chiuzz/STM32/Hokai/Software/Ctrl/readme.txt

本实验将实现如下功能：本实验移植的是3.03版本的UCOSIII，支持FPU。本实验通过建立3个简单的任务来测试UCOSIII的移植和FPU的移植是否移植成功。本实验要打开串口调试助手，我们观察到开发板上的LED0和LED1在闪烁，串口调试助手每500ms接收到一次开发板发送的数据，数据以0.01递增。

               	正点原子@ALIENTEK
               	2014-11-3
		广州市星翼电子科技有限公司
                联系电话（传真）：020-38271790
	       	购买：http://shop62103354.taobao.com
                      http://shop62057469.taobao.com
               	技术支持论坛：www.openedv.com
