chiuzz/STM32/Hokai/Hardware/屏背板/JD1622(V3.0).PCB.htm

Altium Reporting Options

# File in Newer Format

Date | : | 2017-7-14
Time | : | AM 10:05:55
Filename | : | E:\2017\TemperatureControl\Hardware\팁교겼\JD1622(V3.0).PCB

Version | Warning
6.9 | CAUTION - File contains one or more Component Bodies containing embedded STEP models. These models have be discarded.
6.9 | CAUTION - File contains one or more Components with pads with Pad Jumper IDs. The pads Pad Jumper ID fields have been discarded.
7.0 | CAUTION - File may contain Component Bodies with linked STEP models. These models will be discarded.
Winter 09 | CAUTION - Vias support varying diameters across layerstack. If this feature is used in design, extra values will be discarded.
Winter 09 | CAUTION - File may contain pads with hole offsets. Hole offset information will be discarded.
Winter 09 | CAUTION - File contains new manufacturing rules. Hole To Hole clearance, Minimum solder mask sliver, Silkscreen Over Exposed Copper and Silkscreen To Silkscreen Clearance rules were introduced in Altium Designer Winter 09.These rules will be discarded.
Winter 09 | CAUTION - 3D models now support texturing.If used in design these textures will be discarded.
Summer 09 | CAUTION - File contains new custom violations that replaced the old violation objects. These violations were introduced in Altium Designer Summer 09. The new custom violations will be discarded.
Summer 09 | CAUTION - Support was added for 32 Mechanical Layers. Objects on mechanical layers beyond 16 have been moved to Mechanical Layer 16.
Summer 09 | CAUTION - File contains assembly testpoint rules and/or settings. Assembly testpoint information will be discarded.
Release 10 | CAUTION - New Custom Grids and Guides were introduced. Be aware that your design might contain Custom Grids and Guides that cannot be read in previous versions.
Release 10 | CAUTION - New Structured Clusters were introduced. Be aware that your design might contain Structured Clusters that cannot be read in previous versions.
Release 10 | CAUTION - New PCB 3D Movie Manager was introduced. Be aware that your design might contain 3D PCB movie that cannot be read in previous versions.

This file was generated by later version of the software
