chiuzz/STM32/Hokai/Hardware/屏背板/屏背板修改事项.docx

屏背板修改事项：

1、 修改RJ45接PE引脚的封装
2、 修改9015/sot-23封装引脚
3、 修改显示屏玻璃控制引脚片1控制端的方向布局。（第一版方向刚好相反了）
4、 对每个IO添加了ESD静电管，
5、 对按键扫描添加了ESD静电管和串接了一个高频扼流圈
6、 74LS245芯片改用74HC245；
7、 铺地安全距离加宽到0.6mm
8、 取消PE铺铜；
9、 修改背光电源引脚的封装，由原来的1.2mm改为2.1mm；
10、 蜂鸣器改为有源5V 型号为KPX-1205;
