chiuzz/STM32/Hokai/Document/基准电源参数.docx

+V | -V | R | VZ | 7号温度 | V0
9.8V | 9.9V | 5.0954 K | 1.2060mV | 28.000 | 621.38
+V | -V | R | VZ | 7号温度 | V0
9.8V | 9.9V | 5.0957K | 1.2060mV | 28.000 | 621.40
