chiuzz/STM32/Hokai/Document/测温传感器数据.docx

体温传感器数据：

sense | 1 | 2 | 3 | 4 | 5 | 6 | 7
VZ | 1.2061V | 1.2061V | | 1.2061V | 1.2061V | 1.2061V | 1.2061V
R（K） | 5.1011 | 5.1011 | | 5.1011 | 5.1011 | 5.1011 | 5.1011
Vo(mV) | 601.86 | 604.42 | | 602.07 | 601.69 | 601.96 | 601.18
I | 116.7UA | 116.2UA | | 116.8uA | 116.8UA | 116.8UA | 116.8UA
温度℃ | 38.00 | 38.00 | | 38.000 | 38.000 | 38.000 | 38.000

sense | 1 | 2 | 3 | 4 | 5 | 6 | 7
VZ | 1.2061V | 1.2061V | | 1.2061V | 1.2061V | 1.2061V | 1.2061V
R（K） | 5.1011 | 5.1011 | | 5.1011 | 5.1011 | 5.1011 | 5.1011
Vo(mV) | 620.92 | 623.38 | | 621.17 | 621.05 | 621.03 | 620.76
I | 112.7UA | 112.2UA | | 112.8uA | 112.8UA | 112.8UA | 112.8UA
温度℃ | 28.000 | 28.000 | | 28.000 | 28.000 | 28.000 | 28.000

sense | 1 | 2 | 3 | 4 | 5 | 6 | 7
VZ | 1.2061V | 1.2061V | | 1.2061V | 1.2061V | 1.2061V | 1.2061V
R（K） | 5.1011 | 5.1011 | | 5.1011 | 5.1011 | 5.1011 | 5.1011
Vo(mV) | 591.83 | 594.64 | | 592.21 | 592.25 | 591.99 | 591.70
I | 118.4uA | 117.8UA | | 118.3uA | 118.3UA | 118.3UA | 116.5UA
温度℃ | 43.000 | 43.000 | | 43.025 | 43.025 | 43.002 | 43.001

水温传感器数据：

sense | 1 | 2 | 3 | 4 | 9 | 6 | 7
VZ | 1.2061V | | | 1.2061V | 1.2061V | 1.2061V | 1.2061V
R（K） | 5.1011 | | | 5.1011 | 5.1011 | 5.1011 | 5.1011
Vo(mV) | 66701 | | | 667.04 | 666.94 | 667.22 | 66701
I
温度℃ | 4.00 | | | 4.000 | 4.000 | 4.000 | 4.000

sense | 1 | 2 | 3 | 4 | 9 | 6 | 7
VZ | 1.2061V | | | 1.2061V | 1.2061V | 1.2061V | 1.2061V
R（K） | 5.1011 | | | 5.1011 | 5.1011 | 5.1011 | 5.1011
Vo(mV) | 632.66 | | | 632.43 | 601.69 | 632.93 | 632.72
I | 116.7UA | | | 116.8uA | 116.8UA | 116.8UA | 116.8UA
温度℃ | 22.000 | | | 22.000 | 22.000 | 22.000 | 22.000

sense | 1 | 2 | 3 | 4 | 5 | 6 | 7
VZ | 1.2061V | | | 1.2061V | 1.2061V | 1.2061V | 1.2061V
R（K） | 5.1011 | | | 5.1011 | 5.1011 | 5.1011 | 5.1011
Vo(mV) | 601.86 | | | 602.07 | 601.69 | 601.96 | 601.18
I | 116.7UA | | | 116.8uA | 116.8UA | 116.8UA | 116.8UA
温度℃ | 40.000 | | | 40.000 | 4.000 | 40.000 | 40.000
