chiuzz/STM32/Hokai/Hardware/Cool_MainControl_Board/修改的地方.docx

（1）修改了电解电容（6800uF，3300，680uF，47uF）的封装，其中封装包括圆柱的直径以及两引脚的间距。

（2）依照以前想把高精度电阻换掉的想法，这块板子的高精度电阻的封装加入了贴片封装。

（3）原来板子有三个分线的电阻，也修改了。电阻分别为：R9，R10，R81。
