chiuzz/STM32/Hokai/Document/第一版问题.docx

DS2480B+封装过大！(修改了)

HCNR201封装过少（修改了）

显示屏接口座20PIN位置不适合

S9015封装镜像（修改了）

+-12V电源基准电阻有8.66KΩ改为8.2KΩ时，输出电压+-12V较好(误差小)！

300欧姆的高精度电阻换成1K的高精度电阻

光耦隔离输出不要分压电阻。

调试高速光耦隔离放大倍数前要断开前级，下一版设计加上；
