chiuzz/STM32/Hokai/Software/二极管测温验证平台/和佳温度校准验证平台使用中遇到的问题.docx

和佳温度校准验证平台使用中遇到的问题

提交：苏大明

日期：2017/2/27

1. 处于“两点校准”模式时，校准时间到了之后，设定温度应该停在10度，但是它仍然会自动增加到18度。
2. 进行“温域测试”时，往文件中写数据的时候界面会很卡。
3. 进行“温域测试”时，设定的步幅是2度，但是它会每次增加4度。
4. 进行“温域测试”时，由于需要向文件中写10分钟的数据，写几次之后，左下角的时间显示会变慢几分钟。
5. 有时候，选择“两点校准”模式时，点击开始按钮之后，未进入校准模式（连接板子的串口指示灯红灯闪烁慢，说明处于校准模式）。
6. 程序运行期间，基准源有时候会挂掉（即基准源测量的温度不准确），能否在程序中监测基准源的输出，若其不正确，则停止运行。
7. 当“温域测试”为8度时，向文件中写数据不会停止，只能手动关闭程序。
8. CH3输出有时会有问题，输出值错误。
