chiuzz/STM32/Hokai/Hardware/Cool_MainControl_Board/IC资料/LM317.pdf

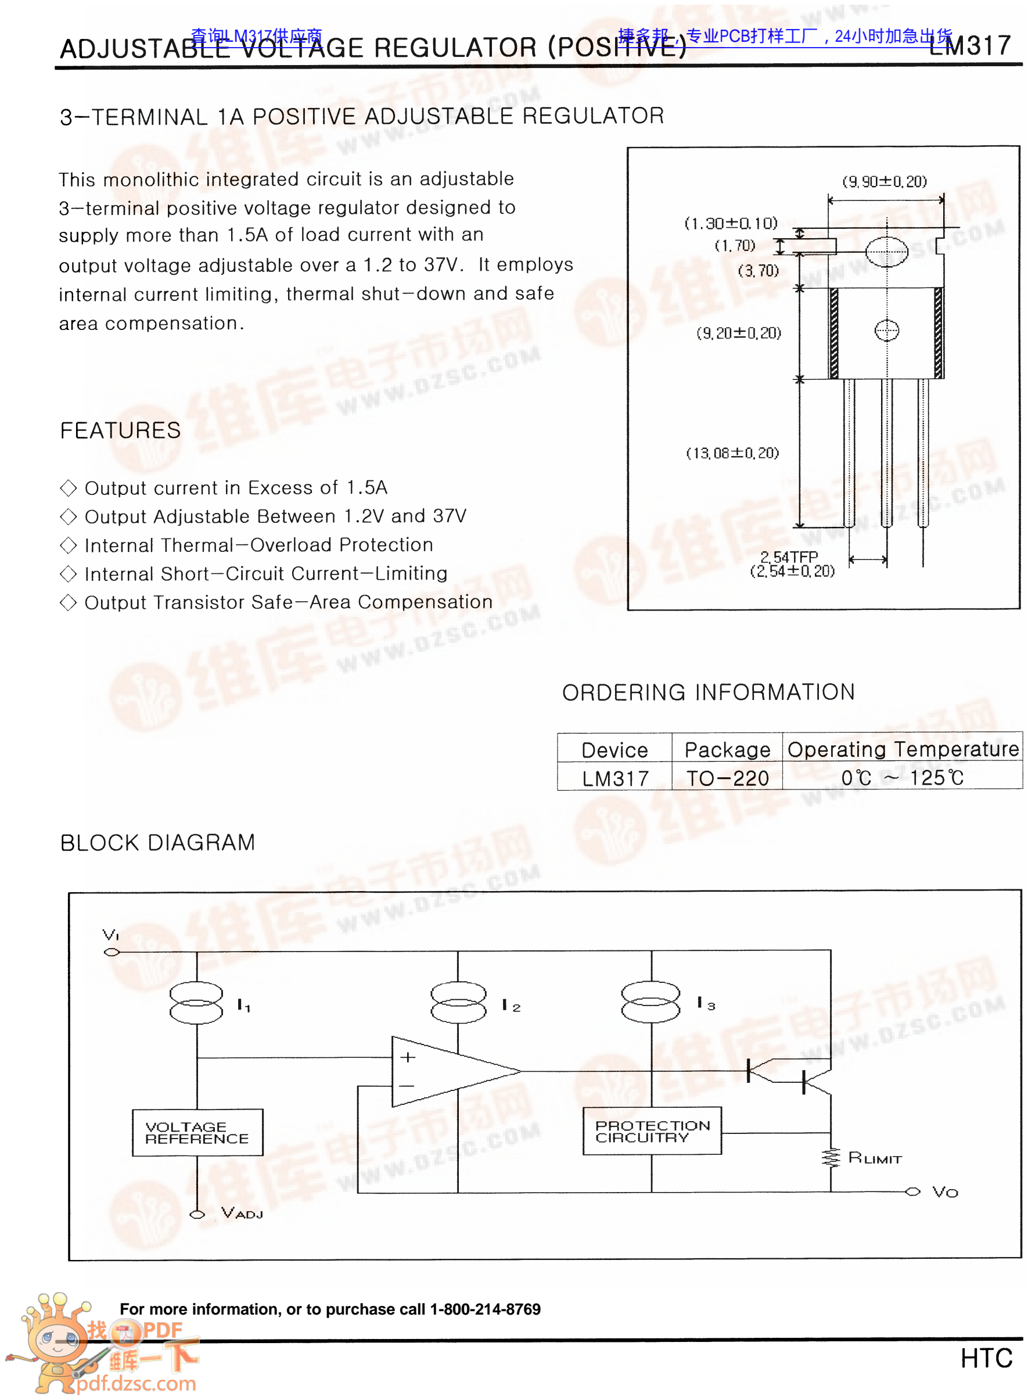
[picture p6: page 1]

For more information, (http://pdf.dzsc.com/) or to purchase call 1-800-214-8769

查询LM317供应商 (http://www.dzsc.com/stock_lm317.html) | 捷多邦，专业PCB打样工厂，24小时加急出货 (http://www.jdbpcb.com/J/)

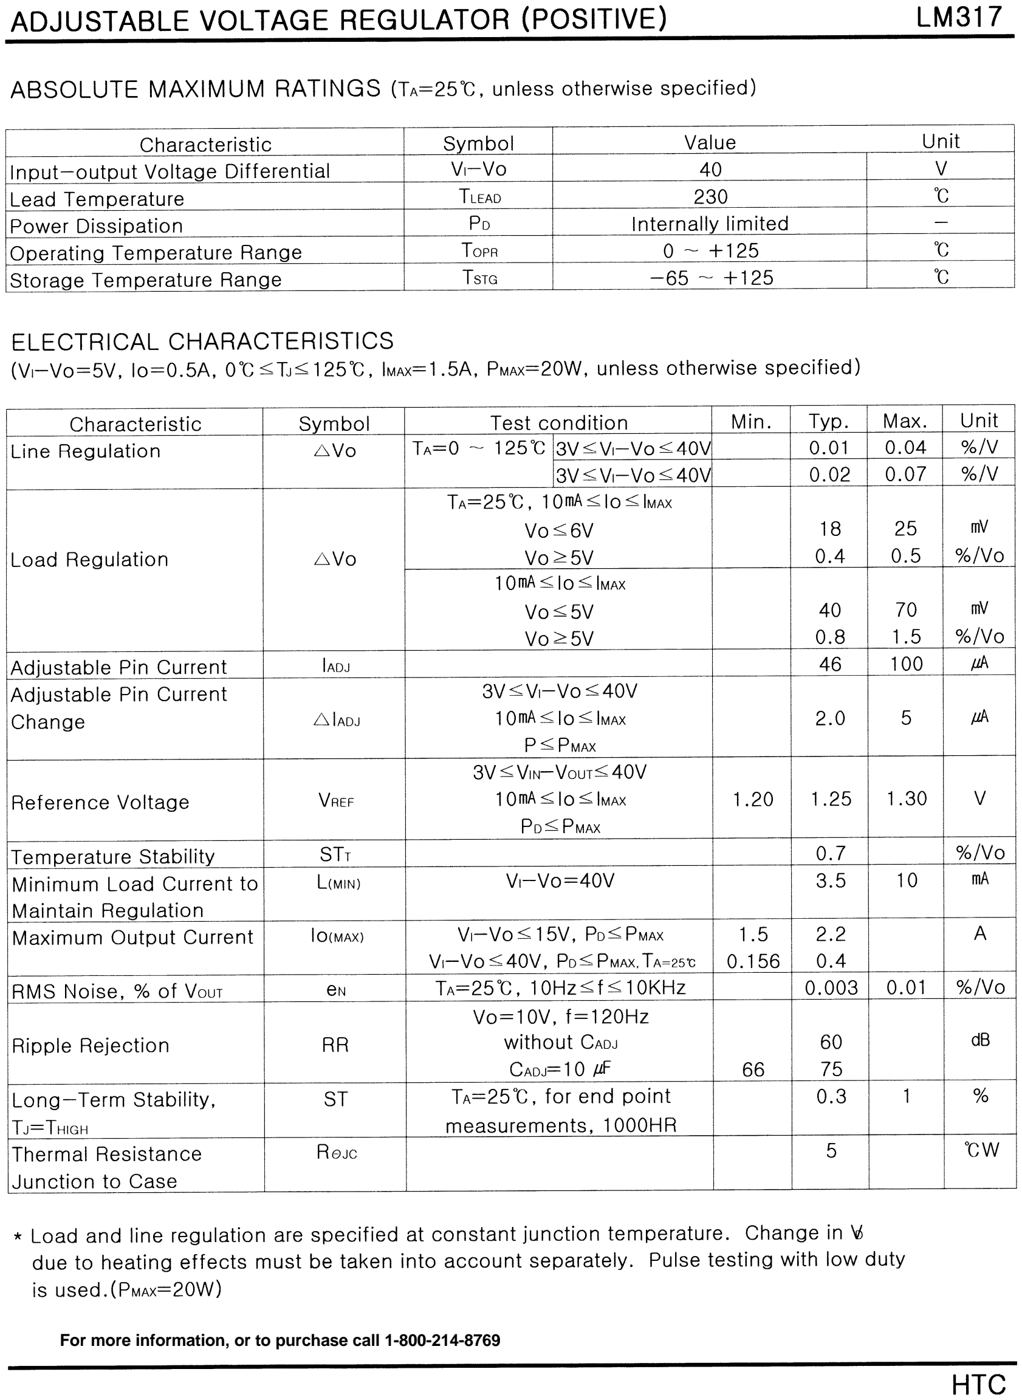
[picture p7: page 2]
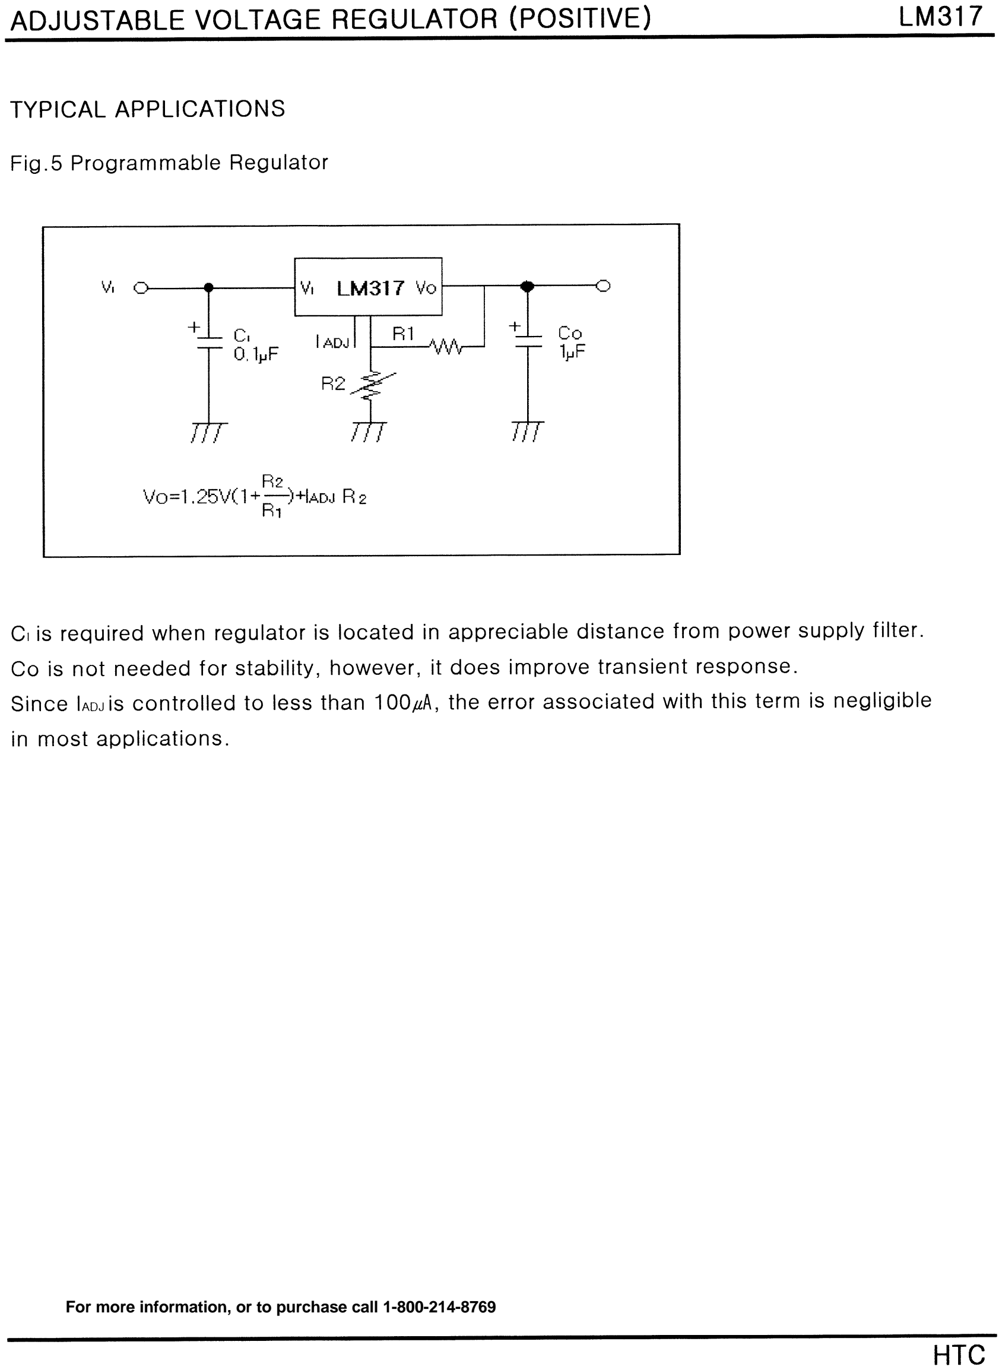
[picture p8: page 3]
