chiuzz/STM32/Hokai/Document/亚低温校准.jpg

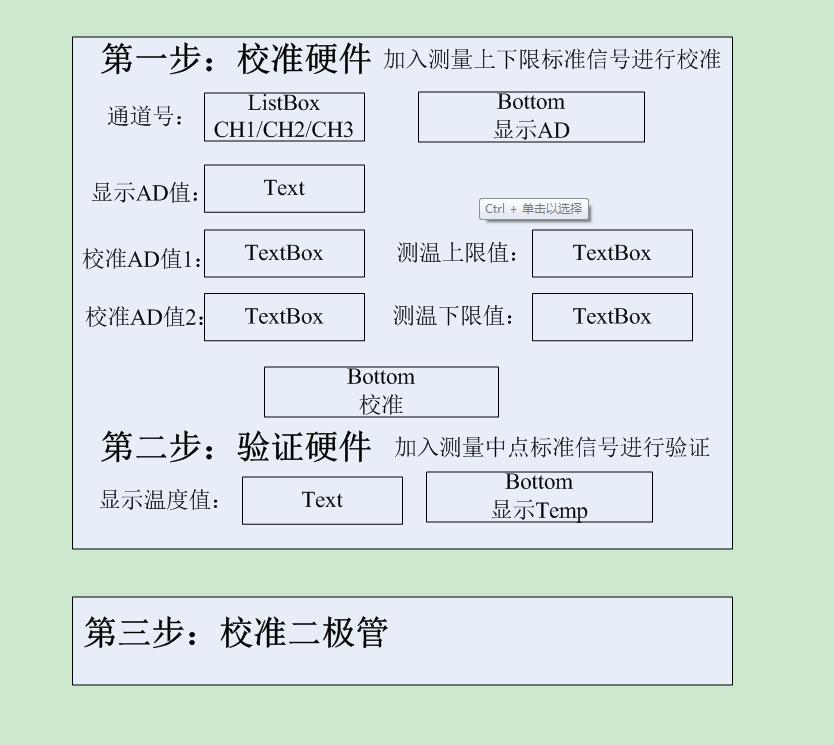
Hokai/Document/亚低温校准.jpg
