chiuzz/STM32/Hokai/Document/亚低温系统架构设计图.jpg

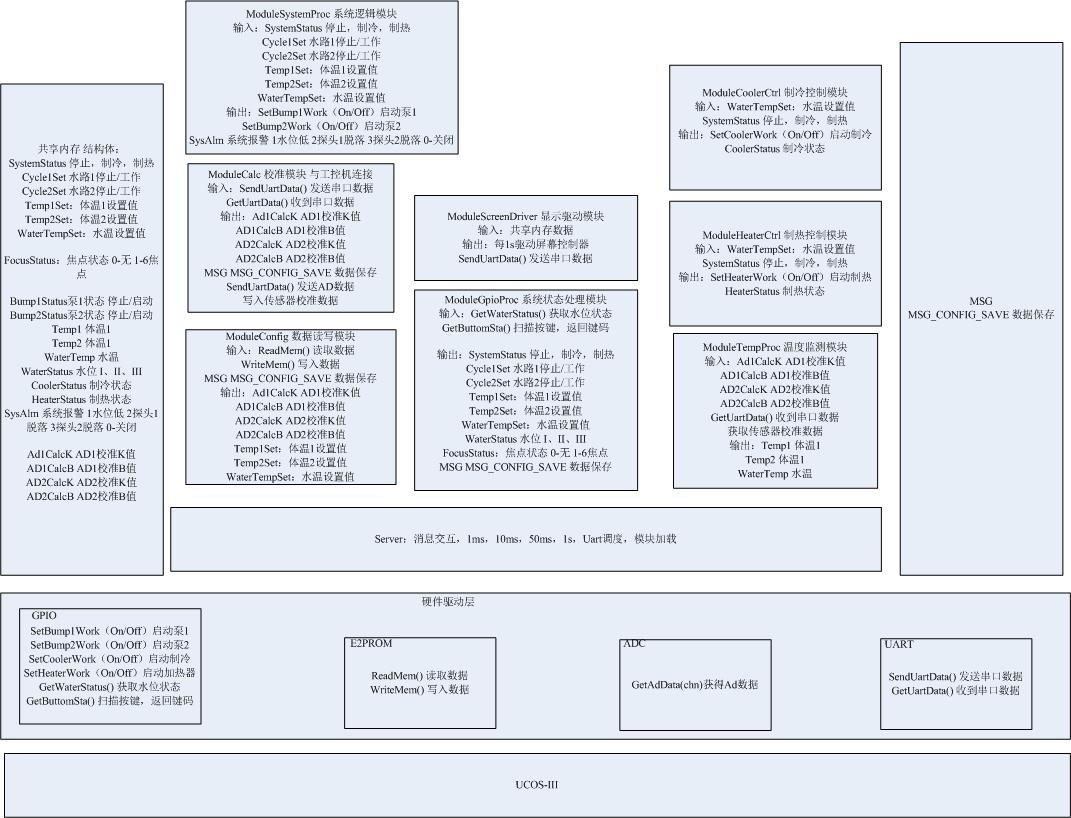
Hokai/Document/亚低温系统架构设计图.jpg
