chiuzz/STM32/Hokai/Document/亚低温屏背板BOM表清单.xls

亚低温屏背板BOM表清单
类别 | 封装 | 参数 | 备注 | 位置 | 数量
贴片电容 | C0805 | 102/0805 |  | C24, C29 | 2
 | C0805 | 103/0805 |  | C25 | 1
 | C0805 | 104/0805 |  | C1, C2, C3, C4, C5, C6, C8, C12, C13, C14, C15, C16, C17, C19, C20, C21, C23, C28 | 18
 | C0805 | 22p/0805 |  | C9, C10 | 2
 | C0805 | 105/0805 |  | C11, C26 | 2
 | C0805 | 2.2u/0805 |  | C27 | 1
 | C3216 | 10UF/16V | 钽电容 | C18 | 1
 | CAP5X5 | 4.7uF/16V | 电解电容 | C7 | 1
单排针 | 2.54mm*1-4 | 2.54mm | 调试串口引出脚 | CN1 | 1
双排针 | 2.54mm*2-10 | 2.54mm | 下载口 | JP1 | 1
单排针 | 2.54mm*1-6 | 2.54mm | 按键排线座 | P1 | 1
单排针 | 2.54mm*1-3 | 2.54mm | 预留LED控制端 | P9 | 1
有源蜂鸣器 | SPK | Speaker |  | LS1 | 1
贴片二极管 | SOD123 | IN4148 |  | D1 | 1
网线连接座 | RJ45 | RJ45 |  | P2 | 1
贴片电感 | L0805 | 10uH/0805 |  | L3, L4 | 2
贴片LED | LED0805 | 蓝色 |  | LED1, MCU_LED1 | 2
贴片PNP | SOT-23 - 9015 | C9015 |  | Q1，Q2 | 1
贴片扼流圈 | L0805 | FBMA-11-160808-601T |  | L1, L2, L5, L6, L7, L8 , L9, L10 | 8
贴片电阻 | R0805 | 100Ω/0.25W |  | R13, R14, R30, R32, R34, R35, R36, R37 | 8
 | R0805 | 1KΩ/0.25W |  | R1, R2, R19, R25 | 4
 | R0805 | 3kΩ/0.25W |  | R28, R33, R39 | 3
 | R0805 | 10kΩ/0.25W |  | R5, R6, R7, R8, R9, R10 , R12, R24 | 8
 | R0805 | 1MΩ/0.25W |  | R11 | 1
 | R0805 | NC |  | R29 | 1
 | R1206 | 100Ω/0.5W | 0.5W | RLED1, RLED2, RLED3 | 3
TVS | TVS | 6.0CA | 型号未知 | T1 | 1
贴片ESD静电二极管 | SOD323 | ESD05V32D-LC |  | TVS1, TVS2, TVS3, TVS4, TVS5, TVS6, TVS7, TVS8, TVS16, TVS17, TVS18 | 11
 | SOD323 | ESD15V32D-LC |  | TVS15 | 1
 | SOD323 | ESD08V32D-LC |  | TVS19, TVS20, TVS21, TVS22, TVS23, TVS24 | 6
IC | SOP-20 窄体 | 74HC245 |  | U1, U3 | 2
 | LC-LQFP-48_7x7x05P | STM32F103C | STM32单片机48脚 | U2 | 1
 | SOT-223-3L(M3) | AS1117M3-33/SOT-223 | 基准IC | U4 | 1
 | SSOP-48 | HT1621 | 段码屏驱动IC | U6, U7 | 2
贴片晶振 | 49smd | 8M Hz | 贴片晶振 | Y1 | 1
