chiuzz/STM32/Hokai/Document/亚低温控制板BOM表清单.xls

Sheet: BOM Report
亚低温控制板BOM表清单
类别 | 封装 | 参数 | 位置 | 备注 | 数量
CON2 | 3.96mm-2 | ~12V200mA | AC1, AC2, AC3,AC4 |  | 4
CON2 | 3.96mm-2 | ~15V300mA | , AC5 |  | 1
整流桥 | DB157S | DB157S | BR1, BR2, BR3, BR4, BR5 | BR | 5
贴片电容 | C0805 | 1nF/0805(102) | C77, C78, C79, C87, C88, C89, C90, C98, C99, C100, C101, C110 |  | 12
 | C0805 | 103/0805 | C35, C80, C81, C84, C85, C91, C92, C95, C96, C102, C103, C107, C108, C113, C118, C122, C126, C131, C135 | Capacitor | 19
 | C0805 | 104/0805 | C1, C2, C3, C4, C5, C6, C7, C9, C10, C16, C17, C18, C19, C20, C29, C30, C31, C32, C34, C45, C46, C47, C48, C49, C50,C51, C53, C55, C57, C59, C62, C65, C66, C70, C71, C72, C74, C75, C82, C83, C86, C93, C94, C97, C105, C106, C109, C112, C114, C115, C116, c117, C119, C121, C123, C124, C125, c127, C128, C130, C132, C133, C134, c136, C137, C138, C140, C142, C144, C145, C147, C150, C152, C153, C155, C159, C160, C161, C162, C163 | Capacitor | 80
 | C0805 | 105/0805 | C15, C76 | Capacitor | 2
 | C0805 | 0.47uF/50V | C38, C40, C42, C44 | Capacitor | 4
 | C0805 | 2.2μF/0805/50V/B | C73 |  | 1
 | C0805 | 22p/0805 | C12, C13 |  | 2
 | C0805 | 68pF/0805 | C111, C120, C129 |  | 3
 | C3216 | 10UF/16V | C67, C69, C156, C158 | Electrolytic Capacitor | 4
 | C6032 | 15uF/25V/钽电容 | C36, C37,C39, C41 | Electrolytic Capacitor | 4
 | CAP5X5 | 4.7uF/16V | C8 | Electrolytic Capacitor | 1
 | C10X10 | 220UF/25V | C43 | Electrolytic Capacitor | 1
电解电容 | RB.1/.2 | 47μF/25V/CE | C58, C63, C143, C148 |  | 4
 | RB.2/.4 | 470μF/25V/EC | C56, C64, C68，C141, C149,C157 |  | 6
 | RB.2/.4 | 680μF/25V/EC | C52, C60, C151, C154 |  | 4
 | RB.3/.6 | 3300μF/50V/CE | C54, C61, C139, C146 |  | 4
 | RB.3/.6 | 6800μF/25V/EC | C33 |  | 1
贴片二极管 | SOD123 | IN4148 | D1, D4, D5, D6, D7, D8, D9 |  | 7
 | SMB-2 | SK35 | D2, D3 | Zener Diode | 2
插件二极管 | DIODE0.2 | 1N4150/J | D10, D11, D12 |  | 3
 | DIODE0.2 | 3.3V/0.5W/DIODE0.2/J | DW1, DW2, DW3 |  | 3
2.54mm端子座 | XH2 | L_Wotor_Port | H1 |  | 1
 | XH2 | F_Wotor_Port | H2 |  | 1
 | XH2 | Heat_Port | H3 |  | 1
 | XH2 | Cool_Port | H4 |  | 1
 | XH2 | Body2_Sensor | H5 |  | 1
 | XH2 | Test_Sensor | H6 |  | 1
 | XH2 | Water_Sensor | H7 |  | 1
 | XH2 | DATA_EEPROM | J2, J4 |  | 2
固态继电器 | HHG1-REALY | HHG1D-1/032F-38 5Z | IC1, IC2 |  | 2
单排针 | 2.54*1 - 2 | 单排针2.54mm | J1, J6, J7, J8, J9, J10, J11, J12, J13, J14, J15, J16, J17，CN1 |  | 14
双排针 | 2.54*2 - 4 | 双排针2.54mm | J5 |  | 1
双排针 | 2.54*2 - 10 | 双排针2.54mm | JP1 |  | 1
双排针 | 2.54*2 - 3 | 双排针2.54mm | PE1 |  | 1
CON7 | HEADER1x7 | L_N_Port | JP3 |  | 1
NC |  |  | JP4 | NC | 1
贴片电感 | L0805 | 10uH/0805 | L1, L2 |  | 2
 | M-SMB7X7 | 33UH | L3, L4 |  | 2
插件电感 | AXIAL0.4 | 100μH/0.5W/J | L5, L6, L8, L9 |  | 4
 | AXIAL0.4 | 470μH/0.5W/J | L7, L10 |  | 2
贴片LED | LED_0805 | 蓝色 | LED1, LED2, LED5, LED6, LED9, MCU_LED1 |  | 6
 | LED_0805 | 绿色 | LED3,LED4, LED8， LED7 |  | 4
贴片光耦 | SOP4 | TLP280-1 | OP1 |  | 1
网线端子座 | RJ45 | RJ45 | P2 | 普通RJ45座 | 1
PNP三极管 | TO-92 | C9015/TO-92 | Q1, Q2, Q3 | PNP | 3
NPN三极管 | TO92A | 8050/NPN/TO92 | Q4 | NPN | 1
贴片电阻 | R0805 | 10kΩ/0.25W | R1, R2, R3, R4, R7, R12, R22, R25, R27, R28, R29, R30, R36, R38, R49, R51, R55, R56, R61, R63, R67, R68, R73, R75, R79, R80, R110, R113, R120 |  | 29
 | R0805 | 4.7KΩ/0.25W | R5 | Resistor | 1
 | R0805 | NC/0.25W | R6 | Resistor | 1
 | R0805 | 2kΩ/0805 | R8 |  | 1
 | R0805 | 1MΩ/0.25W | R11 |  | 1
 | R0805 | 200Ω/0.25W | R17, R18, R19 |  | 3
 | R0805 | 2000Ω/0.25W | R20 |  | 1
 | R0805 | 1KΩ/0.25W | R21, R43, R119 |  | 3
 | R0805 | 10Ω/1W/D | R23 |  | 1
 | R0805 | 0Ω/0.25W | R24, R33, R40, R41, R42, R45, R103, R117, R118 |  | 9
 | R0805 | 8.2kΩ/0.25W | R26 |  | 1
 | R0805 | 100Ω/0.25W | R31, R32 |  | 2
 | R0805 | 350Ω/0.25W | R34, R39, R107, R115 |  | 4
 | R0805 | 3kΩ/0.25W | R35, R37, R109, R112 |  | 4
 | R0805 | 1.5kΩ/0.25W | R44 |  | 1
 | R0805 | 200kΩ/0805/F | R85, R92, R99 |  | 3
高精度电阻 25ppm,0.1% | AXIAL0.4 | 3.3kΩ/DIP/0.1%/25ppm | R9, R10 |  | 2
 | AXIAL0.4 | 9.1kΩ/DIP/0.1%/25ppm | R48, R60 |  | 2
 | AXIAL-0.6-R | 560Ω/DIP/0.1%/25ppm | R104 |  | 1
 | AXIAL-0.6-R | 5.1kΩ/DIP/0.1%/25ppm | R71 |  | 1
 | AXIAL-0.6-R | 2kΩ/DIP/0.1%/25ppm | R70, R74 |  | 2
 | AXIAL0.4 | 1kΩ/DIP/0.1%/25ppm | R53, R54, R65, R66, R78 |  | 5
 | AXIAL0.4 | 5.6kΩ/DIP/0.1%/25ppm | R57, R69 |  | 2
 | AXIAL0.4 | 13kΩ/DIP/0.1%/25ppm | R72 |  | 1
 | AXIAL0.4 | 2.2kΩ/DIP/0.1%/25ppm | R77, R83, R90, R97 |  | 4
 | AXIAL0.4 | 1.8kΩ/DIP/0.1%/25ppm | R81 |  | 1
 | AXIAL0.4 | 6.2kΩ/DIP/0.1%/25ppm | R81 |  | 1
 | AXIAL0.4 | 200kΩ/DIP/0.1%/25ppm | R82, R89, R96 |  | 3
 | AXIAL0.4 | 240Ω/DIP/0.1%/25ppm | R84, R91, R98 |  | 3
 | AXIAL0.4 | 6.8kΩ/DIP/0.1%/25ppm | R86, R87, R93, R94, R100, R101 |  | 6
 | AXIAL0.4 | 33kΩ/DIP/0.1%/25ppm | R88, R95, R102 |  | 3
高精度电阻 10ppm 0.02% | AXIAL-0.6-R | 5.1kΩ/DIP/0.02%/10ppm | R52, R64，R76，R111 |  | 4
 | AXIAL-0.6-R | 10kΩ/DIP/0.02%/10ppm | R47, R59, R106 |  | 3
 | AXIAL-0.6-R | 2kΩ/DIP/0.02%/10ppm | R46, R50, R58, R62 |  | 4
 | AXIAL-0.6-R | 6.2kΩ/DIP/0.02%/10ppm | R105 |  | 1
 | AXIAL-0.6-R | 15kΩ/DIP/0.02%/10ppm | R108 |  | 1
 | AXIAL-0.6-R | 300Ω/DIP/0.02%/10ppm | R114 |  | 1
 | AXIAL-0.6-R | 14.1kΩ/DIP/0.02%/10ppm | R116 |  | 1
压敏电阻 | RV0.3 | 391K | RV1, RV2 |  | 2
ESD静电二极管 | NC | ESD15V32D-LC | TVS11, TVS16, TVS17, TVS18 | NC | 4
 | SOD323 | ESD08V32D-LC | TVS12, TVS13, TVS14, TVS15 |  | 4
集成IC | SO-8 | AT24C128 | U1 | EEPROM ,存储芯片 | 1
 | LQFP-100 | STM32F407VGT | U2 | STM32F407单片机 | 1
 | SOIC-16 | ULN2003 | U6 | 达林顿三极管集成IC | 1
 | TO263 | LM2596 | U7 | 5VDC-DC开关电源IC | 1
 | TO-263-7 | LM2676S-12 | U8 | 12DC-DC开关电源IC | 1
 | SOIC8_N | ADUM1201 | U9, U11, U12, U15 | 磁耦 | 4
 | SOIC8_N | DS2480B+ | U10, U13 | 单线EEPROM驱动IC | 2
 | SOP16 | MAX232 | U14 | 串口电平转换IC | 1
 | TO220H | LM337/TO-220H | U16, U39 | 线性可调稳压IC | 2
 | TO220H | LM317/TO-220H | U17, U42 | 线性可调稳压IC | 2
 | TO-220 | LM78L05 | U18, U43 | 线性电源稳压IC | 2
 | SOT-23-B | REF3333/SOT23 | U19 | 稳压IC | 1
 | SOT-223-3L(M3) | AS1117M3-33/SOT-223 | U20, U44 | 3.3VDC-DC | 2
 | SO-8 | LM358/SO-8 | U21, U24, U27 | 集成运放 | 3
 | SO-8 | OP07CZ/SO-8 | U22, U23, U25, U26, U28, U29, U30, U32, U33, U35, U36, U38, U40 | 集成运放 | 13
 | DIP08W | HCNR201/WDIP8 | U31, U34, U37 | 高速线性光耦 | 3
 | LM399 | LM399AH | U41 | 基准稳压IC | 1
 | SO-8 | MAX706AS/SO8 | U45 | 看门狗IC | 1
高精密 可调电位器 | 3224W | 500Ω/0.5W/G | RP1, RP3, RP5, RP6 |  | 4
 | 3224W | 200Ω/0.5W/G | RP2，RP4 |  | 2
 | 3224W | 100Ω/0.5W/G | VR1 |  | 1
 | 3224W | 20kΩ/0.5W/J | W1, W3, W5 |  | 3
 | 3224W | 10kΩ/0.5W/J | W2, W4, W6 |  | 3
插件晶振 | XTAL_SOCKET | 8.00MHz | Y2 |  | 1
安规电容 | CY1002 |  | Y3, Y4, Y5 | Capacitor | 3
 |  |  |  |  | 419

Sheet: Project Information
Project Full Path | E:\2017\TemperatureControl\Hardware\Cool_MainControl_Board\HGT-300.PrjPCB
Project Filename | HGT-300.PrjPCB
Variant Name | None
Data-Source Filename | HGT-300.PrjPCB
Data-Source Full Path | E:\2017\TemperatureControl\Hardware\Cool_MainControl_Board\HGT-300.PrjPCB
Title | <Parameter Title not found>
Total Quantity | 435
Report Time | 10:06:51
Report Date | 2017/7/26
Report Date & Tine | 2017/7/26 10:06:51
Output Name | Bill of Materials
Output Type | BOM_PartType
Output Generator Name | BOM
Output Generator Description | Bill of Materials
