chiuzz/STM32/Hokai/Hardware/Cool_MainControl_Board/Project Outputs for HGT-300/HGT-300-1.xls

Sheet: BOM Report
Bill of Materials |  |  | <Parameter Title not found>
Source Data From: |  | HGT-300.PrjPCB
Project: |  | 亚低温
Variant: |  | V20170407
Creation Date: | 2017-4-6 | AM 10:12:14
Print Date: | 42879 | 42879.63712
Footprint | Comment | LibRef | Designator | Description | Quantity
C0805 | 105/0805 | CAP | C98 | 贴片电容0805，1uF,50V | 1
C0805 | 104/0805 | CAP | C1, C2, C3, C4, C5, C6, C7, C8, C9, C10, C11, C12, C13, C14, C15, C16, C18, C19, ,C24, C25, C27, C28, C29, C30, C31, C32, C33, C34, C35, C36, C37, C38, C39, C41, C42, C44, C45, C47, C59, C60, C65, C66, C71, C73, C75, C77, C78, C80, C83, C85, C86, C88, C92, C93, C94, C96, C97, C104, C105, C109, C116,C117, C121, C128, C129, C133, C140, C141, C145 | 贴片电容0805，0.1uF,50V | 72
C0805 | 103/0805 | CAP | C48, C102, C103, C106, C107, C114, C115, C118, C119, C126, C127, C130, C131, C138, C139, C142, C143 | 贴片电容0805，0.01uF,50V | 17
 | 22pF/0805 | CAP | C20, C21, ,C22,C23 | 贴片瓷片电容
C0805 | 0.47uF/50V | CAP | C51, C53, C55, C58 | 贴片电容0805，0.47uF,50V | 4
C0805 | 2.2μF/0805/50V/B | CAP | C95 | 贴片电容0805，2.2uF,50V | 1
C0805 | 1nF/0805 | CAP | C99, C100, C101, C110, C111, C112, C113, C122, C123, C124, C125, C134, C135, C136, C137, C146 | 贴片电容0805，1nF,50V | 16
CAP5X5 | 4.7uF/16V | ELECTRO1 | C17 | 贴片电解电容，5mm*5mm | 1
C10X10 | 220UF/25V | ELECTRO1 | C56 | 贴片电解电容，10mm*10mm | 1
C6032 | 15uF/25V钽电容 | ELECTRO1 | C49, C50,C52, C54 | 贴片钽电容C形 | 4
C3216 | 10UF/16V | ELECTRO1 | C89, C91 | 贴片钽电容A形 | 2
RB.1/.2 | 10μF/25V/CE | ELECTRO2 | C76, C81 | 直插式电解电容 | 2
RB.2/.4 | 47μF/25V/CE | ELECTRO2 | C74, C82 | 直插式电解电容 | 2
RB.2/.4 | 100μF/25V/EC | ELECTRO2 | C84, C87, C90 | 直插式电解电容 | 3
RB.3/.6 | 330μF/50V/CE | ELECTRO2 | C46,C72, C79 | 直插式电解电容 | 3
SMA | 1N4148/SMA | D, DIODE | D1, D4, D5, D6, D7, D8, D9, D10, D11 | 二极管SMA | 9
SMB-2 | SK35 | ZENER2 | D2, D3 | 二极管SMB | 2
L0805 | 10uH/0805 | INDUCTOR1 | L1, L2 | 贴片电感0805 | 2
M-SMB7X7 | 33UH | INDUCTOR2 | L3, L4 | 贴片电感7mm*7mm | 2
AXIAL0.4 | 100μH/0.5W/J | INDUCTOR2 | L5, L6 | 直插式电感 | 2
AXIAL0.4 | 470μH/0.5W/J | INDUCTOR2 | L7 | 直插式电感 | 1
L0805 | FBMA-11-160808-601T | INDUCTOR0 | FBMA1, FBMA2, FBMA3, FBMA4, FBMA5, FBMA6, FBMA7, FBMA8, FBMA9, FBMA10, FBMA11, FBMA12, FBMA13, FBMA14 | 贴片扼流圈，0805 | 14
LED_0805 | SC_12V_Green | LED0805 | LED1 | 贴片LED | 1
LED_0805 | SC_5V_Green | LED0805 | LED2 | 贴片LED | 1
LED_0805 | -12v_Green | B_LED | LED3 | 贴片LED | 1
LED_0805 | +12_Green | B_LED | LED4 | 贴片LED | 1
LED_0805 | MCU_3.3V_Green | LED0805 | LED5 | 贴片LED | 1
LED_0805 | MCU_5V_Green | LED0805 | LED6 | 贴片LED | 1
LED_0805 | L0805_GREEN | LED0805 | MCU_LED1 | 贴片LED | 1
R0805 | 10kΩ/0.25W | RE, RES2 | R1, R2, R3, R4, R5, R10, R11, R14, R15, R16, R17, R18, R23, R26, R37, R40, R54, R56, R60, R61, R66, R68, R72, R73, R78, R80, R84, R85, R90, R92, R96, R97 | 贴片电阻，0.25W,精度F(1%) | 32
R0805 | 4.7KΩ/0.25W | Res2 | R6, R7 | 贴片电阻，0.25W,精度F(1%) | 2
R0805 | 1kΩ/0.25W | RES2 | R8, R34, R42, R47 | 贴片电阻，0.25W,精度F(1%) | 4
R0805 | 0Ω/0.25W | RES2 | R9, R25, R30, R44, R45, R46, R49, R50 | 贴片电阻，0.25W,精度F(1%) | 8
R0805 | 1MΩ/0.25W | RES2 | R12, R13 | 贴片电阻，0.25W,精度F(1%) | 2
R0805 | 330Ω/0.25W | RES2 | R19, R20, R21, R22 | 贴片电阻，0.25W,精度F(1%) | 4
R0805 | 10Ω/1W/D | RES2 | R24 | 贴片电阻，0.25W,精度F(1%) | 1
R0805 | 8.2kΩ/0.25W | RES2 | R27 | 贴片电阻，0.25W,精度F(1%) | 1
R0805 | 100Ω/0.25W | RES2 | R28, R29 | 贴片电阻，0.25W,精度F(1%) | 2
R0805 | 8.2kΩ/0.25W | RES2 | R36, R39 | 贴片电阻，0.25W,精度F(1%) | 2
R0805 | 1.5kΩ/0.25W | RES2 | R48 | 贴片电阻，0.25W,精度F(1%) | 1
AXIAL-0.6-R | 4.7KΩ/DIP/0.1%/25ppm | RES2 | R31 | 直插式电阻，精度0.02%,25ppm | 1
AXIAL-0.6-R | 6.2kΩ/DIP/0.1%/25ppm | RES3 | R32 | 直插式电阻，精度0.02%,25ppm | 1
AXIAL-0.6-R | 10kΩ/DIP/0.1%/25ppm | RES3 | R33 | 直插式电阻，精度0.02%,25ppm | 1
AXIAL-0.6-R | 15kΩ/DIP/0.1%/25ppm | RES3 | R35, R43 | 直插式电阻，精度0.02%,25ppm | 2
AXIAL-0.6-R | 5.1kΩ/DIP/0.1%/25ppm | RES2 | R38, R52, R57, R64, R69, R76, R81,R88, R93 | 直插式电阻，精度0.02%,25ppm | 9
AXIAL-0.6-R | 300Ω/DIP/0.1%/25ppm | RES2 | R41 | 直插式电阻，精度0.02%,25ppm | 1
AXIAL-0.6-R | 2kΩ/DIP/0.1%/25ppm | RES2 | R51, R55, R63, R67, R75, R79, R87, R91 | 直插式电阻，精度0.02%,25ppm | 8
AXIAL-0.6-R | 20kΩ/DIP/0.1%/25ppm | RES2 | R53, R65, R77, R89 | 直插式电阻，精度0.02%,25ppm | 4
AXIAL-0.6-R | 4.3kΩ/DIP/0.1%/25ppm | RES2 | R58, R70, R82, R94 | 直插式电阻，精度0.02%,25ppm | 4
AXIAL-0.6-R | 1kΩ/DIP/0.1%/25ppm | RES2 | R59, R71, R83, R95 | 直插式电阻，精度0.02%,25ppm | 4
AXIAL-0.6-R | 5.6kΩ/DIP/0.1%/25ppm | RES2 | R62, R74, R86, R98 | 直插式电阻，精度0.02%,25ppm | 4
3224W | 5kΩ/0.5W/G | RPOT | RP1, RP2, RP3, RP4, RP5, RP6, RP7, RP8, VR1 | 贴片可调电位器 | 9
RV0.3 | 391K | VARISTOR | RV1, RV2 | 压敏电阻 | 2
SOD323 | ESD08V32D-LC | TVS | TVS1, TVS7, TVS8, TVS9, TVS10, TVS12, TVS13, TVS14, TVS15, TVS16, TVS17, TVS18, TVS19 | ESD静电二极管 | 13
SOD323 | ESD05V32D-LC | TVS | TVS2, TVS3, TVS4, TVS5, TVS6 | ESD静电二极管 | 5
SOD323 | ESD15V32D-LC | TVS | TVS11, TVS20, TVS21, TVS22, TVS23 | ESD静电二极管 | 5
LQFP-100 | STM32F407VGT | STM32F407VGT | U2 | STM32F407'单片机 | 1
SOIC8_N | ADUM1100 | ADUM1100 | U3 | 磁耦 | 1
SOIC8_N | ADUM1200 | ADUM1200 | U4, U5 | 磁耦 | 2
SOIC8_N | ADUM1201 | ADUM1201 | U9, U11, U13, U14 | 磁耦 | 4
SOIC8 | DS2480B+ | DS2480B+ | U10, U12, U15, U16 | 单线EEPROM | 4
SO-8 | AT24C128 | 24WC02 | U1 | EEPROM | 1
SO-8 | OP07CZ/SO-8 | OP07CZ | U19, U26, U27, U29, U30, U32, U33, U35, U36 | 运放 | 9
SO-8 | LM358/SO-8 | MC1458D | U25, U28, U31, U34 | 双运放 | 4
DC-DC | DC-DC5V | DC-DC5V | U6, U17 | 电源隔离 | 2
TO263 | LM2596 | LM2596 | U7 | 5V开关电源 | 1
TO-263-7 | LM2676S-12 | LM2676 | U8 | 12V开关电源 | 1
TO220H | LM337/TO-220H | LM337 | U18 | 可调线性负电源IC | 1
TO220H | LM317/TO-220H | LM317 | U21 | 可调线性正电源IC | 1
TO-220 | LM78L05 | LM78L05 | U23 | 5V线性电源 | 1
LM399 | LM399AH | LM399AH | U20 | 电压基准芯片 | 1
SOT-23-B | REF3333/SOT23 | REF33x | U22 | 3.3V参考电源IC | 1
SOT-223_1 | AS1117M3-33/SOT-223 | LT1117 | U24 | 3.3V电源IC | 1
XTAL4 | 32.768KHz | CRYSTAL | Y1 | 晶振 | 1
XTAL_SOCKET | 8.00MHz | CRYSTAL | Y2 | 晶振 | 1
DB157S | 整流桥 | NBRIDGE1 | BR1, BR2, BR3 | 整流桥 | 3
SPST-REALY | HHG1D-1/032F-38 5Z | OPTOTRIAC | IC1, IC2 | '欣大固态继电器HHG1D-1/032F-38 5Z | 2
XH2 | L_Wotor_Port | CON2 | H1 | XH2端子座2.54mm | 1
XH2 | F_Wotor_Port | CON2 | H2 | XH2端子座2.54mm | 1
XH2 | Heat_Port | CON2 | H3 | XH2端子座2.54mm | 1
XH2 | Cool_Port | CON2 | H4 | XH2端子座2.54mm | 1
XH2 | Body2_Sensor | CON2 | H5 | XH2端子座2.54mm | 1
XH2 | Test_Sensor | CON2 | H6 | XH2端子座2.54mm | 1
XH2 | Woter_Sensor | CON2 | H7 | XH2端子座2.54mm | 1
XH2 | Body1_Sensor | CON2 | H8 | XH2端子座2.54mm | 1
XH2 | DATA_EEPROM | CON2 | J1, J2, J3, J4 | XH2端子座2.54mm | 4
3Pin-2.54 | TEST-232 | CON3 | J5 | XH3端子座2.54mm | 1
IDC20_A | JTAG | JTAG20 | JP1 | 2*20PIN 下载座 | 1
IDC20_A | Screnn_Port | C | JP2 | 2*20PIN 接线座 | 1
HEADER1x7 | L_N_Port | CON7 | JP3 | 接线端子座7.6mm*7pin | 1
HEADER2 | ~12V600mA | CON2 | AC1, AC2, AC3 | 接线端子座5.08mm*2pin | 3
HEADER1X2B | Screen_Power_Port | CON2 | JP4 | 直针接插座4mm*2pin | 1
TESTSMD | MCU_+5V | CON1 | MCU_+1 |  | 1
TESTSMD | MCU_GND | CON1 | MCU_GND1 |  | 1
TESTSMD | SC12V | CON1 | P1 |  | 1
TESTSMD | SC_5V | CON1 | P2 |  | 1
TESTSMD | SC_GND | CON1 | P3 |  | 1
TESTSMD | VZ | CON1 | P4 |  | 1
TESTSMD | V_Body2 | CON1 | P5 |  | 1
TESTSMD | V_Test | CON1 | P6 |  | 1
TESTSMD | Woter | CON1 | P7 |  | 1
TESTSMD | Body1 | CON1 | P8 |  | 1
TESTSMD | VO1_VEE_-12V | CON1 | VO1 |  | 1
TESTSMD | VO3_GND | CON1 | VO2 |  | 1
TESTSMD | VO2_VCC_+12V | CON1 | VO3 |  | 1
 |  |  |  |  | 376
Approved |  | Notes

Sheet: Project Information
Project Full Path | E:\2017\TemperatureControl\Hardware\Cool_MainControl_Board\HGT-300.PrjPCB
Project Filename | HGT-300.PrjPCB
Variant Name | None
Data-Source Filename | HGT-300.PrjPCB
Data-Source Full Path | E:\2017\TemperatureControl\Hardware\Cool_MainControl_Board\HGT-300.PrjPCB
Title | <Parameter Title not found>
Total Quantity | 394
Report Time | AM 10:12:14
Report Date | 2017-4-6
Report Date & Tine | 2017-4-6 AM 10:12:14
Output Name | Bill of Materials
Output Type | BOM_PartType
Output Generator Name | BOM
Output Generator Description | Bill of Materials
