chiuzz/STM32/Hokai/Hardware/Cool_MainControl_Board/Project Outputs for HGT-300/HGT-300-2.xls

Sheet: BOM Report
Bill of Materials |  |  | <Parameter Title not found>
Source Data From: |  | HGT-300.PrjPCB
Project: |  | HGT-300.PrjPCB
Variant: |  | None
Creation Date: | 2017-4-21 | PM 02:27:13
Print Date: | 42926 | 42926.72973
Footprint | Comment | LibRef | Designator | Description | Quantity
HEADER2 | ~12V600mA | CON2 | AC1, AC2, AC3 |  | 3
HEADER2 | ~12V300mA | CON2 | AC4, AC5 |  | 2
DB157S | 整流桥 | NBRIDGE1 | BR1 | BR | 1
DB157S |  | NBRIDGE1 | BR2, BR3, BR4, BR5 | BR | 4
C0805 | 104/0805 | CAP | C1, C2, C3, C4, C5, C6, C7, C8, C9, C10, C11, C12, C13, C14, C15, C16, C18, C19, C20, C21, C22, C23, C24, C25, C26, C27, C28, C29, C30, C31, C32, C33, C34, C35, C36, C37, C38, C39, C40, C41, C43, C55, C56, C57, C59, C61, C63, C65, C68, C71, C72, C76, C77, C78, C80, C81, C88, C89, C92, C99, C100, C103, C110, C111, C114, C128, C130, C131, C133, C135, C137, C138, C140, C142, C144, C145, C147, C155, C157, C159, C161, C162, C164, C167, C169, C170, C172, C176, C177, C178, C179, C180 | Capacitor | 92
CAP5X5 | 4.7uF/16V | ELECTRO1 | C17 | Electrolytic Capacitor | 1
RB.3/.6 | 330μF/50V/EC | ELECTRO2 | C42 |  | 1
C0805 | 103/0805 | CAP | C44, C86, C87, C90, C91, C97, C98, C101, C102, C108, C109, C112, C113, C129, C132, C136, C139, C143, C146 | Capacitor | 19
C6032 | 15uF/25V/钽电容 | ELECTRO1 | C45, C46, C48, C50 | Electrolytic Capacitor | 4
C0805 | 0.47uF/50V | CAP | C47, C49, C51, C53 | Capacitor | 4
C10X10 | 220UF/25V | ELECTRO1 | C52 | Electrolytic Capacitor | 1
RB.2/.4 | 100μF/25V/EC | ELECTRO2 | C58, C66, C74, C168, C171, C174 |  | 6
RB.3/.6 | 330μF/50V/CE | ELECTRO2 | C60, C67, C156, C163 |  | 4
RB.2/.4 | 47μF/25V/CE | ELECTRO2 | C62, C70, C158, C166 |  | 4
RB.1/.2 | 10μF/25V/CE | ELECTRO2 | C64, C69, C160, C165 |  | 4
C3216 | 10UF/16V | ELECTRO1 | C73, C75, C173, C175 | Electrolytic Capacitor | 4
C0805 | 2.2μF/0805/50V/B | CAP | C79 |  | 1
C0805 | 105/0805 | CAP | C82 |  | 1
C0805 | 1nF/0805 | CAP | C83, C84, C85, C93, C94, C95, C96, C104, C105, C106, C107, C115 |  | 12
C0805 | 47pF/0805 | CAP | C127, C134, C141 |  | 3
SMB | DIODE | DIODE | D1, D4, D5, D6, D7, D8, D9 |  | 7
SMB-2 | SK35 | ZENER2 | D2, D3 | Zener Diode | 2
DIODE0.2 | 1N4150/J | DIODE0 | D12, D13, D14 |  | 3
DIODE0.2 | 5.1V/0.5W/DIODE0.2/J | ZENER0 | DW1, DW2, DW3 |  | 3
L0805 | FBMA-11-160808-601T | INDUCTOR0 | FBMA1, FBMA2, FBMA3, FBMA4, FBMA5, FBMA6, FBMA7, FBMA8, FBMA9, FBMA10, FBMA11, FBMA12, FBMA13, FBMA14 |  | 14
XH2 | L_Wotor_Port | CON2 | H1 |  | 1
XH2 | F_Wotor_Port | CON2 | H2 |  | 1
XH2 | Heat_Port | CON2 | H3 |  | 1
XH2 | Cool_Port | CON2 | H4 |  | 1
XH2 | Body2_Sensor | CON2 | H5 |  | 1
XH2 | Test_Sensor | CON2 | H6 |  | 1
XH2 | Woter_Sensor | CON2 | H7 |  | 1
HHG1-REALY | HHG1D-1/032F-38 5Z | OPTOTRIAC | IC1, IC2 |  | 2
4Pin-2.54 | RS/TS | CON4 | J1 | Connector | 1
XH2 | DATA_EEPROM | CON2 | J2, J3, J4 |  | 3
3Pin-2.54 | TEST-232 | CON3 | J5 | Connector | 1
2Pin-2.54 | CON2 | CON2 | J6, J7, J8, J9, J10, J11 |  | 6
IDC20_A | JTAG | JTAG20 | JP1 |  | 1
IDC20_A | Screnn_Port | C | JP2 |  | 1
HEADER1x7 | L_N_Port | CON7 | JP3 |  | 1
HEADER1X2B | Screen_Power_Port | CON2 | JP4 |  | 1
L0805 | 10uH/0805 | INDUCTOR1 | L1, L2 |  | 2
M-SMB7X7 | 33UH | INDUCTOR2 | L3, L4 |  | 2
AXIAL0.4 | 100μH/0.5W/J | INDUCTOR2 | L5, L6, L8, L9 |  | 4
AXIAL0.4 | 470μH/0.5W/J | INDUCTOR2 | L7, L10 |  | 2
LED_0805 | LED0805 | LED0805 | LED1, LED2, LED5, LED6, LED9, MCU_LED1 |  | 6
LED_0805 | -12v_Green | B_LED | LED3, LED7 |  | 2
LED_0805 | +12_Green | B_LED | LED4, LED8 |  | 2
TESTSMD | MCU_GND | CON1 | MCU_GND1 |  | 1
TESTSMD | SC12V | CON1 | P1 |  | 1
TESTSMD | SC_5V | CON1 | P2 |  | 1
TESTSMD | SC_GND | CON1 | P3 |  | 1
TESTSMD | V_Body2 | CON1 | P4 |  | 1
TESTSMD | V_Test | CON1 | P5 |  | 1
TESTSMD | Woter | CON1 | P6 |  | 1
TESTSMD | ADC | CON1 | P9, P11, P13 |  | 3
TESTSMD | VEE_-12V | CON1 | P16 |  | 1
TESTSMD | VZ | CON1 | P17 |  | 1
TESTSMD | VCC_+12V | CON1 | P18 |  | 1
TO-92B | C9015/TO-92 | PNP | Q1, Q2, Q3 |  | 3
TO92A | 8050/NPN/TO92 | NPN | Q5 |  | 1
R0805 | 10kΩ/0.25W | RES2 | R1, R2, R3, R4, R5, R10, R11, R14, R15, R16, R17, R18, R23, R26, R33, R35, R46, R48, R52, R53, R58, R60, R64, R65, R70, R72, R76, R77, R86, R87, R130, R133 |  | 32
R0805 | 4.7KΩ/0.25W | Res2 | R6, R7 | Resistor | 2
R0805 | 1kΩ/0.25W | RES2 | R8, R31, R36, R40, R127, R135, R139 |  | 7
R0805 | 0Ω/0.25W | RES2 | R9, R25, R30, R37, R38, R39, R42, R123, R137, R138 |  | 10
R0805 | 1MΩ/0.25W | RES2 | R12, R13 |  | 2
R0805 | 330Ω/0.25W | RES2 | R19, R20, R21, R22 |  | 4
R0805 | 10Ω/1W/D | RES2 | R24 |  | 1
R0805 | 8.2kΩ/0.25W | RES2 | R27 |  | 1
R0805 | 100Ω/0.25W | RES2 | R28, R29 |  | 2
R0805 | 8.66kΩ/0.25W | RES2 | R32, R34, R129, R132 |  | 4
R0805 | 1.5kΩ/0.25W | RES2 | R41 |  | 1
AXIAL-0.6-R | 2kΩ/DIP/0.1%/25ppm | RES2 | R43, R47, R55, R59, R67, R71 |  | 6
AXIAL-0.6-R | 5.1kΩ/DIP/0.1%/25ppm | RES2 | R44, R49, R56, R61, R68, R73, R131 |  | 7
AXIAL-0.6-R | 20kΩ/DIP/0.1%/25ppm | RES2 | R45, R57, R69 |  | 3
AXIAL-0.6-R | 4.3kΩ/DIP/0.1%/25ppm | RES2 | R50, R62, R74 |  | 3
AXIAL-0.6-R | 1kΩ/DIP/0.1%/25ppm | RES2 | R51, R63, R75 |  | 3
AXIAL-0.6-R | 5.6kΩ/DIP/0.1%/25ppm | RES2 | R54, R66, R78 |  | 3
AXIAL-0.6-R | 180kΩ/DIP/0.1%/25ppm | RES2 | R91, R99, R107 |  | 3
AXIAL-0.6-R | 2.2kΩ/DIP/0.1%/25ppm | RES2 | R92, R100, R108 |  | 3
AXIAL-0.6-R | 240Ω/DIP/0.1%/25ppm | RES2 | R93, R101, R109 |  | 3
R0805 | 200kΩ/0805/F | RES2 | R94, R102, R110 |  | 3
AXIAL-0.6-R | 6.8kΩ/DIP/0.1%/25ppm | RES2 | R95, R96, R103, R104, R111, R112 |  | 6
AXIAL-0.6-R | 33kΩ/DIP/0.1%/25ppm | RES2 | R97, R105, R113 |  | 3
R0805 | 3kΩ/0805/F | RES2 | R98, R106, R114 |  | 3
AXIAL-0.6-R | 4.7KΩ/DIP/0.1%/25ppm | RES2 | R124 |  | 1
AXIAL-0.6-R | 6.2kΩ/DIP/0.1%/25ppm | RES3 | R125 |  | 1
AXIAL-0.6-R | 10kΩ/DIP/0.1%/25ppm | RES3 | R126 |  | 1
AXIAL-0.6-R | 15kΩ/DIP/0.1%/25ppm | RES3 | R128, R136 |  | 2
AXIAL-0.6-R | 300Ω/DIP/0.1%/25ppm | RES2 | R134 |  | 1
3224W | 5kΩ/0.5W/G | RPOT | RP1, RP2, RP3, RP4, RP5, RP6, VR1 |  | 7
RV0.3 | 391K | VARISTOR | RV1, RV2 |  | 2
SOD323 | ESD08V32D-LC | TVS | TVS1, TVS7, TVS8, TVS9, TVS10, TVS13, TVS15, TVS16, TVS17, TVS18, TVS19 |  | 11
SOD323 | ESD05V32D-LC | TVS | TVS2, TVS3, TVS4, TVS5, TVS6 |  | 5
SOD323 | ESD15V32D-LC | TVS | TVS11, TVS20, TVS21, TVS22 |  | 4
SO-8 | AT24C128 | 24WC02 | U1 |  | 1
LQFP-100 | STM32F407VGT | STM32F407VGT | U2 |  | 1
SOIC8_N | ADUM1100 | ADUM1100 | U3 |  | 1
SOIC8_N | ADUM1200 | ADUM1200 | U4, U5 |  | 2
TO263 | LM2596 | LM2596 | U6 |  | 1
TO-263-7 | LM2676S-12 | LM2676 | U7 |  | 1
SOIC8_N | ADUM1201 | ADUM1201 | U8, U10, U12, U13 |  | 4
SOIC8 | DS2480B+ | DS2480B+ | U11, U14, U15 |  | 3
DC-DC | DC-DC5V | DC-DC5V | U16 |  | 1
TO220H | LM337/TO-220H | LM337 | U17, U46 |  | 2
TO220H | LM317/TO-220H | LM317 | U18, U49 | L | 2
SOT-23-B | REF3333/SOT23 | REF33XX | U19 |  | 1
TO-220 | LM78L05 | LM78L05 | U20, U50 |  | 2
SOT-223-3L(M3) | AS1117M3-33/SOT-223 | AS1117M3-33 | U21, U51 |  | 2
SO-8 | LM358/SO-8 | MC1458D | U22, U25, U28 |  | 3
SO-8 | OP07CZ/SO-8 | OP07CZ | U23, U24, U26, U27, U29, U30, U34, U36, U37, U39, U40, U42, U47 |  | 13
DIP08 | HCNR201/WDIP8 | HCNR201 | U35, U38, U41 |  | 3
LM399 | LM399AH | LM399AH | U48 |  | 1
TESTSMD | VO1_VEE_-12V | CON1 | VO1 |  | 1
TESTSMD | VO2_VCC_+12V | CON1 | VO2 |  | 1
3224W | 50kΩ/0.5W/J | RPOT | W1, W3, W5 |  | 3
3224W | 10kΩ/0.5W/J | RPOT | W2, W4, W6 |  | 3
XTAL4 | 32.768KHz | CRYSTAL | Y1 |  | 1
XTAL_SOCKET | 8.00MHz | CRYSTAL | Y2 |  | 1
 |  |  |  |  | 465
Approved |  | Notes

Sheet: Project Information
Project Full Path | E:\2017\TemperatureControl\Hardware\Cool_MainControl_Board\HGT-300.PrjPCB
Project Filename | HGT-300.PrjPCB
Variant Name | None
Data-Source Filename | HGT-300.PrjPCB
Data-Source Full Path | E:\2017\TemperatureControl\Hardware\Cool_MainControl_Board\HGT-300.PrjPCB
Title | <Parameter Title not found>
Total Quantity | 465
Report Time | PM 02:27:13
Report Date | 2017-4-21
Report Date & Tine | 2017-4-21 PM 02:27:13
Output Name | Bill of Materials
Output Type | BOM_PartType
Output Generator Name | BOM
Output Generator Description | Bill of Materials
