chiuzz/STM32/Hokai/Hardware/Cool_MainControl_Board/Project Outputs for HGT-300/HGT-300.xls

Sheet: BOM Report
Bill of Materials |  |  | <Parameter Title not found>
Source Data From: |  | HGT-300.PrjPCB
Project: |  | HGT-300.PrjPCB
Variant: |  | None
Creation Date: | 2017-4-21 | PM 01:33:56
Print Date: | 42858 | 42858.48606
Footprint | Comment | LibRef | Designator | Description | Quantity
C0805 | 105/0805 | CAP | C82 | 贴片电容0805，1uF,50V | 1
C0805 | 104/0805 | CAP | C1, C2, C3, C4, C5, C6, C7, C8, C9, C10, C11, C12, C13, C14, C15, C16, C18, C19, C20, C21, C22, C23, C24, C25, C26, C27, C28, C29, C30, C31, C32, C33, C34, C35, C36, C37, C38, C39, C40, C41, C43, C55, C56, C57, C59, C61, C63, C65, C68, C71, C72, C76, C77, C78, C80, C81, C88, C89, C92, C99, C100, C103, C110, C111, C114, C128, C130, C131, C133, C135, C137, C138, C140, C142, C144, C145, C147, C155, C157, C159, C161, C162, C164, C167, C169, C170, C172, C176, C177, C178, C179, C180 | 贴片电容0805，0.1uF,50V | 92
C0805 | 103/0805 | CAP | C44, C86, C87, C90, C91, C97, C98, C101, C102, C108, C109, C112, C113, C129, C132, C136, C139, C143, C146 | 贴片电容0805，0.01uF,50V | 19
C0805 | 0.47uF/50V | CAP | C47, C49, C51, C53 | 贴片电容0805，0.47uF,50V | 4
C0805 | 2.2μF/0805/50V/B | CAP | C79 | 贴片电容0805，2.2uF,50V | 1
C0805 | 1nF/0805 | CAP | C83, C84, C85, C93, C94, C95, C96, C104, C105, C106, C107, C115 | 贴片电容0805，1nF,50V | 12
C0805 | 47pF/0805 | CAP | C127, C134, C141 | 贴片电容0805，47pF,50V | 3
C6032 | 15uF/25V/钽电容 | ELECTRO1 | C48, C50,C45, C46 | 贴片钽电容C形 | 4
C3216 | 10UF/16V | ELECTRO1 | C73, C75, C173, C175 | 贴片钽电容A形 | 4
C10X10 | 220UF/25V | ELECTRO1 | C52 | 贴片电解电容，10mm*10mm | 1
CAP5X5 | 4.7uF/16V | ELECTRO1 | C17 | 贴片电解电容，5mm*5mm | 1
RB.3/.6 | 330μF/50V/EC | ELECTRO2 | C42 | 直插式电解电容 | 1
RB.3/.6 | 330μF/50V/CE | ELECTRO2 | C60, C67, C156, C163 | 直插式电解电容 | 4
RB.2/.4 | 47μF/25V/CE | ELECTRO2 | C62, C70, C158, C166 | 直插式电解电容 | 4
RB.2/.4 | 100μF/25V/EC | ELECTRO2 | C58, C66, C74, C168, C171, C174 | 直插式电解电容 | 6
RB.1/.2 | 10μF/25V/CE | ELECTRO2 | C64, C69, C160, C165 | 直插式电解电容 | 4
L0805 | FBMA-11-160808-601T | INDUCTOR0 | FBMA1, FBMA2, FBMA3, FBMA4, FBMA5, FBMA6, FBMA7, FBMA8, FBMA9, FBMA10, FBMA11, FBMA12, FBMA13, FBMA14 | 贴片扼流圈，0805 | 14
L0805 | 10uH/0805 | INDUCTOR1 | L1, L2 | 贴片电感0805 封装 | 2
M-SMB7X7 | 33UH | INDUCTOR2 | L3, L4 | 贴片电感7mm*7mm | 2
AXIAL0.4 | 100μH/0.5W/J | INDUCTOR2 | L5, L6, L8, L9 | 直插式电感 | 4
AXIAL0.4 | 470μH/0.5W/J | INDUCTOR2 | L7, L10 | 直插式电感 | 2
R0805 | 10kΩ/0.25W | RES2 | R1, R2, R3, R4, R5, R10, R11, R14, R15, R16, R17, R18, R23, R26, R33, R35, R46, R48, R52, R53, R58, R60, R64, R65, R70, R72, R76, R77, R86, R87, R130, R133 | 贴片电阻，0.25W,精度F(1%) | 32
R0805 | 4.7KΩ/0.25W | Res2 | R6, R7 | 贴片电阻，0.25W,精度F(1%) | 2
R0805 | 1kΩ/0.25W | RES2 | R8, R31, R36, R40, R127, R135, R139 | 贴片电阻，0.25W,精度F(1%) | 7
R0805 | 0Ω/0.25W | RES2 | R9, R25, R30, R37, R38, R39, R42, R123, R137, R138 | 贴片电阻，0.25W,精度F(1%) | 10
R0805 | 1MΩ/0.25W | RES2 | R12, R13 | 贴片电阻，0.25W,精度F(1%) | 2
R0805 | 330Ω/0.25W | RES2 | R19, R20, R21, R22 | 贴片电阻，0.25W,精度F(1%) | 4
R0805 | 10Ω/1W/D | RES2 | R24 | 贴片电阻，0.25W,精度F(1%) | 1
R0805 | 8.2kΩ/0.25W | RES2 | R27 | 贴片电阻，0.25W,精度F(1%) | 1
R0805 | 100Ω/0.25W | RES2 | R28, R29 | 贴片电阻，0.25W,精度F(1%) | 2
R0805 | 8.66kΩ/0.25W | RES2 | R32, R34, R129, R132 | 贴片电阻，0.25W,精度F(1%) | 4
R0805 | 1.5kΩ/0.25W | RES2 | R41 | 贴片电阻，0.25W,精度F(1%) | 1
R0805 | 200kΩ/0.25W | RES2 | R94, R102, R110 | 贴片电阻，0.25W,精度F(1%) | 3
R0805 | 3kΩ/0.25W | RES2 | R98, R106, R114 | 贴片电阻，0.25W,精度F(1%) | 3
AXIAL-0.6-R | 2kΩ/DIP/0.02%10ppm | RES2 | R43, R47, R55, R59, R67, R71 | 直插式电阻，精度0.02%,10ppm | 6
AXIAL-0.6-R | 5.1kΩ/DIP/0.02%10ppm | RES2 | R44, R49, R56, R61, R68, R73, R131 | 直插式电阻，精度0.02%,10ppm | 7
AXIAL-0.6-R | 20kΩ/DIP/0.02%10ppm | RES2 | R45, R57, R69 | 直插式电阻，精度0.02%,10ppm | 3
AXIAL-0.6-R | 4.3kΩ/DIP/0.02%10ppm | RES2 | R50, R62, R74 | 直插式电阻，精度0.02%,10ppm | 3
AXIAL-0.6-R | 1kΩ/DIP/0.02%10ppm | RES2 | R51, R63, R75 | 直插式电阻，精度0.02%,10ppm | 3
AXIAL-0.6-R | 5.6kΩ/DIP/0.02%10ppm | RES2 | R54, R66, R78 | 直插式电阻，精度0.02%,10ppm | 3
AXIAL-0.6-R | 180kΩ/DIP/0.02%10ppm | RES2 | R91, R99, R107 | 直插式电阻，精度0.02%,10ppm | 3
AXIAL-0.6-R | 2.2kΩ/DIP/0.02%10ppm | RES2 | R92, R100, R108 | 直插式电阻，精度0.02%,10ppm | 3
AXIAL-0.6-R | 240Ω/DIP/0.02%10ppm | RES2 | R93, R101, R109 | 直插式电阻，精度0.02%,10ppm | 3
AXIAL-0.6-R | 6.8kΩ/DIP/0.02%10ppm | RES2 | R95, R96, R103, R104, R111, R112 | 直插式电阻，精度0.02%,10ppm | 6
AXIAL-0.6-R | 33kΩ/DIP/0.02%10ppm | RES2 | R97, R105, R113 | 直插式电阻，精度0.02%,10ppm | 3
AXIAL-0.6-R | 180kΩ/DIP/0.1%25ppm | RES2 | R91, R99, R107 | 直插式电阻，精度0.1%,25ppm | 3
AXIAL-0.6-R | 2.2kΩ/DIP/0.1%25ppm | RES2 | R92, R100, R108 | 直插式电阻，精度0.1%,25ppm | 3
AXIAL-0.6-R | 240Ω/DIP/0.1%25ppm | RES2 | R93, R101, R109 | 直插式电阻，精度0.1%,25ppm | 3
AXIAL-0.6-R | 6.8kΩ/DIP/0.1%25ppm | RES2 | R95, R96, R103, R104, R111, R112 | 直插式电阻，精度0.1%,25ppm | 6
AXIAL-0.6-R | 33kΩ/DIP/0.1%25ppm | RES2 | R97, R105, R113 | 直插式电阻，精度0.1%,25ppm | 3
AXIAL-0.6-R | 4.7KΩ/DIP/0.02%10ppm | RES2 | R124 | 直插式电阻，精度0.02%,10ppm | 1
AXIAL-0.6-R | 6.2kΩ/DIP/0.02%10ppm | RES3 | R125 | 直插式电阻，精度0.02%,10ppm | 1
AXIAL-0.6-R | 10kΩ/DIP/0.02%10ppm | RES3 | R126 | 直插式电阻，精度0.02%,10ppm | 1
AXIAL-0.6-R | 15kΩ/DIP/0.02%10ppm | RES3 | R128, R136 | 直插式电阻，精度0.02%,10ppm | 2
AXIAL-0.6-R | 300Ω/DIP/0.02%10ppm | RES2 | R134 | 直插式电阻，精度0.02%,10ppm | 1
3224W | 5kΩ/0.5W/G | RPOT | RP1, RP2, RP3, RP4, RP5, RP6, VR1 | 贴片可调电位器 | 7
3224W | 50kΩ/0.5W/J | RPOT | W1, W3, W5 | 贴片可调电位器 | 3
3224W | 10kΩ/0.5W/J | RPOT | W2, W4 | 贴片可调电位器 | 2
3224W | 10kΩ/0.5W | RPOT | W6 | 贴片可调电位器 | 1
RV0.3 | 391K | VARISTOR | RV1, RV2 | 压敏电阻 | 2
SMB | '1N4148 | DIODE | D1, D4, D5, D6, D7, D8, D9 | SMB贴片封装二极管 | 7
SMB-2 | SK35 | ZENER2 | D2, D3 | SMB贴片封装二极管 | 2
DIODE0.2 | 1N4150/J | DIODE0 | D12, D13, D14 | 直插式稳压管 | 3
DIODE0.2 | 5.1V/0.5W/DIODE0.2/J | ZENER0 | DW1, DW2, DW3 | 直插式稳压管 | 3
LED_0805 | LED0805 | LED0805 | LED1, LED2, LED5, LED6, LED9, MCU_LED1 | 贴片LED | 6
LED_0805 | -12v_Green | B_LED | LED3, LED7 | 贴片LED | 2
LED_0805 | +12_Green | B_LED | LED4, LED8 | 贴片LED | 2
SOD323 | ESD08V32D-LC | TVS | TVS1, TVS7, TVS8, TVS9, TVS10, TVS13, TVS15, TVS16, TVS17, TVS18, TVS19 | ESD静电二极管，贴片 | 11
SOD323 | ESD05V32D-LC | TVS | TVS2, TVS3, TVS4, TVS5, TVS6 | ESD静电二极管，贴片 | 5
SOD323 | ESD15V32D-LC | TVS | TVS11, TVS20, TVS21, TVS22 | ESD静电二极管，贴片 | 4
LQFP-100 | STM32F407VGT | STM32F407VGT | U2 | STM32F407单片机 | 1
LM399 | LM399AH | LM399AH | U48 | 电压基准芯片 | 1
TO-92B | C9015 | PNP | Q1, Q2, Q3 | 直插式PNP三极管 | 3
TO92A | 8050 | NPN | Q5 | 直插式NPN三极管 | 1
TO-220 | LM78L05 | LM78L05 | U20, U50 | 5V线性电源 | 2
TO220H | LM337/TO-220H | LM337 | U17, U46 | 可调线性负电源IC | 2
TO220H | LM317/TO-220H | LM317 | U18, U49 | 可调线性正电源IC | 2
TO263 | LM2596 | LM2596 | U6 | 5V电源IC,贴片 | 1
TO-263-7 | LM2676S-12 | LM2676 | U7 | 12V电源IC,贴片 | 1
SOIC16 | ULN2003 | ULN2003 | U01 | 贴片达林顿2003 | 1
SOIC8_N | ADUM1201 | ADUM1201 | U8, U10, U12, U13 | 磁耦 | 4
SOIC8 | DS2480B+ | DS2480B+ | U11, U14, U15 | 单线EEPROM | 3
DC-DC | DC-DC5V | DC-DC5V | U16 | 电源隔离芯片，直插式 | 1
SOT-23-B | REF3333/SOT23 | REF33XX | U19 | 3.3V参考电源IC | 1
SOT-223-3L(M3) | AS1117M3-33/SOT-223 | AS1117M3-33 | U21, U51 | 3.3V电源IC | 2
SOIC8_N | ADUM1100 | ADUM1100 | U3 | 磁耦 | 1
SOIC8_N | ADUM1200 | ADUM1200 | U4, U5 | 磁耦 | 2
SO-8 | AT24C128 | 24WC02 | U1 | EEPROM | 1
SO-8 | LM358/SO-8 | MC1458D | U22, U25, U28 | 双运放 | 3
SO-8 | OP07CZ/SO-8 | OP07CZ | U23, U24, U26, U27, U29, U30, U34, U36, U37, U39, U40, U42, U47 | 单'运放 | 13
DIP08 | HCNR201/WDIP8 | HCNR201 | U35, U38, U41 | 快速光耦 | 3
XTAL_SOCKET | 8.00MHz | CRYSTAL | Y2 | 晶振 | 1
XTAL4 | 32.768KHz | CRYSTAL | Y1 | 晶振 | 1
HHG1-REALY | HHG1D-1/032F-38 5Z | OPTOTRIAC | IC1, IC2 | 欣大固态继电器HHG1D-1/032F-38 5Z | 2
4Pin-2.54 | RS/TS | CON4 | J1 | 2.54mm排针 | 1
3Pin-2.54 | TEST-232 | CON3 | J5 | 2.54mm排针 | 1
2Pin-2.54 | CON2 | CON2 | J6, J7, J8, J9, J10, J11 | 2.54mm排针 | 6
IDC20_A | JTAG | JTAG20 | JP1 | 2*10PIN 下载座 | 1
IDC20_A | Screnn_Port | C | JP2 | 2*10PIN 接线座 | 1
HEADER1x7 | L_N_Port | CON7 | JP3 | 接线端子座7.6mm*7pin | 1
HEADER1X2B | Screen_Power_Port | CON2 | JP4 | 接线端子座5.08mm*2pin | 1
HEADER2 | ~12V600mA | CON2 | AC1, AC2, AC3 | 直针接插座4mm*2pin | 3
HEADER2 | ~12V300mA | CON2 | AC4, AC5 | 直针接插座4mm*2pin | 2
DB157S | 整流桥 | NBRIDGE1 | BR1 | 贴片整流桥 | 1
DB157S | 整流桥 | NBRIDGE1 | BR2, BR3, BR4, BR5 | 贴片整流桥 | 4
XH2 | DATA_EEPROM | CON2 | J2, J3, J4 | XH2端子座2.54mm | 3
XH2 | L_Wotor_Port | CON2 | H1 | XH2端子座2.54mm | 1
XH2 | F_Wotor_Port | CON2 | H2 | XH2端子座2.54mm | 1
XH2 | Heat_Port | CON2 | H3 | XH2端子座2.54mm | 1
XH2 | Cool_Port | CON2 | H4 | XH2端子座2.54mm | 1
XH2 | Body2_Sensor | CON2 | H5 | XH2端子座2.54mm | 1
XH2 | Test_Sensor | CON2 | H6 | XH2端子座2.54mm | 1
XH2 | Woter_Sensor | CON2 | H7 | XH2端子座2.54mm | 1
Y电容 | JD102K2HY5P | 1000pF | Y01,Y02 | 安规Y电容 | 8
TESTSMD | VO1_VEE_-12V | CON1 | VO1 |  | 1
TESTSMD | VO2_VCC_+12V | CON1 | VO2 |  | 1
TESTSMD | MCU_GND | CON1 | MCU_GND1 |  | 1
TESTSMD | SC12V | CON1 | P1 |  | 1
TESTSMD | SC_5V | CON1 | P2 |  | 1
TESTSMD | SC_GND | CON1 | P3 |  | 1
TESTSMD | V_Body2 | CON1 | P4 |  | 1
TESTSMD | V_Test | CON1 | P5 |  | 1
TESTSMD | Woter | CON1 | P6 |  | 1
TESTSMD | ADC | CON1 | P9, P11, P13 |  | 3
TESTSMD | VEE_-12V | CON1 | P16 |  | 1
TESTSMD | VZ | CON1 | P17 |  | 1
TESTSMD | VCC_+12V | CON1 | P18 |  | 1
 |  |  |  |  | 492
Approved |  | Notes

Sheet: Project Information
Project Full Path | E:\2017\TemperatureControl\Hardware\Cool_MainControl_Board\HGT-300.PrjPCB
Project Filename | HGT-300.PrjPCB
Variant Name | None
Data-Source Filename | HGT-300.PrjPCB
Data-Source Full Path | E:\2017\TemperatureControl\Hardware\Cool_MainControl_Board\HGT-300.PrjPCB
Title | <Parameter Title not found>
Total Quantity | 465
Report Time | PM 01:33:56
Report Date | 2017-4-21
Report Date & Tine | 2017-4-21 PM 01:33:56
Output Name | Bill of Materials
Output Type | BOM_PartType
Output Generator Name | BOM
Output Generator Description | Bill of Materials
