chiuzz/STM32/Hokai/Hardware/Cool_MainControl_Board/Project Outputs for HGT-300/HGT-310.xls

Sheet: BOM Report
Bill of Materials |  |  | Bill of Materials For PCB Document [HGT-300.PcbDoc]
Source Data From: |  | HGT-300.PcbDoc
Project: |  | HGT-300.PrjPCB
Variant: |  | None
Creation Date: | 2017-6-22 | PM 03:49:57
Print Date: | 42920 | 42920.37296
Footprint | Comment | LibRef | Designator | Description | Quantity | 单价 | 总价
HEADER2 | ~12V300mA | CON2 | AC1, AC4, AC5 |  | 3 | 0.5 | 1.5
HEADER2 | ~12V600mA | CON2 | AC2, AC3 |  | 2 | 0.5 | 1
DB157S |  | NBRIDGE1 | BR1, BR2, BR3, BR4, BR5 | BR | 5 | 0.8 | 4
C0805 | 104/0805 | CAP | C1, C2, C3, C4, C5, C6, C7, C9, C10, C15, C16, C17, C18, C19, C20, C29, C30, C31, C32, C34, C45, C51, C53, C55, C57, C59, C62, C65, C66, C70, C71, C72, C74, C75, C82, C83, C86, C93, C94, C97, C105, C106, C109, C112, C114, C115, C116, c117, C119, C121, C123, C124, C125, C127, C128, C130, C132, C133, C134, c135, C137, C138, C140, C142, C144, C145, C147, C150, C152, C153, C155, C159, C160, C161, C162, C163 | Capacitor | 76 | 0.1 | 7.6
CAP5X5 | 4.7uF/16V | ELECTRO1 | C8 | Electrolytic Capacitor | 1 | 0.5 | 0.5
C0805 | 22p/0805 | CAP | C11, C12, C13, C14 |  | 4 | 0.1 | 0.4
C0805 | 330P/0805 | CAP | C21, C22, C23, C24, C25, C26, C27, C28 |  | 8 | 0.1 | 0.8
RB.3/.6 | 330μF/50V/EC | ELECTRO2 | C33 |  | 1 | 0.8 | 0.8
C0805 | 103/0805 | CAP | C35, C80, C81, C84, C85, C91, C92, C95, C96, C102, C103, C107, C108, C113, C118, C122, C126, C131, C136 | Capacitor | 19 | 0.1 | 1.9
C6032 | 15uF/25V/钽电容 | ELECTRO1 | C36, C37 | Electrolytic Capacitor | 2 | 1 | 2
C0805 | 0.47uF/50V | CAP | C38, C40, C42, C44 | Capacitor | 4 | 0.1 | 0.4
C6032 |  | ELECTRO1 | C39, C41 | Electrolytic Capacitor | 2 | 1 | 2
C10X10 | 220UF/25V | ELECTRO1 | C43 | Electrolytic Capacitor | 1 | 1 | 1
C0805 | 104 | Cap | C46, C47, C48, C49, C50 | Capacitor | 5 | 0.1 | 0.5
RB.2/.4 | 100μF/25V/EC | ELECTRO2 | C52, C60, C68, C151, C154, C157 |  | 6 | 0.5 | 3
RB.3/.6 | 330μF/50V/CE | ELECTRO2 | C54, C61, C139, C146 |  | 4 | 0.8 | 3.2
RB.2/.4 | 47μF/25V/CE | ELECTRO2 | C56, C64, C141, C149 |  | 4 | 0.5 | 2
RB.1/.2 | 10μF/25V/CE | ELECTRO2 | C58, C63, C143, C148 |  | 4 | 0.5 | 2
C3216 | 10UF/16V | ELECTRO1 | C67, C69, C156, C158 | Electrolytic Capacitor | 4 | 0.5 | 2
C0805 | 2.2μF/0805/50V/B | CAP | C73 |  | 1 | 0.3 | 0.3
C0805 | 105/0805 | CAP | C76 |  | 1 | 0.1 | 0.1
C0805 | 1nF/0805 | CAP | C77, C78, C79, C87, C88, C89, C90, C98, C99, C100, C101, C110 |  | 12 | 0.1 | 1.2
C0805 | 47pF/0805 | CAP | C111, C120, C129 |  | 3 | 0.1 | 0.3
4Pin-2.54 | SCREEN2 | CON4 | CN1 | Connector | 1 | 0.5 | 0.5
SOD123 | DIODE | DIODE | D1, D4, D5, D6, D7, D8, D9 |  | 7 | 0.2 | 1.4
SMB-2 | SK35 | ZENER2 | D2, D3 | Zener Diode | 2 | 1 | 2
DIODE0.2 | 1N4150/J | DIODE0 | D10, D11, D12 |  | 3 | 0.3 | 0.9
DIODE0.2 | 5.1V/0.5W/DIODE0.2/J | ZENER0 | DW1, DW2, DW3 |  | 3 | 0.3 | 0.9
L0805 | FBMA-11-160808-601T | INDUCTOR0 | FBMA1, FBMA2, FBMA3, FBMA4, FBMA5, FBMA6, FBMA7, FBMA8, FBMA9, FBMA10 |  | 10 | 0.1 | 1
XH2 | L_Wotor_Port | CON2 | H1 |  | 1 | 0.4 | 0.4
XH2 | F_Wotor_Port | CON2 | H2 |  | 1 | 0.4 | 0.4
XH2 | Heat_Port | CON2 | H3 |  | 1 | 0.4 | 0.4
XH2 | Cool_Port | CON2 | H4 |  | 1 | 0.4 | 0.4
XH2 | Body2_Sensor | CON2 | H5 |  | 1 | 0.4 | 0.4
XH2 | Test_Sensor | CON2 | H6 |  | 1 | 0.4 | 0.4
XH2 | Water_Sensor | CON2 | H7 |  | 1 | 0.4 | 0.4
HHG1-REALY | HHG1D-1/032F-38 5Z | OPTOTRIAC | IC1, IC2 |  | 2 | 23 | 46
2Pin-2.54 | CON2 | CON2 | J1, J6, J7, J8, J9, J10, J11, J12, J13, J14, J15, J16, J17 |  | 13 | 0.2 | 2.6
XH2 | DATA_EEPROM | CON2 | J2, J4 |  | 2 | 0.4 | 0.8
IDC4*2 | RS/TS | CON8 | J3 |  | 1 | 0.5 | 0.5
4Pin-2.54 | MXA232 | CON3 | J5 | Connector | 1 | 0.6 | 0.6
IDC20_A | JTAG | JTAG20 | JP1 |  | 1 | 1.6 | 1.6
IDC20_A | Screnn_Port | C | JP2 |  | 1 | 1.6 | 1.6
HEADER1x7 | L_N_Port | CON7 | JP3 |  | 1 | 0.7 | 0.7
HEADER1X2B | Screen_Power_Port | CON2 | JP4 |  | 1 | 0.5 | 0.5
L0805 | 10uH/0805 | INDUCTOR1 | L1, L2 |  | 2 | 0.2 | 0.4
M-SMB7X7 | 33UH | INDUCTOR2 | L3, L4 |  | 2 | 1 | 2
AXIAL0.4 | 100μH/0.5W/J | INDUCTOR2 | L5, L6, L8, L9 |  | 4 | 0.5 | 2
AXIAL0.4 | 470μH/0.5W/J | INDUCTOR2 | L7, L10 |  | 2 | 0.5 | 1
LED_0805 | LED0805 | LED0805 | LED1, LED2, LED5, LED6, LED9, MCU_LED1 |  | 6 | 0.3 | 1.8
LED_0805 | -12v_Green | B_LED | LED3, LED7 |  | 2 | 0.3 | 0.6
LED_0805 | +12_Green | B_LED | LED4, LED8 |  | 2 | 0.3 | 0.6
SOP4 | TLP280-1 | TLP521 | OP1 |  | 1 | 3 | 3
HDR1X6 | key | Header 6 | P1 | Header, 6-Pin | 1 | 0.5 | 0.5
IDC2x3 | PIN2*3 | PIN2*3 | PE1 |  | 1 | 0.5 | 0.5
TO-92 | C9015/TO-92 | PNP | Q1, Q2, Q3 |  | 3 | 0.2 | 0.6
TO92A | 8050/NPN/TO92 | NPN | Q4 |  | 1 | 0.5 | 0.5
R0805 | 10kΩ/0.25W | RES2 | R1, R2, R3, R4, R7, R8, R9, R12, R13, R14, R15, R16, R22, R25, R27, R28, R29, R30, R36, R38, R49, R51, R55, R56, R61, R63, R67, R68, R73, R75, R79, R80, R110, R113 |  | 34 | 0.1 | 3.4
R0805 | 4.7KΩ/0.25W | Res2 | R5, R6 | Resistor | 2 | 0.1 | 0.2
R0805 | 1MΩ/0.25W | RES2 | R10, R11 |  | 2 | 0.1 | 0.2
R0805 | 200Ω/0.25W | RES2 | R17, R18 |  | 2 | 0.1 | 0.2
R0805 | 330Ω/0.25W | RES2 | R19, R21 |  | 2 | 0.1 | 0.2
R0805 | 2000Ω/0.25W | RES2 | R20 |  | 1 | 0.1 | 0.1
R0805 | 10Ω/1W/D | RES2 | R23 |  | 1 | 0.1 | 0.1
R0805 | 0Ω/0.25W | RES2 | R24, R33, R40, R41, R42, R103, R117, R118 |  | 8 | 0.1 | 0.8
R0805 | 8.2kΩ/0.25W | RES2 | R26 |  | 1 | 0.1 | 0.1
R0805 | 100Ω/0.25W | RES2 | R31, R32 |  | 2 | 0.1 | 0.2
R0805 | 1kΩ/0.25W | RES2 | R34, R39, R43, R107, R115, R119 |  | 6 | 0.1 | 0.6
R0805 | 8.66kΩ/0.25W | RES2 | R35, R37, R109, R112 |  | 4 | 0.1 | 0.4
R0805 | 1.5kΩ/0.25W | RES2 | R44 |  | 1 | 0.1 | 0.1
AXIAL-0.6-R | 2kΩ/DIP/0.02%/10ppm | RES2 | R46, R50, R58, R62 |  | 4 | 12 | 48
AXIAL-0.6-R | 6.2kΩ/DIP/0.02%/10ppm | RES2, RES3 | R47, R59, R105 |  | 3 | 12 | 36
AXIAL0.4 | 10kΩ/DIP/0.1%/25ppm | RES2 | R48, R60 |  | 2 | 0.4 | 0.8
AXIAL-0.6-R | 5.1kΩ/DIP/0.02%/10ppm | RES2 | R52, R64 |  | 2 | 12 | 24
AXIAL0.4 | 1kΩ/DIP/0.1%/25ppm | RES2 | R53, R54, R65, R66, R78 |  | 5 | 0.4 | 2
AXIAL0.4 | 5.6kΩ/DIP/0.1%/25ppm | RES2 | R57, R69, R81 |  | 3 | 0.4 | 1.2
AXIAL-0.6-R | 2kΩ/DIP/0.02%/25ppm | RES2 | R70, R74 |  | 2 | 12 | 24
AXIAL-0.6-R | 5.1kΩ/DIP/0.02%/25ppm | RES2 | R71 |  | 1 | 12 | 12
AXIAL0.4 | 20kΩ/DIP/0.1%/25ppm | RES2 | R72 |  | 1 | 0.4 | 0.4
AXIAL-0.6-R | 5.1kΩ/DIP/0.2%/25ppm | RES2 | R76 |  | 1 | 12 | 12
AXIAL0.4 | 4.3kΩ/DIP/0.1%/25ppm | RES2 | R77 |  | 1 | 0.4 | 0.4
AXIAL0.4 | 180kΩ/DIP/0.1%/25ppm | RES2 | R82, R89, R96 |  | 3 | 0.4 | 1.2
AXIAL0.4 | 2.2kΩ/DIP/0.1%/25ppm | RES2 | R83, R90, R97 |  | 3 | 0.4 | 1.2
AXIAL0.4 | 240Ω/DIP/0.1%/25ppm | RES2 | R84, R91, R98 |  | 3 | 0.4 | 1.2
R0805 | 200kΩ/0805/F | RES2 | R85, R92, R99 |  | 3 | 0.1 | 0.3
AXIAL0.4 | 6.8kΩ/DIP/0.1%/25ppm | RES2 | R86, R87, R93, R94, R100, R101 |  | 6 | 0.4 | 2.4
AXIAL0.4 | 33kΩ/DIP/0.1%/25ppm | RES2 | R88, R95, R102 |  | 3 | 0.4 | 1.2
AXIAL-0.6-R | 4.7KΩ/DIP/0.02%/10ppm | RES2 | R104 |  | 1 | 12 | 12
AXIAL-0.6-R | 10kΩ/DIP/0.02%/10ppm | RES3 | R106 |  | 1 | 12 | 12
AXIAL-0.6-R | 15kΩ/DIP/0.02%/10ppm | RES3 | R108, R116 |  | 2 | 12 | 24
AXIAL-0.6-R | 5.1kΩ/DIP/0.1%/25ppm | RES2 | R111 |  | 1 | 0.4 | 0.4
AXIAL-0.6-R | 300Ω/DIP/0.02%/10ppm | RES2 | R114 |  | 1 | 12 | 12
3224W | 5kΩ/0.5W/G | RPOT | RP1, RP2, RP3, RP4, RP5, RP6, VR1 |  | 7 | 5.5 | 38.5
RV0.3 | 391K | VARISTOR | RV1, RV2 |  | 2 | 0.5 | 1
SOD323 | ESD08V32D-LC | TVS | TVS1, TVS7, TVS8, TVS9, TVS10, TVS12, TVS13, TVS14, TVS15 |  | 9 | 0.5 | 4.5
SOD323 | ESD05V32D-LC | TVS | TVS2, TVS3, TVS4, TVS5, TVS6 |  | 5 | 0.5 | 2.5
SOD323 | ESD15V32D-LC | TVS | TVS11, TVS16, TVS17, TVS18 |  | 4 | 0.5 | 2
SO-8 | AT24C128 | 24WC02 | U1 |  | 1 | 2 | 2
LQFP-100 | STM32F407VGT | STM32F407VGT | U2 |  | 1 | 45 | 45
SOIC8_N | ADUM1100 | ADUM1100 | U3 |  | 1 | 10.5 | 10.5
SOIC8_N | ADUM1200 | ADUM1200 | U4, U5 |  | 2 | 10.5 | 21
SOIC-16 | ULN2003 | ULN2003 | U6 | U? | 1 | 3 | 3
TO263 | LM2596 | LM2596 | U7 |  | 1 | 13.5 | 13.5
TO-263-7 | LM2676S-12 | LM2676 | U8 |  | 1 | 23 | 23
SOIC8_N | ADUM1201 | ADUM1201 | U9, U11, U12, U15 |  | 4 | 10.5 | 42
SOIC8_N | DS2480B+ | DS2480B+ | U10, U13 |  | 2 | 26 | 52
SOP16 | MAX232 | MAX232_DIP16 | U14 |  | 1 | 2 | 2
TO220H | LM337/TO-220H | LM337 | U16, U39 |  | 2 | 2 | 4
TO220H | LM317/TO-220H | LM317 | U17, U42 | L | 2 | 2 | 4
TO-220 | LM78L05 | LM78L05 | U18, U43 |  | 2 | 1.5 | 3
SOT-23-B | REF3333/SOT23 | REF33XX | U19 |  | 1 | 7 | 7
SOT-223-3L(M3) | AS1117M3-33/SOT-223 | AS1117M3-33 | U20, U44 |  | 2 | 2.5 | 5
SO-8 | LM358/SO-8 | MC1458D | U21, U24, U27 |  | 3 | 3 | 9
SO-8 | OP07CZ/SO-8 | OP07CZ | U22, U23, U25, U26, U28, U29, U30, U32, U33, U35, U36, U38, U40 |  | 13 | 5.8 | 75.4
DIP08W | HCNR201/WDIP8 | HCNR201 | U31, U34, U37 |  | 3 | 10 | 30
LM399 | LM399AH | LM399AH | U41 |  | 1 | 3 | 3
3224W | 50kΩ/0.5W/J | RPOT | W1, W3, W5 |  | 3 | 5.5 | 16.5
3224W | 10kΩ/0.5W/J | RPOT | W2, W4, W6 |  | 3 | 5.5 | 16.5
XTAL_SOCKET | 8.00MHz | CRYSTAL | Y2 |  | 1 | 0.5 | 0.5
CY1002 | 1000PF/安规Y | CAP | Y3, Y4, Y5 | Capacitor | 3 | 1 | 3
 |  |  |  |  | 454 |  | 791.1
Approved |  | Notes

Sheet: Project Information
Project Full Path | E:\2017\TemperatureControl\Hardware\Cool_MainControl_Board\HGT-300.PrjPCB
Project Filename | HGT-300.PrjPCB
Variant Name | None
Data-Source Filename | HGT-300.PcbDoc
Data-Source Full Path | E:\2017\TemperatureControl\Hardware\Cool_MainControl_Board\HGT-300.PcbDoc
Title | Bill of Materials For PCB Document [HGT-300.PcbDoc]
Total Quantity | 471
Report Time | PM 03:49:57
Report Date | 2017-6-22
Report Date & Tine | 2017-6-22 PM 03:49:57
Output Name | Bill of Materials
Output Type | BOM_PartType
Output Generator Name | BOM
Output Generator Description | Bill of Materials
