chiuzz/STM32/Hokai/Software/二极管测温验证平台/串口通信/bin/Debug/Record/TestData2017年02月23日15时29分24秒.xlsx

序号 | 时间 | 基准源温度 | 设定温度 | 显示温度 | CH0温度 | CH1温度 | CH2温度 | CH3温度 | CH4温度 | CH5温度 | CH6温度
1 | 2017-02-23 15:30 | 0 | 0 | 0 | 0 | 0 | 0 | 0 | 0 | 0 | 0
2 | 2017-02-23 15:30 | 0 | 0 | 0 | 0 | 0 | 0 | 0 | 0 | 0 | 0
3 | 2017-02-23 15:30 | 0 | 0 | 0 | 0 | 0 | 0 | 0 | 0 | 0 | 0
4 | 2017-02-23 15:30 | 0 | 0 | 0 | 0 | 0 | 0 | 0 | 0 | 0 | 0
5 | 2017-02-23 15:30 | 0 | 0 | 0 | 0 | 0 | 0 | 0 | 0 | 0 | 0
6 | 2017-02-23 15:30 | 0 | 0 | 0 | 0 | 0 | 0 | 0 | 0 | 0 | 0
