chiuzz/STM32/Hokai/Software/二极管测温验证平台/串口通信/bin/Debug/Record/AD_Data2017年03月02日15时59分57秒.xlsx

序号 | 时间 | 基准源温度 | 设定温度 | 显示温度 | AD0值 | AD1值 | AD2值 | AD3值 | AD4值 | AD5值 | AD6值
1 | 2017-03-02 16:00 | 0 | 0 | 0 | 0 | 0 | 0 | 0 | 0 | 0 | 0
