chiuzz/STM32/Hokai/Hardware/Cool_MainControl_Board/HGT-300.pdf

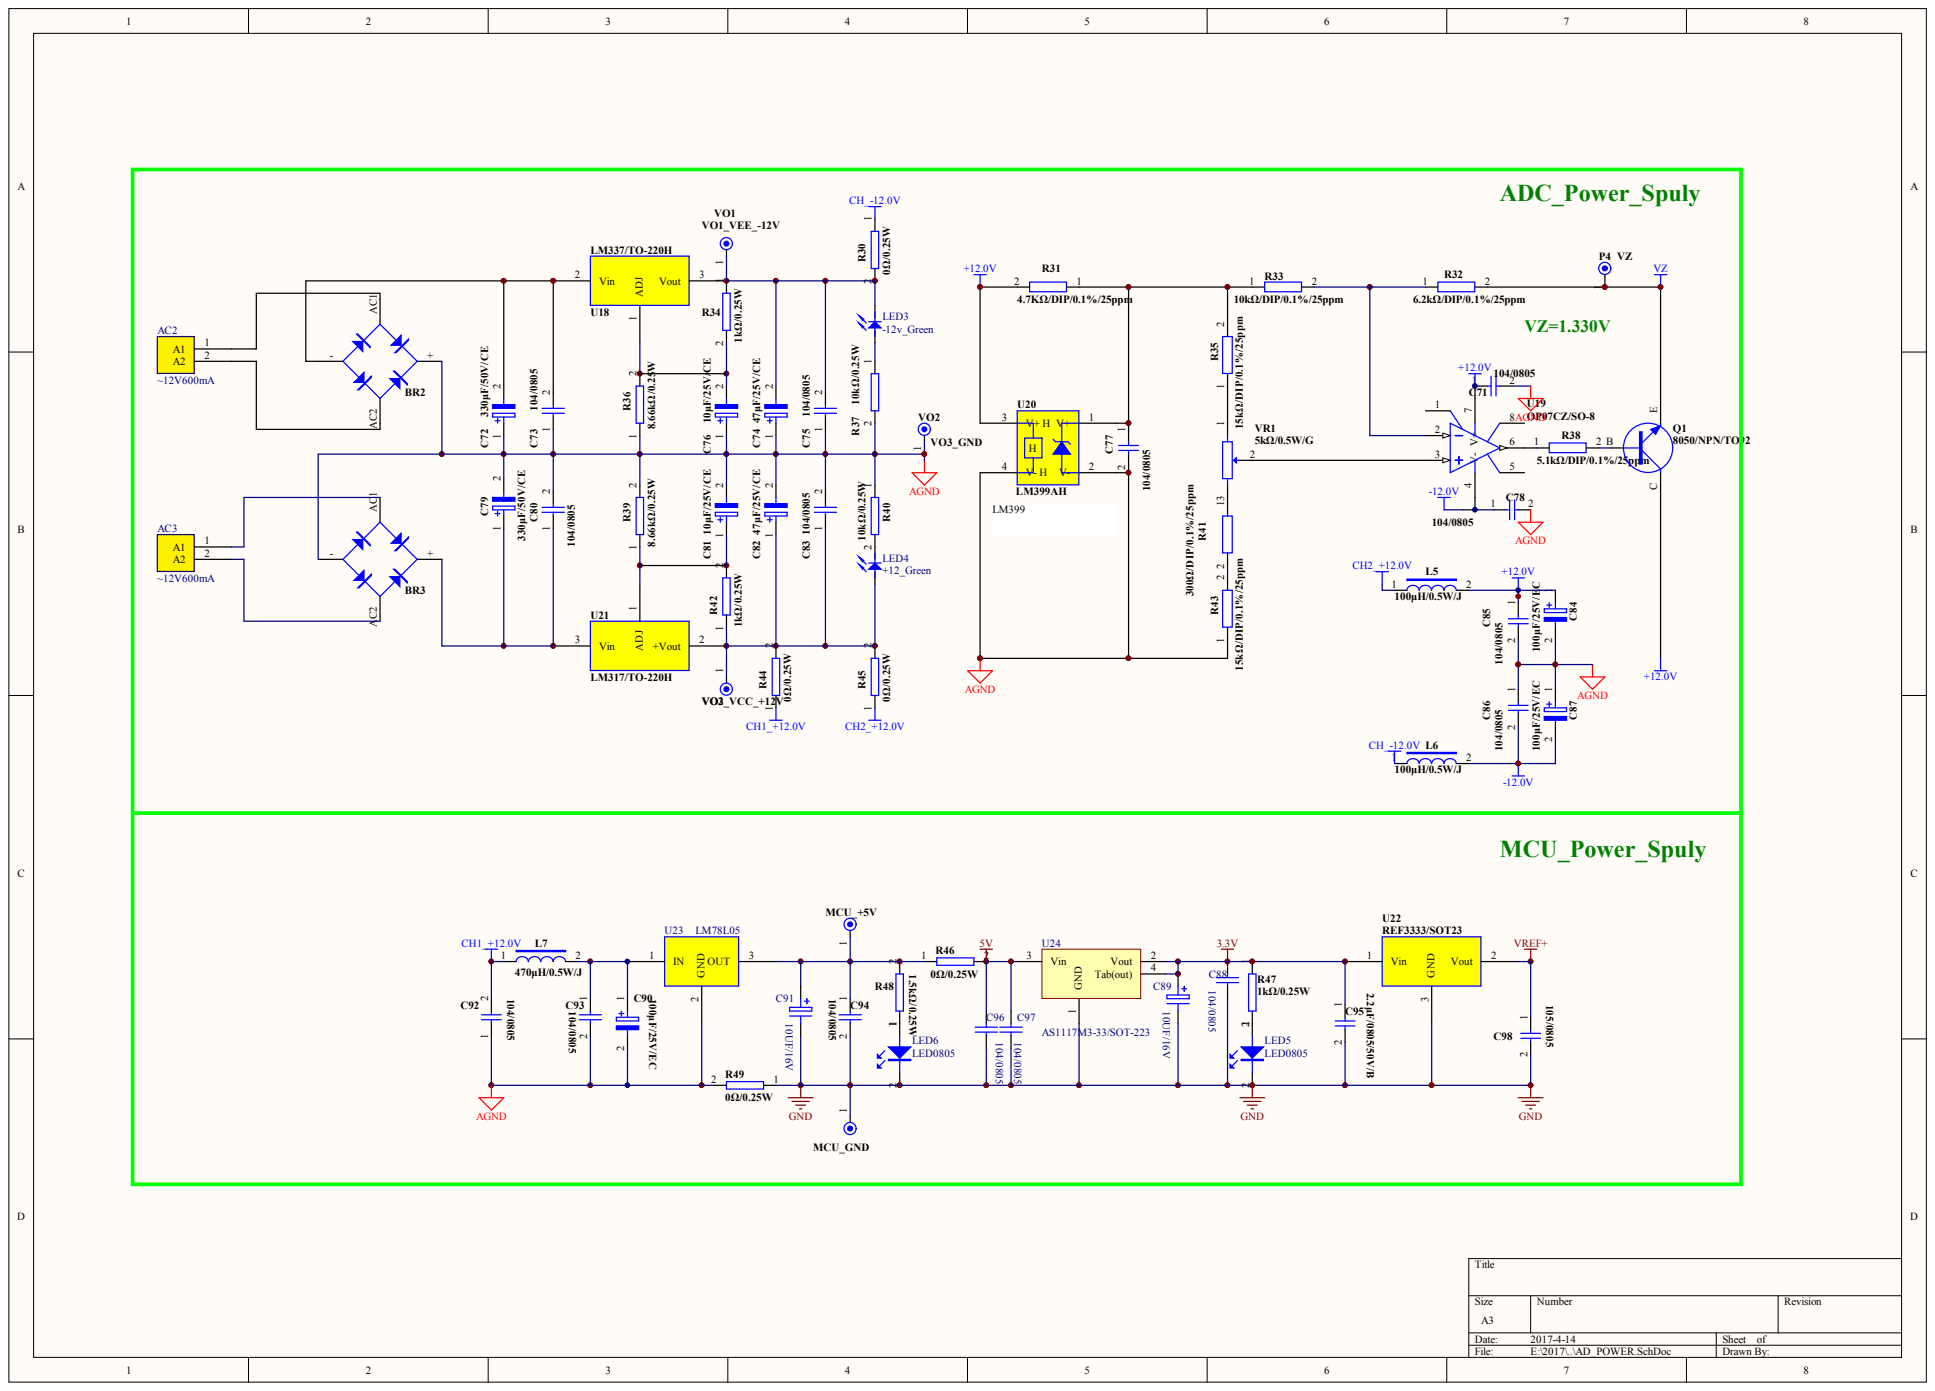
[picture p11: page 1]

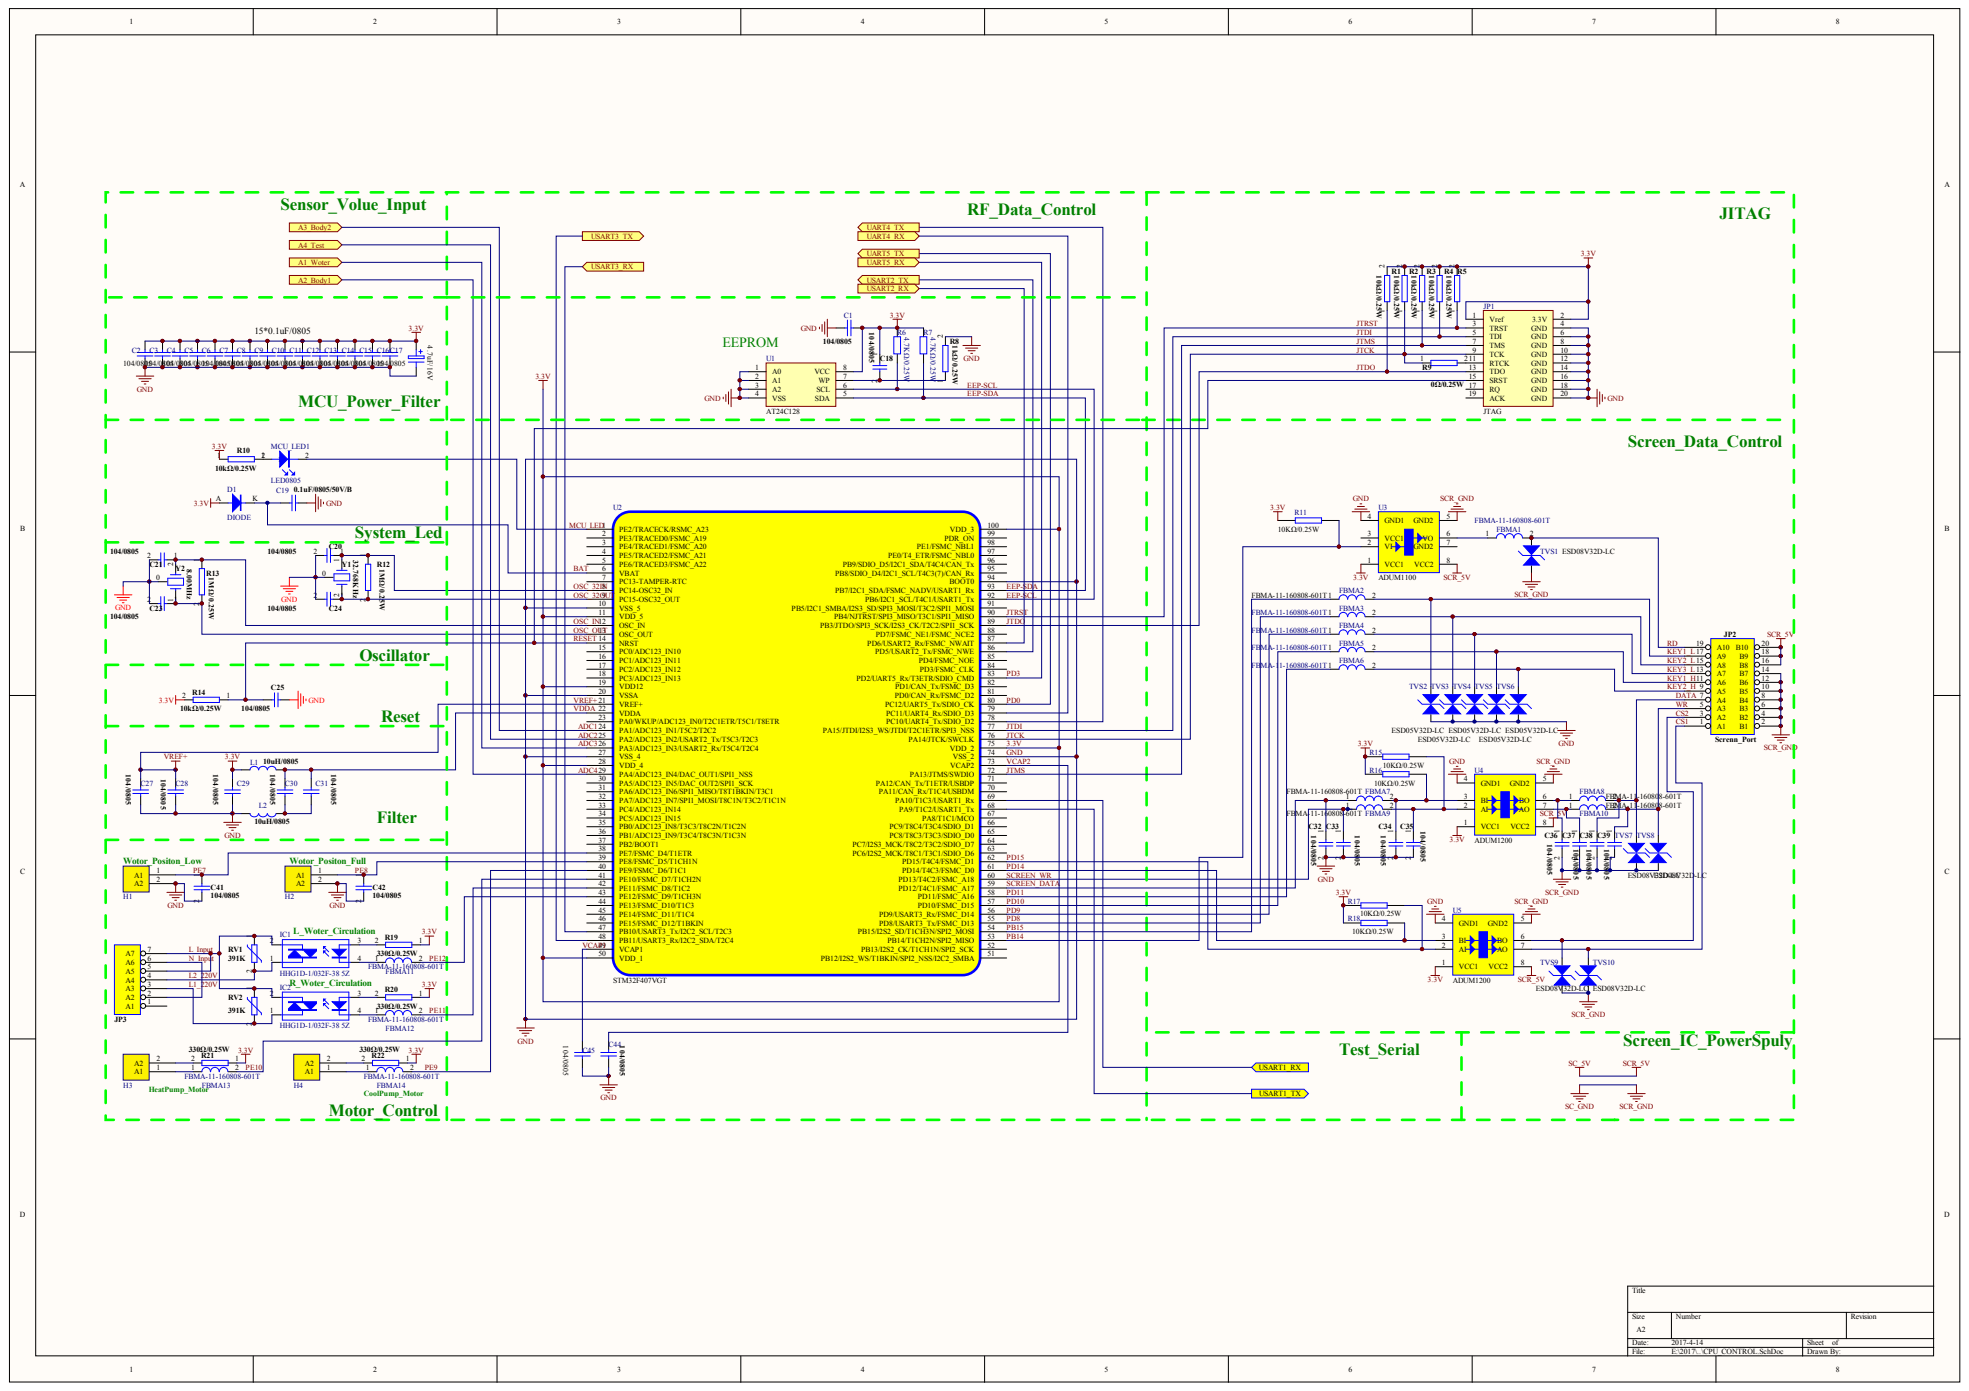
[picture p12: page 2]

4 | VS S SDA | 5 | EEP-SDA

System_L e d | | 2

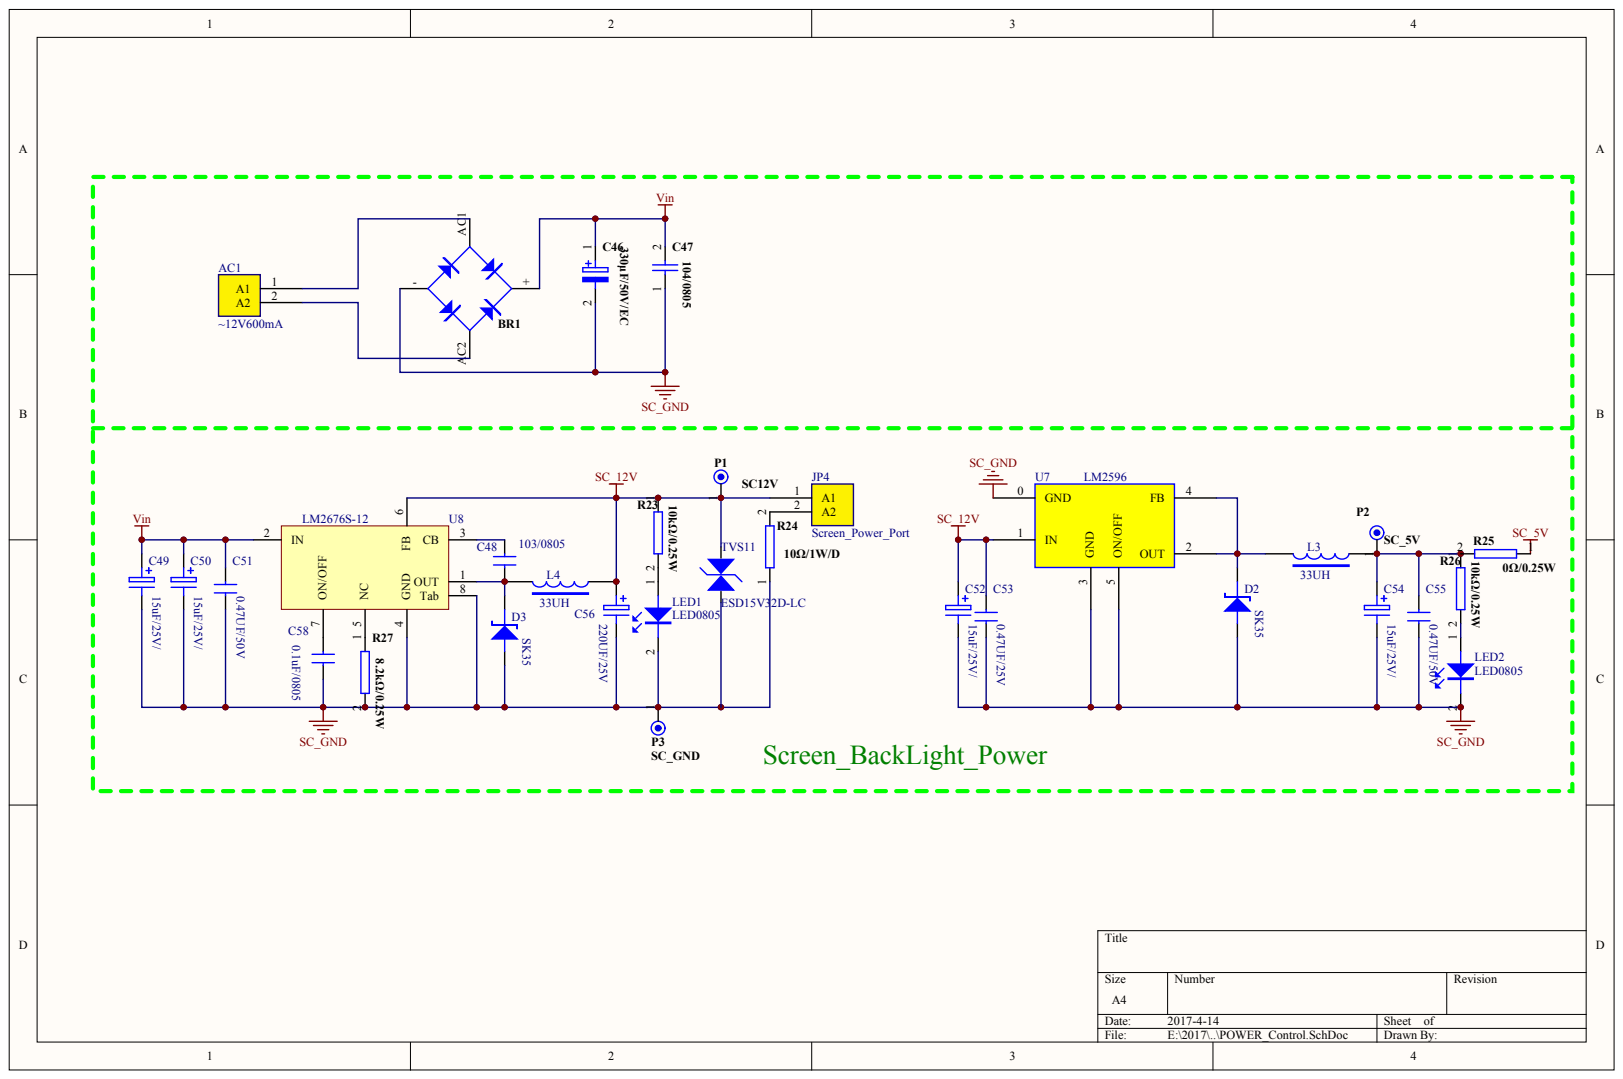
[picture p13: page 3]

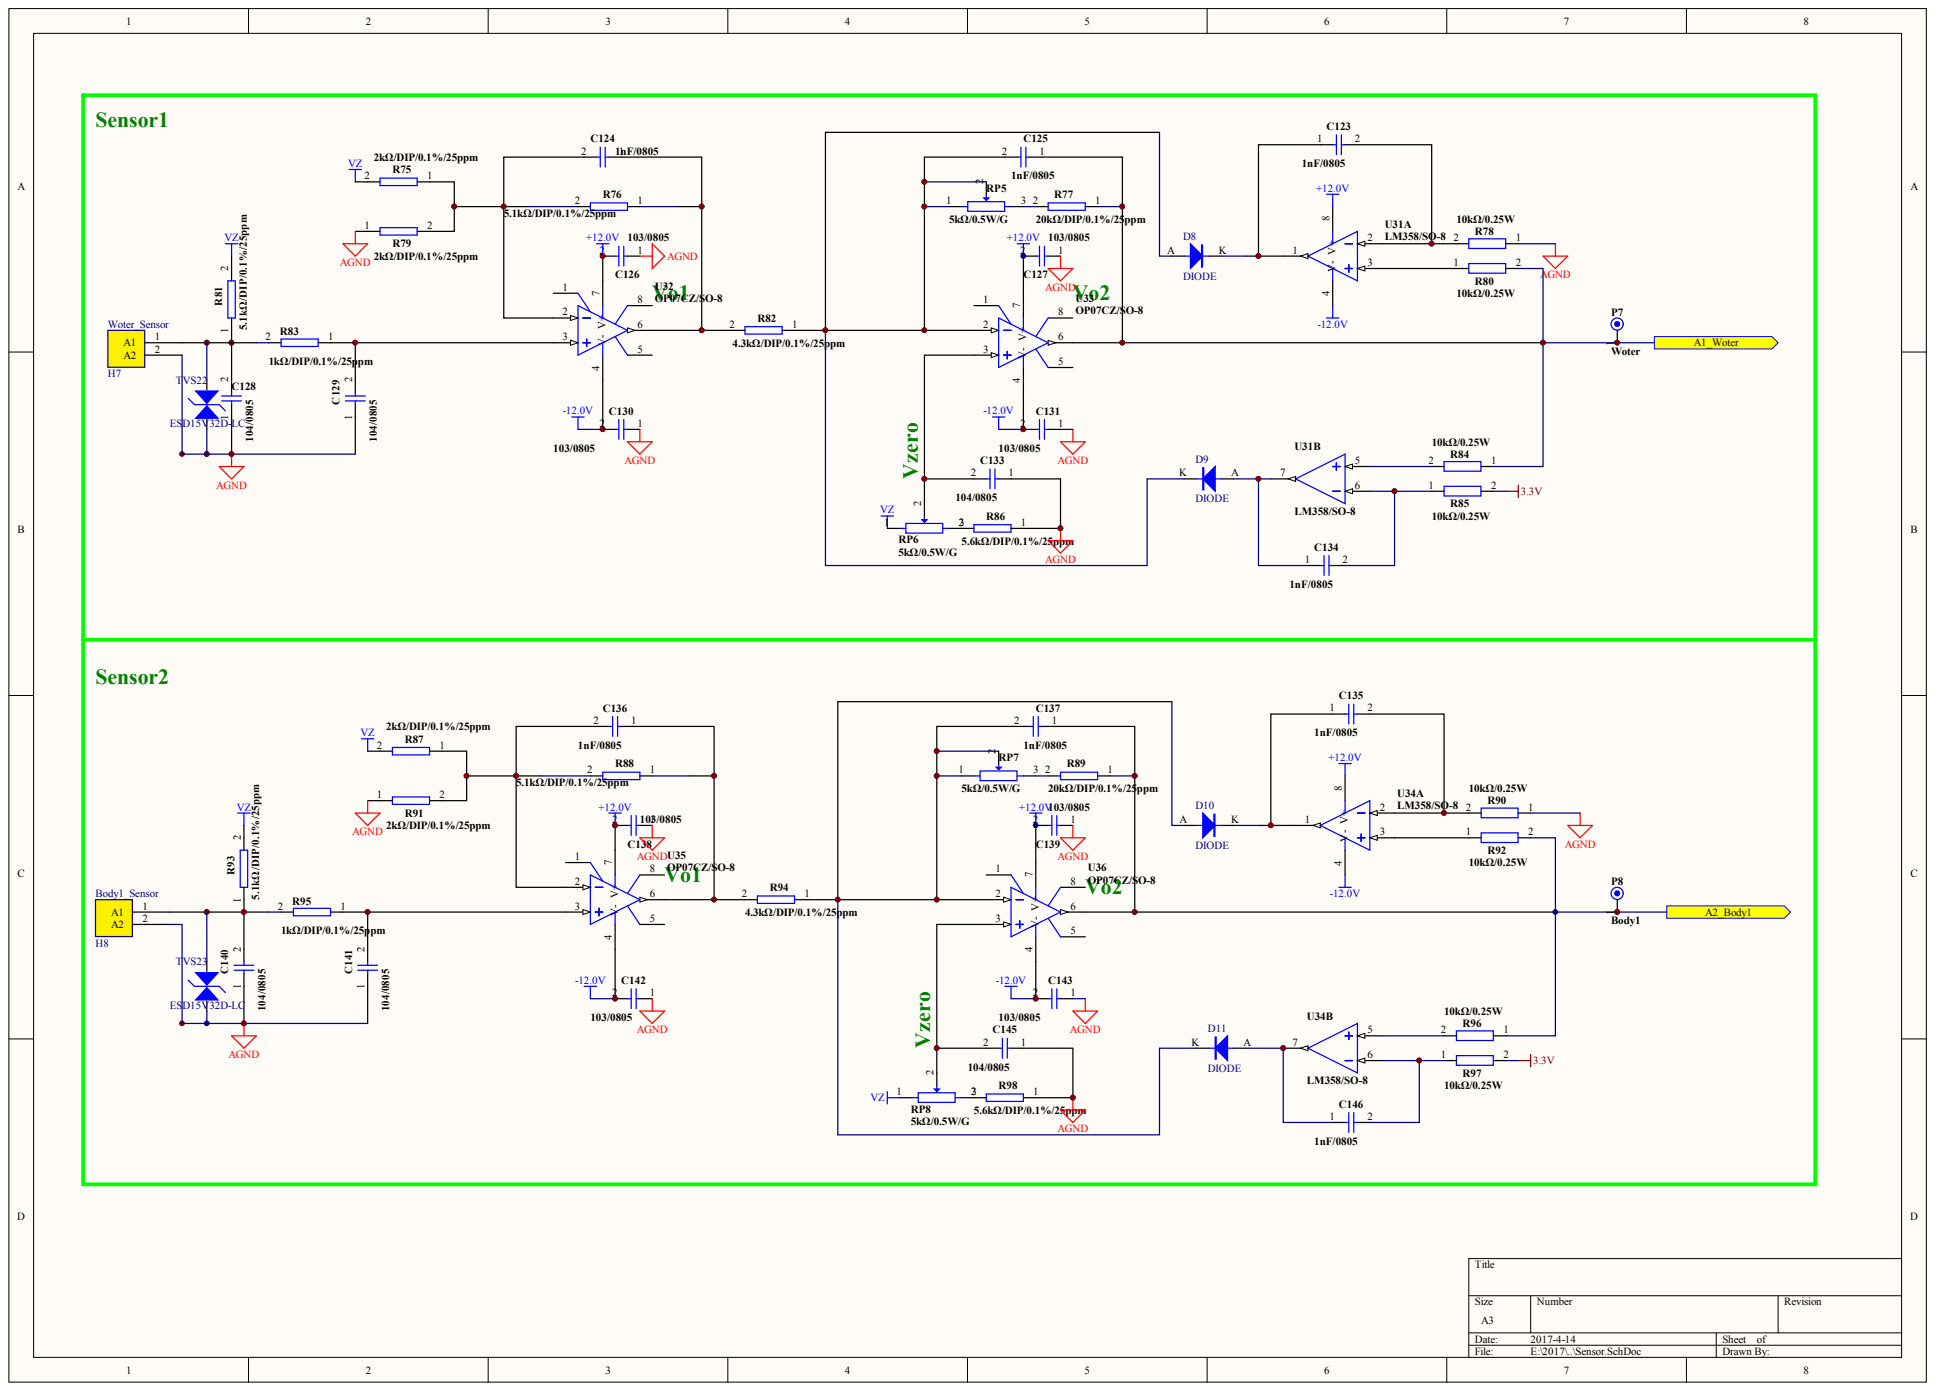
[picture p14: page 4]

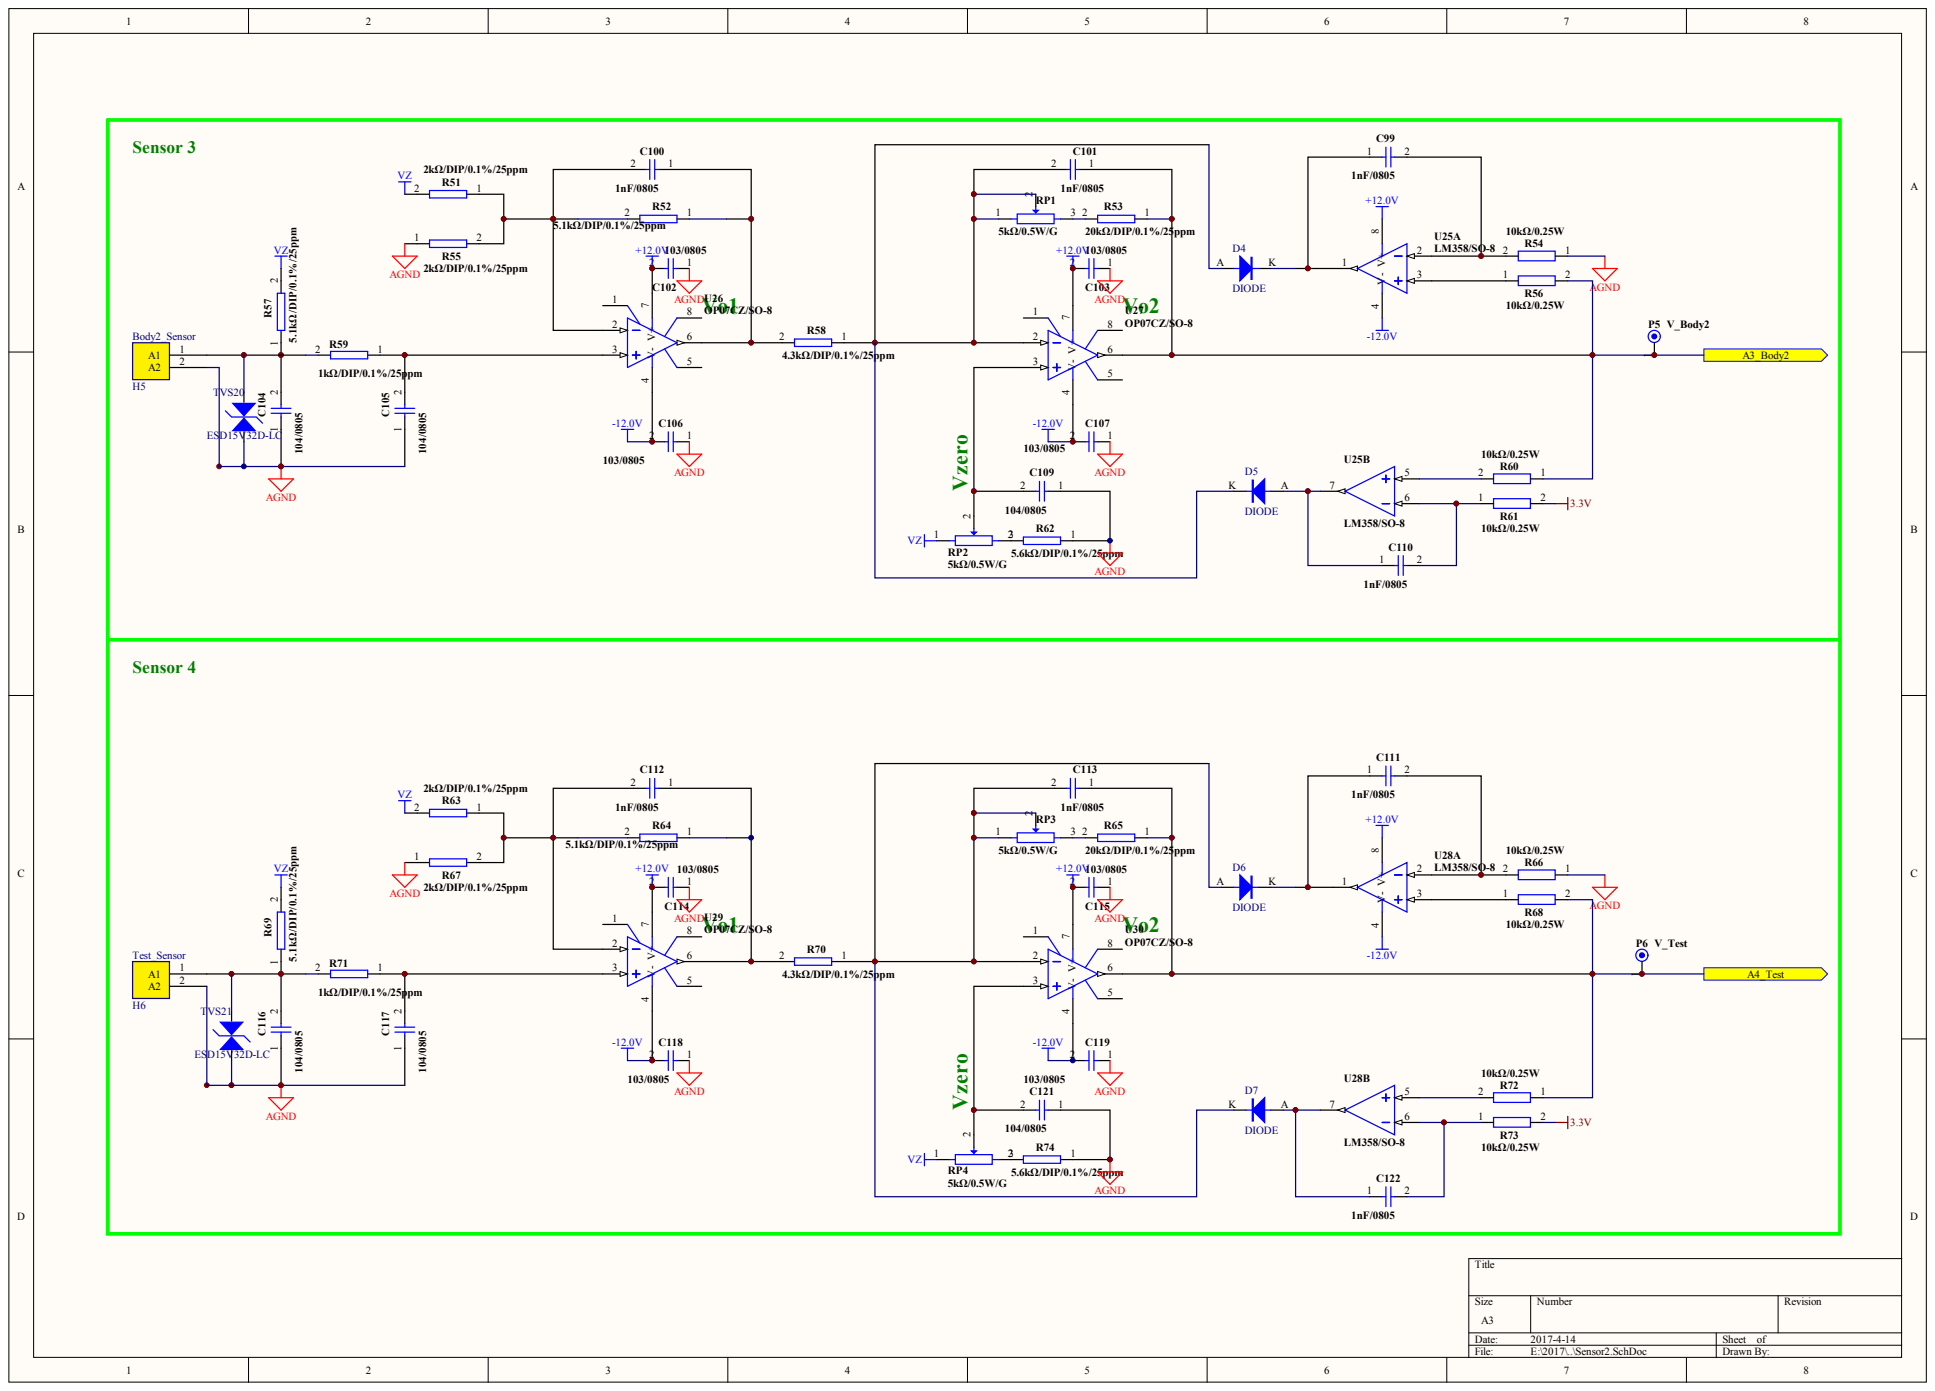
[picture p15: page 5]

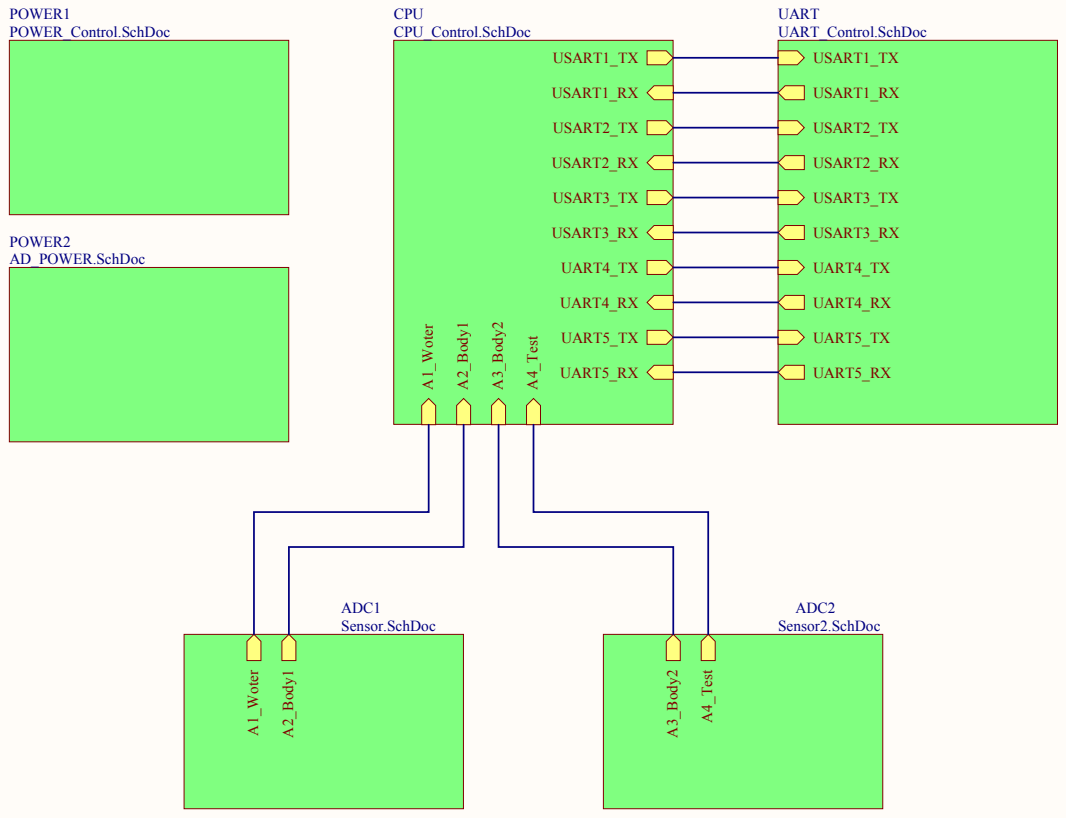
[picture p16: page 6]

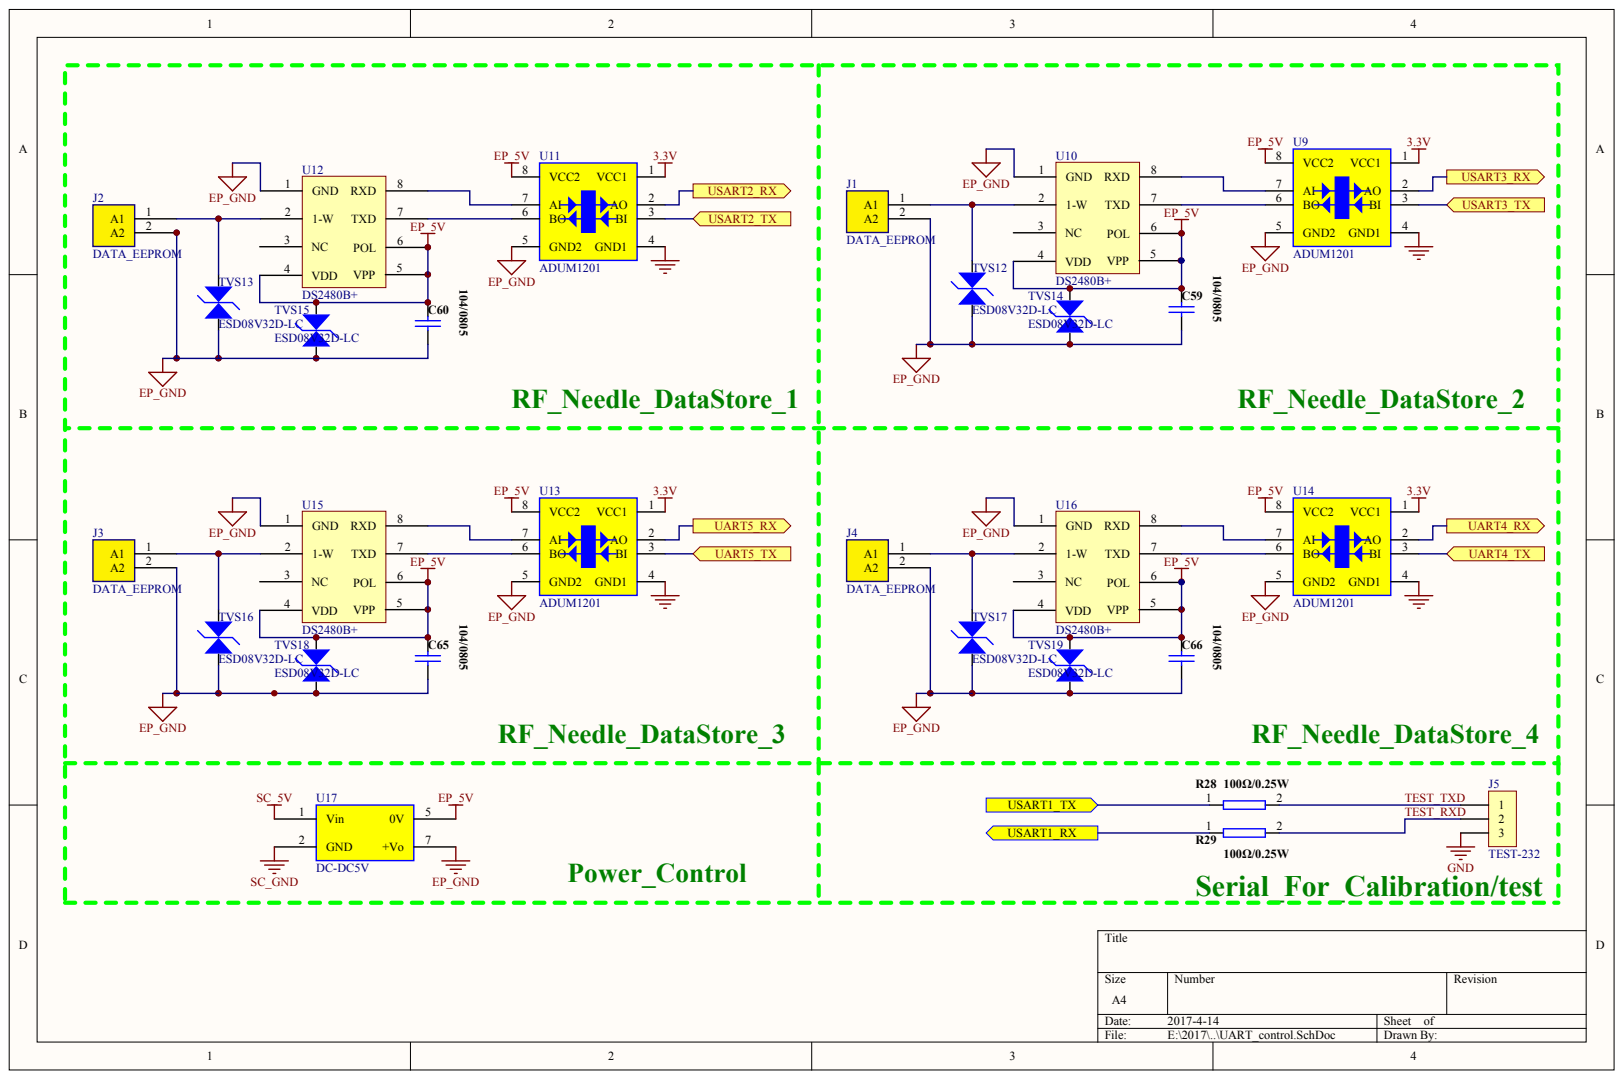
[picture p17: page 7]

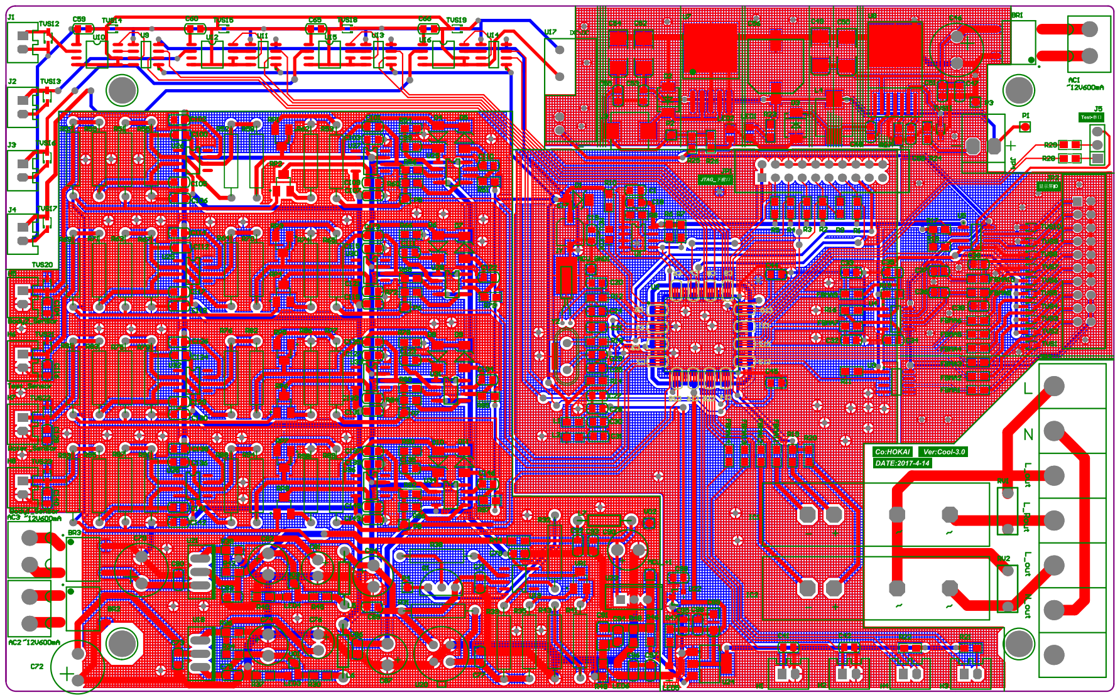
[picture p18: page 8]

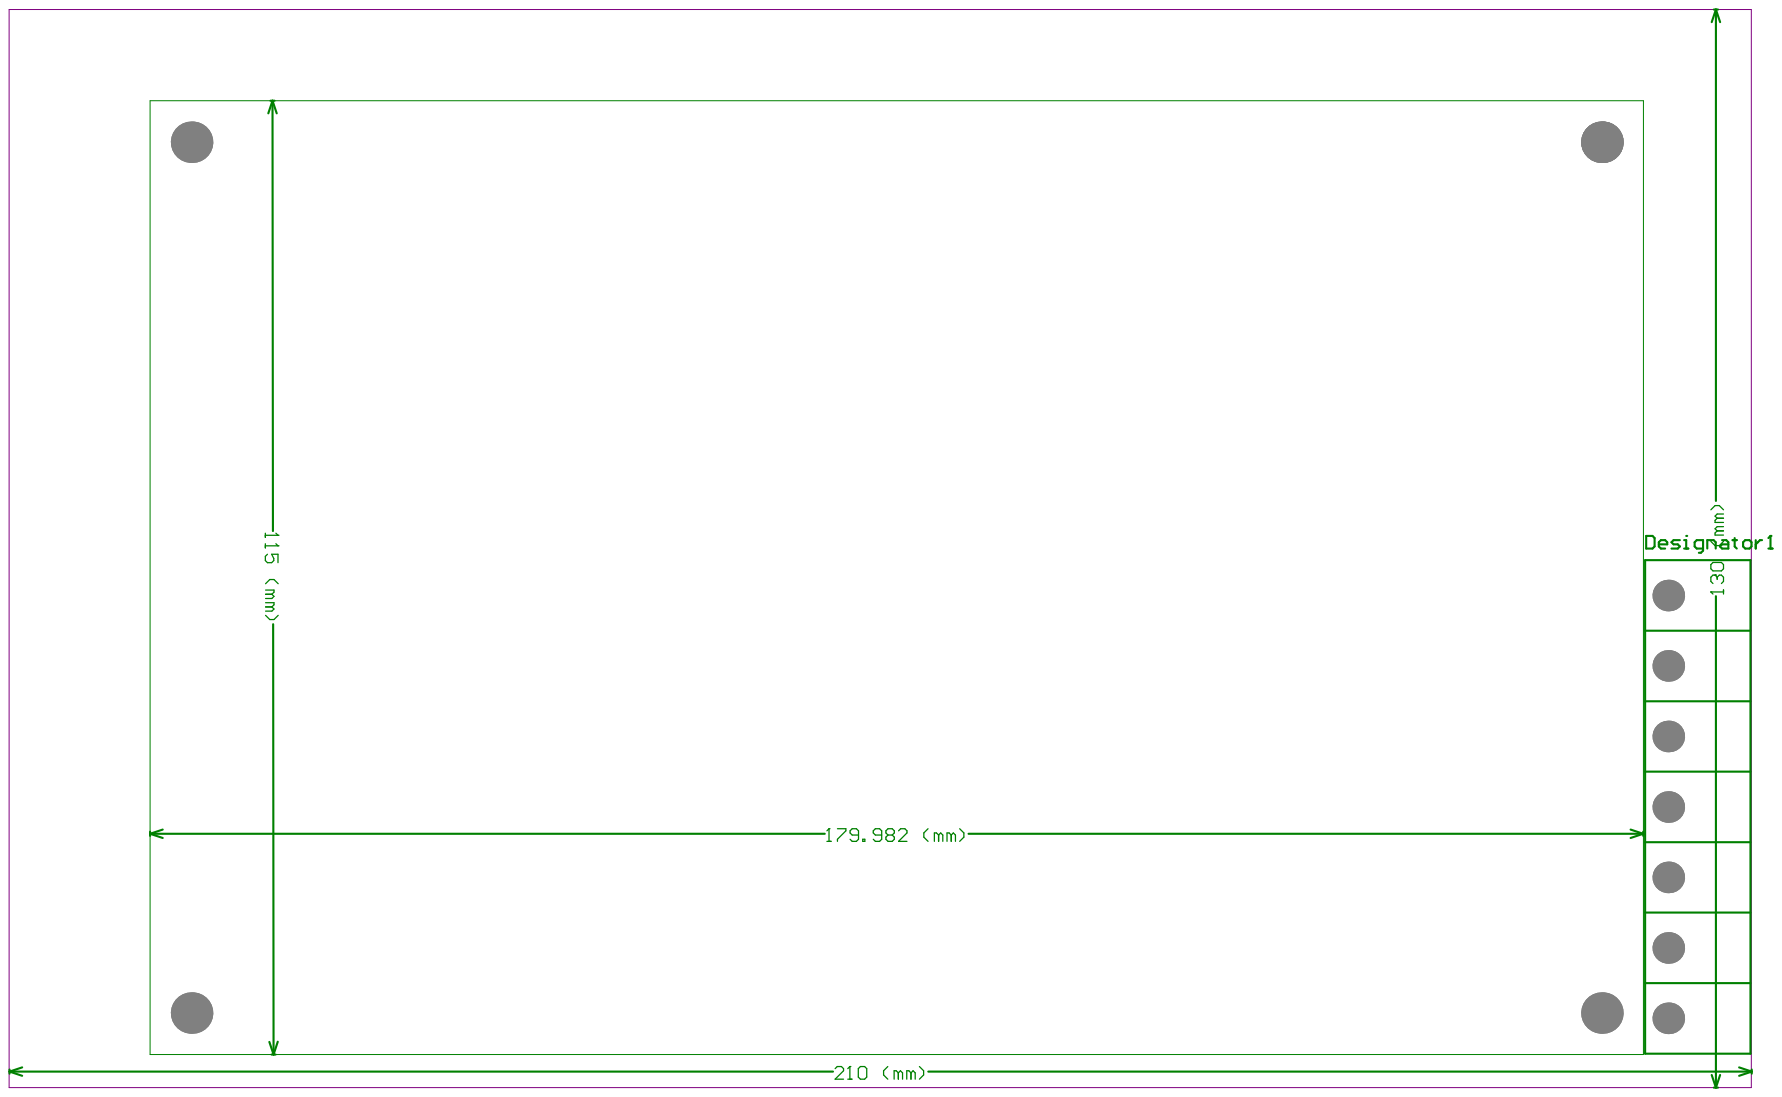
[picture p19: page 9]
