chiuzz/STM32/Hokai/Hardware/屏背板/JD1622(V3.0)SCH.pdf

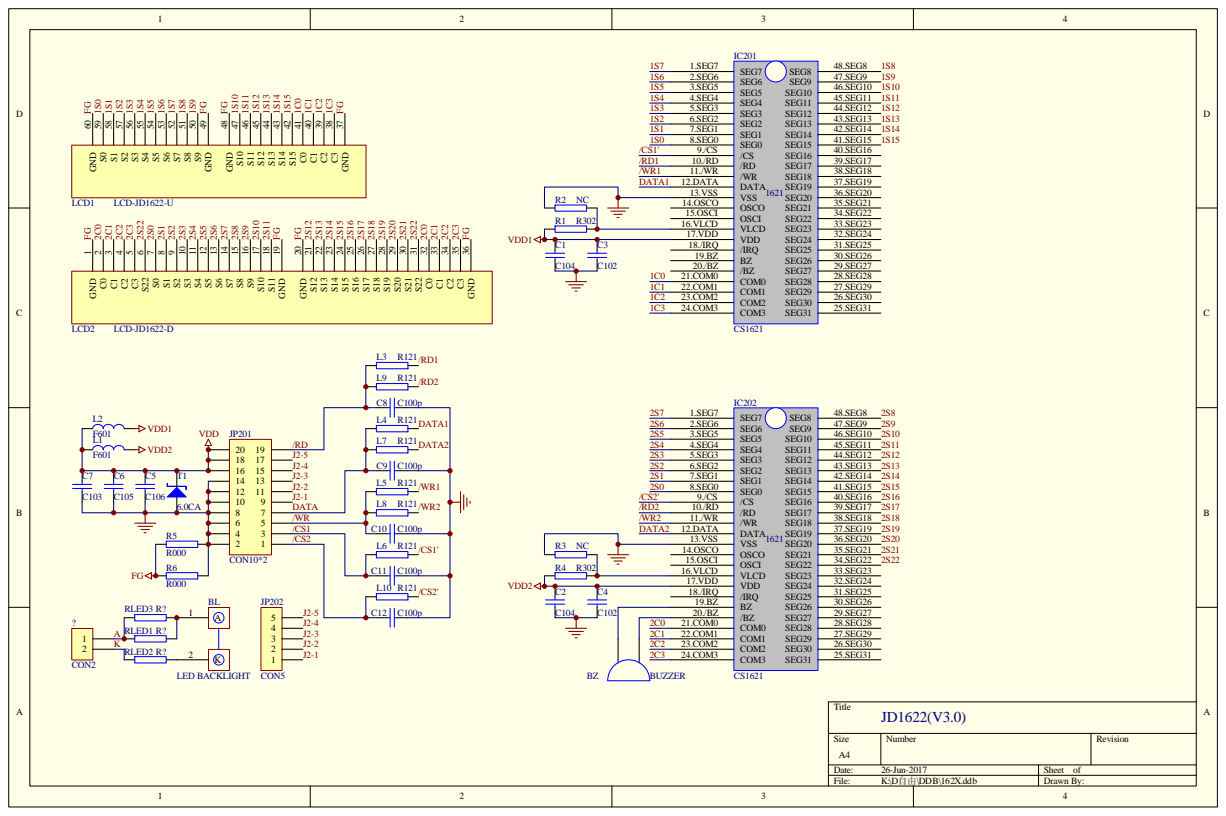
[picture p20: page 1]
