chiuzz/STM32/Hokai/Document/(37-540000-01)新款亚低温治疗仪面膜IV(增加...pdf

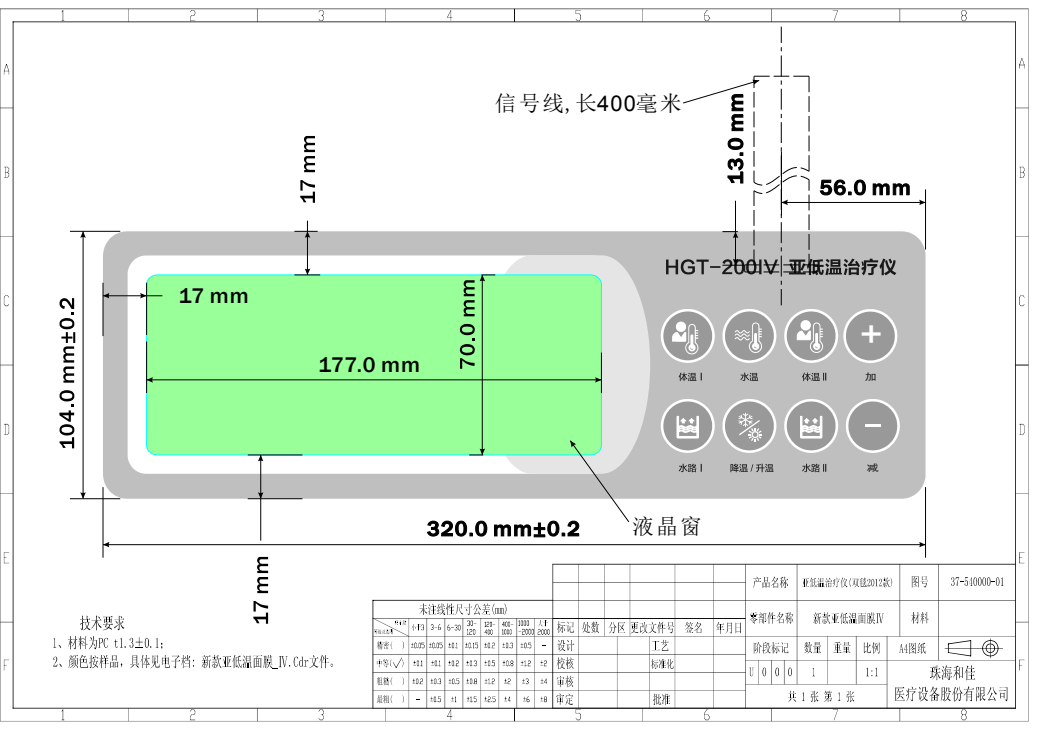
[picture p21: page 1]
信号线,长; 液晶窗
