chiuzz/STM32/Hokai/Document/JD-10827AB真值表.pdf

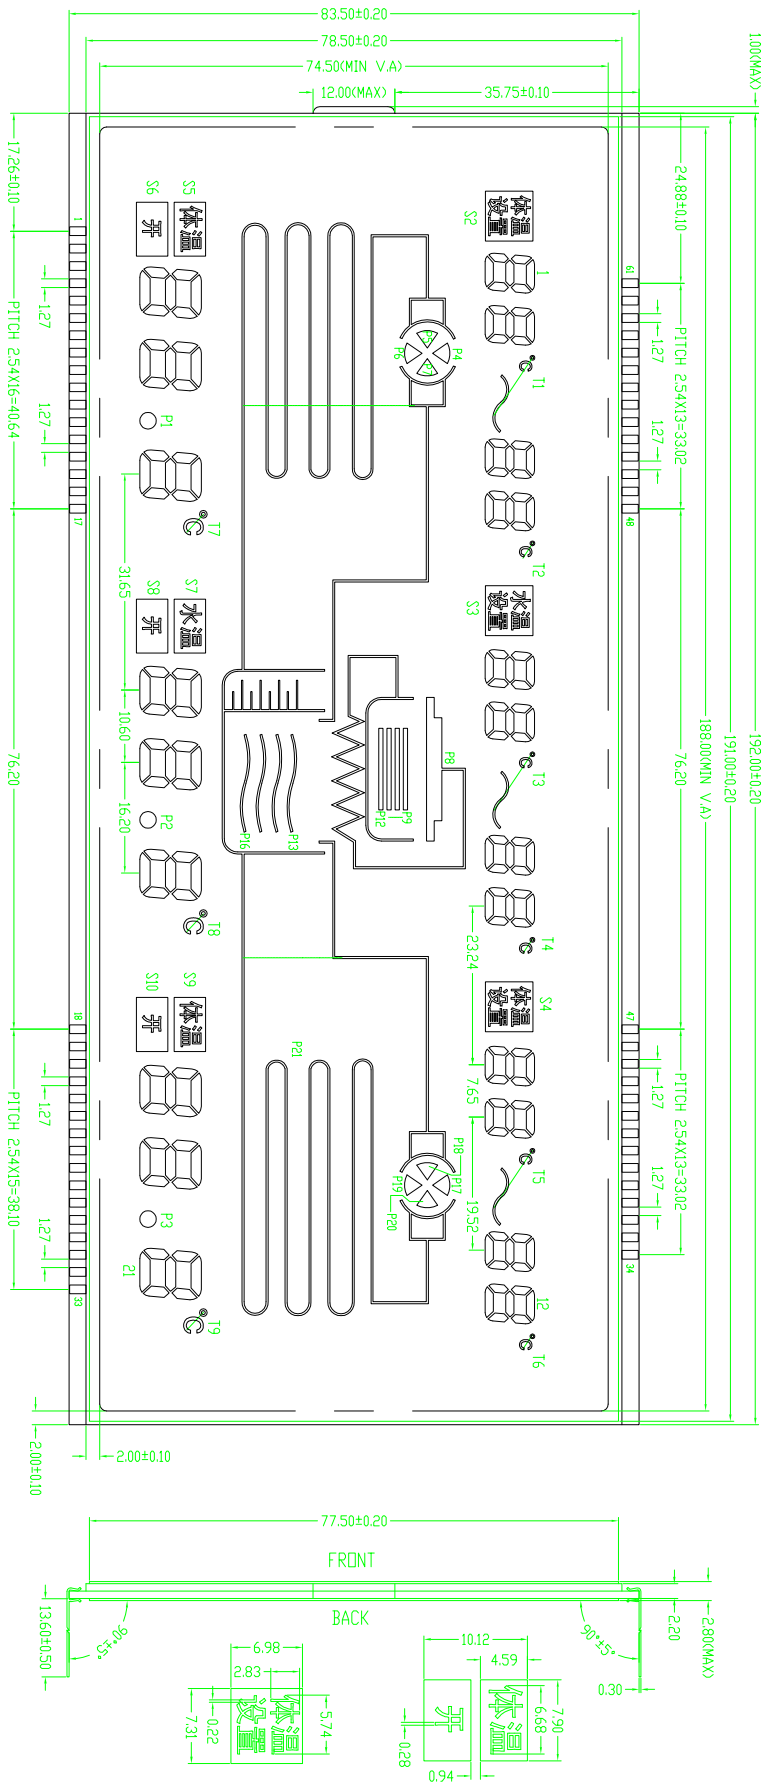
[picture p22: page 1]

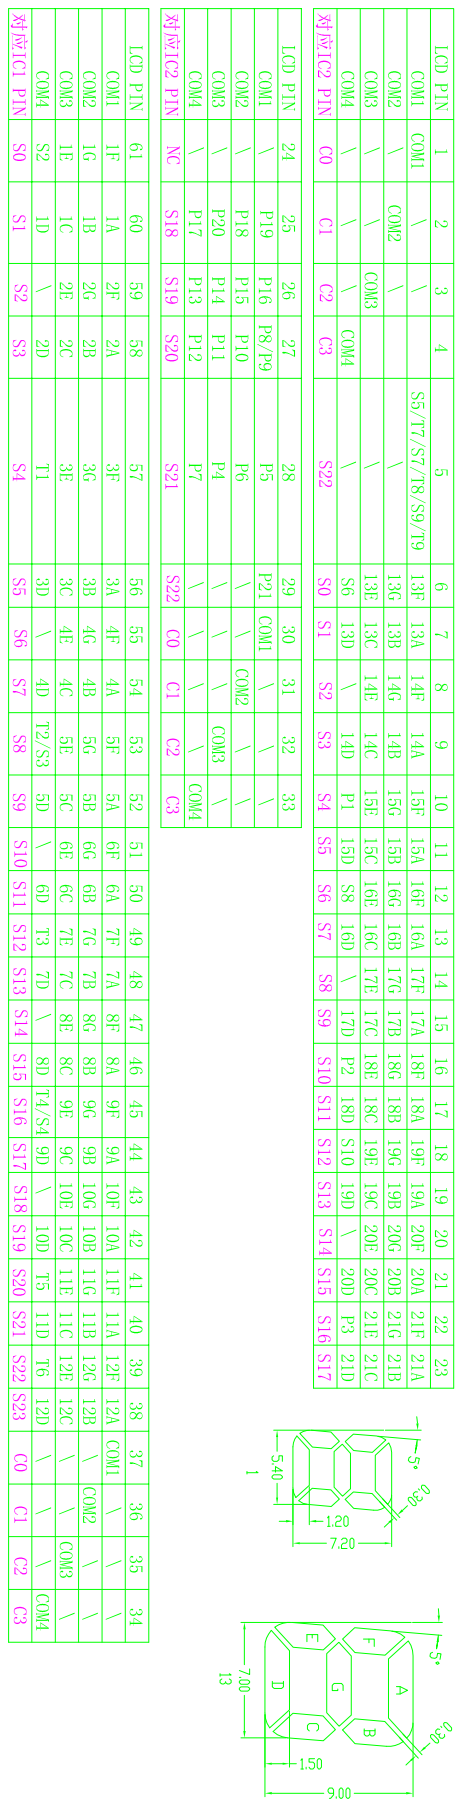
[picture p23: page 2]
