chiuzz/STM32/Hokai/Document/JD-17169AA真值表.pdf

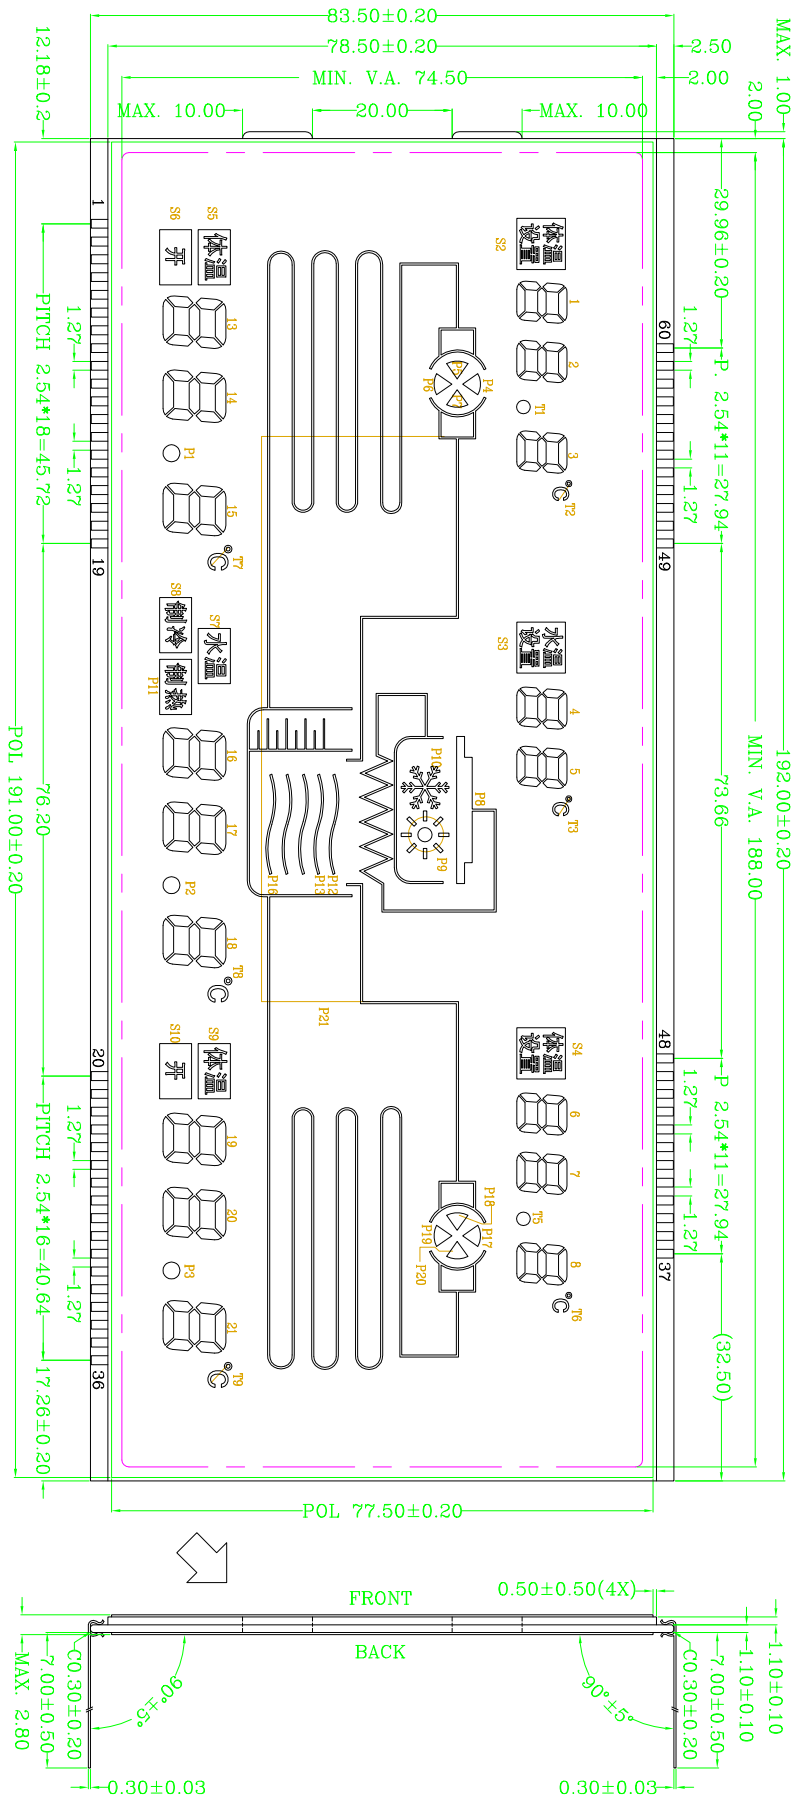
[picture p28: page 1]

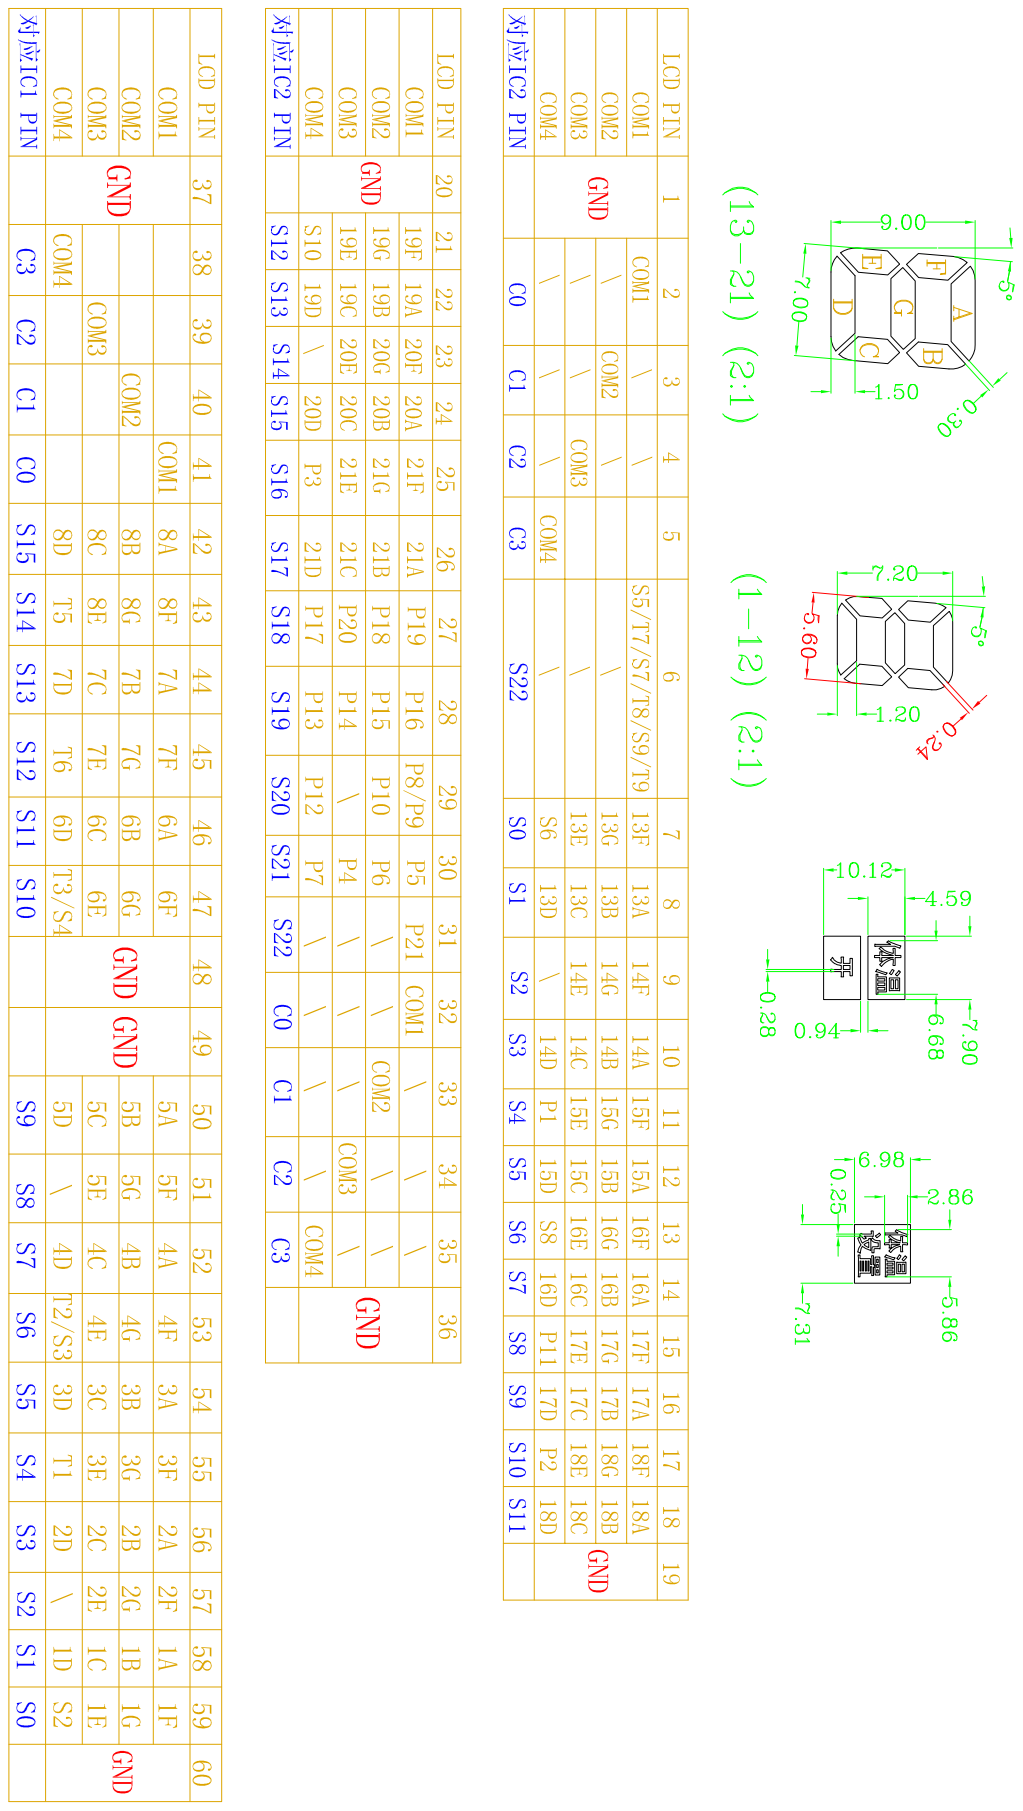
[picture p29: page 2]
