chiuzz/STM32/(list of files, drawings)

Other design files:
Hokai/Hardware/Cool_MainControl_Board/AD_POWER.SchDoc
Hokai/Hardware/Cool_MainControl_Board/ADC_Isolation.SchDoc
Hokai/Hardware/Cool_MainControl_Board/CPU_CONTROL.SchDoc
Hokai/Hardware/Cool_MainControl_Board/HGT-300.PrjPCB
Hokai/Hardware/Cool_MainControl_Board/MCUPOWER.SchDoc
Hokai/Hardware/Cool_MainControl_Board/POWER_Control.SchDoc
Hokai/Hardware/Cool_MainControl_Board/Sensor2.SchDoc
Hokai/Hardware/Cool_MainControl_Board/Sensor.SchDoc
Hokai/Hardware/Cool_MainControl_Board/SYSTEM_Control.SchDoc
Hokai/Hardware/Cool_MainControl_Board/UART_control.SchDoc
Hokai/Hardware/Cool_MainControl_Board/安装尺寸.PcbDoc
Hokai/Hardware/屏背板/JD1622(V3.0).PCB
Hokai/Hardware/屏背板/JD1622(V3.0).PcbLib
Hokai/Hardware/屏背板/JD1622(V4).PcbDoc
Hokai/Hardware/屏背板/SCR.SchDoc
Hokai/Hardware/屏背板/SCREEN.PrjPCB
Hokai/Hardware/屏背板/SCREEN.SCHLIB
Hokai/Hardware/屏背板/Sheet1.SchDoc
Hokai/Hardware/屏背板/Sheet4.SchDoc
Hokai/Hardware/屏背板/Thermometer.PcbLib
