chiuzz/STM32/LED-PA4/My_Lib/LED/led.c

#include "led.h"
#include "ALL_Includes.h"

/****************************************************
函数功能：LED初始化
输入参数：无
输出参数：无
备    注：调用此函数前，需要在LED.h修改宏定义LED引脚
****************************************************/
void LED_Init(void)
{
	  GPIO_InitTypeDef GPIO_InitStructure;

	  RCC_AHBPeriphClockCmd(LED_GPIO_CLK, ENABLE);
   
    GPIO_InitStructure.GPIO_Pin = LED_PIN;
    GPIO_InitStructure.GPIO_Speed = GPIO_Speed_10MHz;
    GPIO_InitStructure.GPIO_Mode = GPIO_Mode_OUT;
    GPIO_InitStructure.GPIO_OType = GPIO_OType_PP;	
    GPIO_Init(LED_PORT, &GPIO_InitStructure);
	
		LED_OFF();
}

/****************************************************
函数功能：LED开
输入参数：无
输出参数：无
备    注：调用此函数前，需要在LED.h修改宏定义LED引脚
****************************************************/
void LED_ON(void)
{
		GPIO_ResetBits(LED_PORT, LED_PIN);
}

/****************************************************
函数功能：LED关
输入参数：无
输出参数：无
备    注：调用此函数前，需要在LED.h修改宏定义LED引脚
****************************************************/
void LED_OFF(void)
{
		GPIO_SetBits(LED_PORT, LED_PIN);
}
