chiuzz/STM32/Hokai/Software/ScreemCtrl/BSP/BSP.c

#include "includes.h"

/*
 * 函数名：BSP_Init
 * 描述  ：时钟初始化、硬件初始化
 * 输入  ：无
 * 输出  ：无
 */
void BSP_Init(void)
{
    SystemInit();		/* 配置系统时钟为72M */	
		SysTick_init();		/* 初始化并使能SysTick定时器 */
    LED_GPIO_Config();  /* LED 端口初始化 */
// 		USART_INIT();
		USART1_Config();
		uart3_init(19200);
//  		ADC_INIT();
//  		I2C_EE_Init();
}

/*
 * 函数名：SysTick_init
 * 描述  ：配置SysTick定时器
 * 输入  ：无
 * 输出  ：无
 */
void SysTick_init(void)
{
    SysTick_Config(SystemFrequency/OS_TICKS_PER_SEC);//初始化并使能SysTick定时器
}
