chiuzz/STM32/Hokai/Software/Ctrl/HARDWARE/src/adc.c

#include "adc.h"
#include "delay.h"

#define NUM_ADC_CHANNEL 9
//初始化ADC
//这里我们仅以规则通道为例
//我们默认仅开启通道1
void  Adc_Init(void)
{
    GPIO_InitTypeDef  GPIO_InitStructure;
    ADC_CommonInitTypeDef ADC_CommonInitStructure;
    ADC_InitTypeDef       ADC_InitStructure;

    RCC_AHB1PeriphClockCmd(RCC_AHB1Periph_GPIOA, ENABLE);//使能GPIOA时钟
    RCC_APB2PeriphClockCmd(RCC_APB2Periph_ADC1, ENABLE);//使能ADC1时钟

    //先初始化IO口
    GPIO_InitStructure.GPIO_Pin = GPIO_Pin_1 | GPIO_Pin_2 | GPIO_Pin_3;
    GPIO_InitStructure.GPIO_Mode = GPIO_Mode_AN;//模拟输入
    GPIO_InitStructure.GPIO_PuPd = GPIO_PuPd_DOWN;//下拉
    GPIO_Init(GPIOA, &GPIO_InitStructure);//初始化

    RCC_APB2PeriphResetCmd(RCC_APB2Periph_ADC1, ENABLE);	//ADC1复位
    RCC_APB2PeriphResetCmd(RCC_APB2Periph_ADC1, DISABLE);	//复位结束

    ADC_CommonInitStructure.ADC_Mode = ADC_Mode_Independent;//独立模式
    ADC_CommonInitStructure.ADC_TwoSamplingDelay = ADC_TwoSamplingDelay_5Cycles;
    ADC_CommonInitStructure.ADC_DMAAccessMode = ADC_DMAAccessMode_Disabled; //DMA失能
    ADC_CommonInitStructure.ADC_Prescaler = ADC_Prescaler_Div4;//预分频4分频。ADCCLK=PCLK2/4=84/4=21Mhz,ADC时钟最好不要超过36Mhz
    ADC_CommonInit(&ADC_CommonInitStructure);

    ADC_InitStructure.ADC_Resolution = ADC_Resolution_12b;//12位模式
    ADC_InitStructure.ADC_ScanConvMode = DISABLE;//扫描模式
    ADC_InitStructure.ADC_ContinuousConvMode = DISABLE;//关闭连续转换
    ADC_InitStructure.ADC_ExternalTrigConvEdge = ADC_ExternalTrigConvEdge_None;//禁止触发检测，使用软件触发
    ADC_InitStructure.ADC_DataAlign = ADC_DataAlign_Right;//右对齐
    ADC_InitStructure.ADC_NbrOfConversion = 1;
    ADC_Init(ADC1, &ADC_InitStructure);
    ADC_Cmd(ADC1, ENABLE);//开启AD转换器
    GPIO_ResetBits(GPIOA, GPIO_Pin_1);
    GPIO_ResetBits(GPIOA, GPIO_Pin_2);
    GPIO_ResetBits(GPIOA, GPIO_Pin_3);
}
//void  Adc2_Init(void)
//{
//    GPIO_InitTypeDef  GPIO_InitStructure;
//    ADC_CommonInitTypeDef ADC_CommonInitStructure;
//    ADC_InitTypeDef       ADC_InitStructure;

//    RCC_AHB1PeriphClockCmd(RCC_AHB1Periph_GPIOA, ENABLE);//使能GPIOA时钟
//    RCC_APB2PeriphClockCmd(RCC_APB2Periph_ADC2, ENABLE);//使能ADC1时钟

//    //先初始化IO口
//    GPIO_InitStructure.GPIO_Pin = GPIO_Pin_2;
//    GPIO_InitStructure.GPIO_Mode = GPIO_Mode_AN;//模拟输入
//    GPIO_InitStructure.GPIO_PuPd = GPIO_PuPd_DOWN;//下拉
//    GPIO_Init(GPIOA, &GPIO_InitStructure);//初始化

//    RCC_APB2PeriphResetCmd(RCC_APB2Periph_ADC2,ENABLE);	//ADC1复位
//    RCC_APB2PeriphResetCmd(RCC_APB2Periph_ADC2,DISABLE);	//复位结束

//    ADC_CommonInitStructure.ADC_Mode = ADC_Mode_Independent;//独立模式
//    ADC_CommonInitStructure.ADC_TwoSamplingDelay = ADC_TwoSamplingDelay_5Cycles;
//    ADC_CommonInitStructure.ADC_DMAAccessMode = ADC_DMAAccessMode_Disabled; //DMA失能
//    ADC_CommonInitStructure.ADC_Prescaler = ADC_Prescaler_Div4;//预分频4分频。ADCCLK=PCLK2/4=84/4=21Mhz,ADC时钟最好不要超过36Mhz
//    ADC_CommonInit(&ADC_CommonInitStructure);

//    ADC_InitStructure.ADC_Resolution = ADC_Resolution_12b;//12位模式
//    ADC_InitStructure.ADC_ScanConvMode = DISABLE;//扫描模式
//    ADC_InitStructure.ADC_ContinuousConvMode = DISABLE;//关闭连续转换
//    ADC_InitStructure.ADC_ExternalTrigConvEdge = ADC_ExternalTrigConvEdge_None;//禁止触发检测，使用软件触发
//    ADC_InitStructure.ADC_DataAlign = ADC_DataAlign_Right;//右对齐
//    ADC_InitStructure.ADC_NbrOfConversion = 1;
//    ADC_Init(ADC2, &ADC_InitStructure);
//    ADC_Cmd(ADC2, ENABLE);//开启AD转换器
//}
//void  Adc3_Init(void)
//{
//    GPIO_InitTypeDef  GPIO_InitStructure;
//    ADC_CommonInitTypeDef ADC_CommonInitStructure;
//    ADC_InitTypeDef       ADC_InitStructure;

//    RCC_AHB1PeriphClockCmd(RCC_AHB1Periph_GPIOA, ENABLE);//使能GPIOA时钟
//    RCC_APB2PeriphClockCmd(RCC_APB2Periph_ADC3, ENABLE);//使能ADC1时钟

//    //先初始化IO口
//    GPIO_InitStructure.GPIO_Pin = GPIO_Pin_3;
//    GPIO_InitStructure.GPIO_Mode = GPIO_Mode_AN;//模拟输入
//    GPIO_InitStructure.GPIO_PuPd = GPIO_PuPd_DOWN;//下拉
//    GPIO_Init(GPIOA, &GPIO_InitStructure);//初始化

//    RCC_APB2PeriphResetCmd(RCC_APB2Periph_ADC3,ENABLE);	//ADC1复位
//    RCC_APB2PeriphResetCmd(RCC_APB2Periph_ADC3,DISABLE);	//复位结束

//    ADC_CommonInitStructure.ADC_Mode = ADC_Mode_Independent;//独立模式
//    ADC_CommonInitStructure.ADC_TwoSamplingDelay = ADC_TwoSamplingDelay_5Cycles;
//    ADC_CommonInitStructure.ADC_DMAAccessMode = ADC_DMAAccessMode_Disabled; //DMA失能
//    ADC_CommonInitStructure.ADC_Prescaler = ADC_Prescaler_Div4;//预分频4分频。ADCCLK=PCLK2/4=84/4=21Mhz,ADC时钟最好不要超过36Mhz
//    ADC_CommonInit(&ADC_CommonInitStructure);

//    ADC_InitStructure.ADC_Resolution = ADC_Resolution_12b;//12位模式
//    ADC_InitStructure.ADC_ScanConvMode = DISABLE;//扫描模式
//    ADC_InitStructure.ADC_ContinuousConvMode = DISABLE;//关闭连续转换
//    ADC_InitStructure.ADC_ExternalTrigConvEdge = ADC_ExternalTrigConvEdge_None;//禁止触发检测，使用软件触发
//    ADC_InitStructure.ADC_DataAlign = ADC_DataAlign_Right;//右对齐
//    ADC_InitStructure.ADC_NbrOfConversion = 1;
//    ADC_Init(ADC3, &ADC_InitStructure);
//    ADC_Cmd(ADC3, ENABLE);//开启AD转换器
//}

//获得ADC值
//ch:通道值 0~16
//返回值:转换结果
u16 Get_Adc(u8 ch)
{
    //设置指定ADC的规则组通道，一个序列，采样时间
    ADC_RegularChannelConfig(ADC1, ch, 1, ADC_SampleTime_480Cycles );	//ADC1,ADC通道,480个周期,提高采样时间可以提高精确度
    ADC_SoftwareStartConv(ADC1);		//使能指定的ADC1的软件转换启动功能
    while(!ADC_GetFlagStatus(ADC1, ADC_FLAG_EOC ));//等待转换结束
    return ADC_GetConversionValue(ADC1);	//返回最近一次ADC1规则组的转换结果
}

//获取通道ch的转换值，取times次,然后平均
//ch:通道编号
//times:获取次数
//返回值:通道ch的times次转换结果平均值
u16 Get_Adc_Average(u8 ch, u8 times)
{
    u32 temp_val = 0;
    u8 t;
    for(t = 0; t < times; t++)
    {
        temp_val += Get_Adc(ch);
        delay_ms(5);
    }
    return temp_val / times;
}
