chiuzz/STM32/Hokai/Software/Alm/dac.h

#ifndef _DAC_H
#define _DAC_H

//-----------------------------------------------------------------------------
// 定义16位寄存器
//-----------------------------------------------------------------------------

          
//------------------------------------------------------------------------------------
// 定义函数
//------------------------------------------------------------------------------------
void DAC_PORT_Init (void);
void DAC0_Init(void);
void DAC0_CNVS_DAC0h(void);
                
#endif
