chiuzz/STM32/Hokai/Software/Ctrl/HARDWARE/inc/EEPROM.h

/******************** (C) COPYRIGHT 2007 STMicroelectronics ********************
* File Name          : i2c_ee.h
* Author             : MCD Application Team
* Version            : V1.0
* Date               : 10/08/2007
* Description        : Header for i2c_ee.c module
********************************************************************************
* THE PRESENT SOFTWARE WHICH IS FOR GUIDANCE ONLY AIMS AT PROVIDING CUSTOMERS
* WITH CODING INFORMATION REGARDING THEIR PRODUCTS IN ORDER FOR THEM TO SAVE TIME.
* AS A RESULT, STMICROELECTRONICS SHALL NOT BE HELD LIABLE FOR ANY DIRECT,
* INDIRECT OR CONSEQUENTIAL DAMAGES WITH RESPECT TO ANY CLAIMS ARISING FROM THE
* CONTENT OF SUCH SOFTWARE AND/OR THE USE MADE BY CUSTOMERS OF THE CODING
* INFORMATION CONTAINED HEREIN IN CONNECTION WITH THEIR PRODUCTS.
********************************************************************************/
/* Define to prevent recursive inclusion ------------------------------------ */
#ifndef __EEPROM_H
#define __EEPROM_H

/* Includes ------------------------------------------------------------------*/
#include "sys.h"  
#include "includes.h"

//IO方向设置
#define SDA_IN()  {GPIOB->MODER&=~(3<<(7*2));GPIOB->MODER|=0<<7*2;}	//PB9输入模式
#define SDA_OUT() {GPIOB->MODER&=~(3<<(7*2));GPIOB->MODER|=1<<7*2;} //PB9输出模式
//IO操作函数	 
#define IIC_SCL    PBout(6) //SCL
#define IIC_SDA    PBout(7) //SDA	 
#define READ_SDA   PBin(7)  //输入SDA 

//IIC所有操作函数
void IIC_Init(void);                //初始化IIC的IO口				 
void IIC_Start(void);				//发送IIC开始信号
void IIC_Stop(void);	  			//发送IIC停止信号
void IIC_Send_Byte(u8 txd);			//IIC发送一个字节
u8 IIC_Read_Byte(unsigned char ack);//IIC读取一个字节
u8 IIC_Wait_Ack(void); 				//IIC等待ACK信号
void IIC_Ack(void);					//IIC发送ACK信号
void IIC_NAck(void);				//IIC不发送ACK信号

void IIC_Write_One_Byte(u8 daddr,u8 addr,u8 data);
u8 IIC_Read_One_Byte(u8 daddr,u8 addr); 
#endif


/******************* (C) COPYRIGHT 2007 STMicroelectronics *****END OF FILE****/
