chiuzz/STM32/Hokai/Software/Ctrl/HARDWARE/inc/Target_Init.h

/**
 * @file Target_Init.h
 * @brief 
 * @author LGL
 * 0.010.1
 * @date 2015-05-04
 */
#ifndef TARGET_INIT
#define TARGET_INIT
#include "gpio.h"
#include "Iiclib.h"
#include "dac.h"
#include "adc.h"
#include "pwm.h"
#include "dac.h"
#include "adc.h"
//#include "EEPROM.h"
extern void Target_Init(void);
#endif
