chiuzz/STM32/Hokai/Software/Ctrl/HARDWARE/src/dma.c

#include "dma.h"
#include "delay.h"
//////////////////////////////////////////////////////////////////////////////////
//本程序只供学习使用，未经作者许可，不得用于其它任何用途
//ALIENTEK STM32F407开发板
//DMA 驱动代码
//正点原子@ALIENTEK
//技术论坛:www.openedv.com
//创建日期:2014/5/6
//版本：V1.0
//版权所有，盗版必究。
//Copyright(C) 广州市星翼电子科技有限公司 2014-2024
//All rights reserved
//////////////////////////////////////////////////////////////////////////////////


//DMAx的各通道配置
//这里的传输形式是固定的,这点要根据不同的情况来修改
//从存储器->外设模式/8位数据宽度/存储器增量模式
//DMA_Streamx:DMA数据流,DMA1_Stream0~7/DMA2_Stream0~7
//chx:DMA通道选择,@ref DMA_channel DMA_Channel_0~DMA_Channel_7
//par:外设地址
//mar:存储器地址
//ndtr:数据传输量
void MYDMA_Config(DMA_Stream_TypeDef *DMA_Streamx, u32 chx, u32 par, u32 mar, u16 ndtr)
{

    DMA_InitTypeDef  DMA_InitStructure;

    if((u32)DMA_Streamx > (u32)DMA2) //得到当前stream是属于DMA2还是DMA1
    {
        RCC_AHB1PeriphClockCmd(RCC_AHB1Periph_DMA2, ENABLE); //DMA2时钟使能

    } else
    {
        RCC_AHB1PeriphClockCmd(RCC_AHB1Periph_DMA1, ENABLE); //DMA1时钟使能
    }
    DMA_DeInit(DMA_Streamx);

    while (DMA_GetCmdStatus(DMA_Streamx) != DISABLE) {} //等待DMA可配置

    /* 配置 DMA Stream */
    DMA_InitStructure.DMA_Channel = chx;  //通道选择
    DMA_InitStructure.DMA_PeripheralBaseAddr = par;//DMA外设地址
    DMA_InitStructure.DMA_Memory0BaseAddr = mar;//DMA 存储器0地址
    DMA_InitStructure.DMA_DIR = DMA_DIR_MemoryToPeripheral;//存储器到外设模式
    DMA_InitStructure.DMA_BufferSize = ndtr;//数据传输量
    DMA_InitStructure.DMA_PeripheralInc = DMA_PeripheralInc_Disable;//外设非增量模式
    DMA_InitStructure.DMA_MemoryInc = DMA_MemoryInc_Enable;//存储器增量模式
    DMA_InitStructure.DMA_PeripheralDataSize = DMA_PeripheralDataSize_Byte;//外设数据长度:8位
    DMA_InitStructure.DMA_MemoryDataSize = DMA_MemoryDataSize_Byte;//存储器数据长度:8位
    DMA_InitStructure.DMA_Mode = DMA_Mode_Normal;// 使用普通模式
    DMA_InitStructure.DMA_Priority = DMA_Priority_Medium;//中等优先级
    DMA_InitStructure.DMA_FIFOMode = DMA_FIFOMode_Disable;
    DMA_InitStructure.DMA_FIFOThreshold = DMA_FIFOThreshold_Full;
    DMA_InitStructure.DMA_MemoryBurst = DMA_MemoryBurst_Single;//存储器突发单次传输
    DMA_InitStructure.DMA_PeripheralBurst = DMA_PeripheralBurst_Single;//外设突发单次传输
    DMA_Init(DMA_Streamx, &DMA_InitStructure);//初始化DMA Stream


}
//开启一次DMA传输
//DMA_Streamx:DMA数据流,DMA1_Stream0~7/DMA2_Stream0~7
//ndtr:数据传输量
void MYDMA_Enable(DMA_Stream_TypeDef *DMA_Streamx, u16 ndtr)
{

    DMA_Cmd(DMA_Streamx, DISABLE);                      //关闭DMA传输

    while (DMA_GetCmdStatus(DMA_Streamx) != DISABLE) {}	//确保DMA可以被设置

    DMA_SetCurrDataCounter(DMA_Streamx, ndtr);         //数据传输量

    DMA_Cmd(DMA_Streamx, ENABLE);                      //开启DMA传输
}
