chiuzz/STM32/Hokai/Software/Ctrl/HARDWARE/src/exti.c

#include "exti.h"
#include "delay.h" 
#include "ModuleIpc.h"

//外部中断0服务程序
void EXTI0_IRQHandler(void)
{
 
//	 ExtiHandlerProc();
	 EXTI_ClearITPendingBit(EXTI_Line0); //清除LINE0上的中断标志位 
}	
  
void ExitIo_Init(void)
{
	GPIO_InitTypeDef  GPIO_InitStructure;
	RCC_AHB1PeriphClockCmd(RCC_AHB1Periph_GPIOA, ENABLE);	//使能GPIOA,GPIOE时钟	 
  GPIO_InitStructure.GPIO_Pin = GPIO_Pin_0;							//WK_UP对应引脚PA0
  GPIO_InitStructure.GPIO_PuPd = GPIO_PuPd_UP ;					//下拉
	GPIO_InitStructure.GPIO_Mode = GPIO_Mode_IN;
  GPIO_Init(GPIOA, &GPIO_InitStructure);								//初始化GPIOA0
} 

void SetExtiStatus(FunctionalState sta)
{
	NVIC_InitTypeDef   NVIC_InitStructure;
	NVIC_InitStructure.NVIC_IRQChannel = EXTI0_IRQn;//外部中断0
  NVIC_InitStructure.NVIC_IRQChannelPreemptionPriority = 0x00;//抢占优先级0
  NVIC_InitStructure.NVIC_IRQChannelSubPriority = 0x02;//子优先级2
  NVIC_InitStructure.NVIC_IRQChannelCmd = sta;//使能外部中断通道
  NVIC_Init(&NVIC_InitStructure);//配置
}
//外部中断初始化程序
//初始化PE2~4,PA0为中断输入.
void EXTIX_Init(void)
{
	EXTI_InitTypeDef   EXTI_InitStructure;	
	ExitIo_Init(); //按键对应的IO口初始化
	RCC_APB2PeriphClockCmd(RCC_APB2Periph_SYSCFG, ENABLE);//使能SYSCFG时钟

	SYSCFG_EXTILineConfig(EXTI_PortSourceGPIOA, EXTI_PinSource0);//PA0 连接到中断线0
	
  /* 配置EXTI_Line0 */
  EXTI_InitStructure.EXTI_Line = EXTI_Line0;//LINE0
  EXTI_InitStructure.EXTI_Mode = EXTI_Mode_Interrupt;//中断事件
  EXTI_InitStructure.EXTI_Trigger = EXTI_Trigger_Rising; //上升沿触发 
  EXTI_InitStructure.EXTI_LineCmd = ENABLE;//使能LINE0
  EXTI_Init(&EXTI_InitStructure);//配置
	
	SetExtiStatus(DISABLE);
}
