chiuzz/STM32/(commit log)

2019-06-08 删除测试
2019-06-08 上传原子的Ucosiii移植工程
2019-06-08 第四章相关注释: 1、用于保存中断状态的变量； 2、临界段保护代码； 3、测量中断关闭时间功能； 4、临界段保护方式及测量调度器锁定时间功能。
2019-06-09 第三章相关注释: 1、OSTaskCreate函数的opt参数； 2、OSTaskCreate函数部分注释； 3、创建任务流程注释。
2019-06-10 第五章部分注释: 1、时钟节拍中断函数； 2、TCB数据结构的部分注释； 3、空闲任务，时钟节拍任务初始化； 4、OSTaskCreate函数部分注释； 5、OS_TickTask时钟节拍任务。
2019-06-10 上传keil代码格式化工具。
2019-06-10 删除原代码，该工程今后用于ucosiii练习。
2019-06-10 创建任务练习，并且练习使用OSTimeDlyHMSM函数。
2019-06-10 任务挂起和恢复实验。
2019-06-10 库函数: OSInit,OSTaskCreate,OSStart,OSTimeDlyHMSM,OSTaskSuspend,OSTaskResume
2019-06-10 删除任务实验。
2019-06-10 时间片轮转调度实验，使用OSSchedRoundRobinCfg函数。
2019-06-10 测试OSSchedRoundRobinYield函数。
2019-06-11 Squashed commit of the following:
    commit 51972a00ffd5d5f2eb46525ecc7e99d4b8fcc9d9
    Author: Chiuzz_ <409352418@qq.com>
    Date: Mon Jun 10 23:50:37 2019 +0800
    测试OSSchedRoundRobinYield函数。
    commit 6ef9c305decd0ba317a102571bff63888d0cc42c
    Author: Chiuzz_ <409352418@qq.com>
    Date: Mon Jun 10 23:29:22 2019 +0800
    时间片轮转调度实验，使用OSSchedRoundRobinCfg函数。
    commit 8372e0f2f014603970e89301eed1d4145c799dbb
    Author: Chiuzz_ <409352418@qq.com>
    Date: Mon Jun 10 16:23:20 2019 +0800
    commit 27407a9b0647a77aa0e733e4d99c20709137387c
    Author: Chiuzz_ <409352418@qq.com>
    Date: Mon Jun 10 16:00:01 2019 +0800
    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
2019-06-11 上传部分注释
2019-06-11 添加串口2驱动和测试程序。
2019-06-11 修改打印任意输入的字符串，扩大栈空间防止溢出。
2019-06-11 中断管理相关注释。
2019-06-12 信号量:直接访问共享资源区实验。
2019-06-12 信号量:使用信号量访问共享资源区实验。
2019-06-12 信号量:任务同步及优先级反转实验。
2019-06-16 消息队列实验。
2019-06-16 上次Hokai项目。
    [ADC_Isolation.SchDoc, AD_Data2017年02月23日15时30分40秒.xlsx, AD_Data2017年02月27日11时44分09秒.xlsx, AD_Data2017年03月02日15时59分57秒.xlsx, AD_Data2017年03月02日16时00分35秒.xlsx, AD_POWER.SchDoc, CPU_CONTROL.SchDoc, HGT-300-1.xls]
2019-06-16 整理ucos文件。
2019-06-30 基于 Micrium_STM32xxx_uCOS-II.zip，成功移植ucosii到M0。
2019-07-01 创建m4项目。
2019-07-01 STM32F4器件包
2019-07-01 新建项目Template。
2019-07-01 上传库函数。
2019-07-01 完善core文件夹，有空研究下这四个CMSIS相关文件。
2019-07-01 完善user文件夹。
2019-07-01 修改工程配置。
2019-07-01 格式化并修复报错。
2019-07-01 修改时钟配置。
2019-07-01 完善SYSTEM文件夹
2019-07-01 时钟配置相关注释。
2019-07-02 移植FreeRTOS到模板工程，创建单任务—SRAM 静态内存实验。
2019-07-02 修复上一版本报错。
2019-07-02 创建单任务—SRAM 动态内存实验。
2019-07-03 整理led驱动并实现呼吸灯。
2019-07-03 修改报错。
2019-07-03 添加蜂鸣器驱动并实现“滴”声功能。
2019-07-03 添加按键驱动，可判断长按短按。
2019-07-04 移植原子的LCD驱动到本工程。
2019-07-04 移植原子的SMART组件，方便今后调试。
2019-07-07 改用串口2打印log，串口1暂时用于串口WiFi调试。
2019-07-09 添加串口3驱动，准备用于与ESP8266通讯。
2019-07-09 打开串口3空闲中断。
2019-07-10 1、存储ESP8266返回的字符串信息，并解码； 2、实现按键触发AT测试指令。
2019-07-14 完成部分AT指令字符串解析函数，实现了sta模式下作为client连接TCP服务器的流程。
2019-07-16 把接收到的字符串转换成命令，并实现远端发命令控制led的功能。
2019-07-19 添加删除选项。
2019-07-20 实现连接Tlink服务器，通过手机端APP从外网操控LED和读取LED状态。
2019-07-22 上传FreeRTOS源码。
2019-08-07 flash操作实验 问题总结:操作的地址要跟设定的访问宽度对应上否则写操作失败, 例如，数据宽度为半字，地址为2的倍数，宽度为字，地址为4的倍数。
