chiuzz/STM32/(notices)

Notices in the files:
Hokai/Software/Ctrl/HARDWARE/src/stmflash.c:
Copyright(C) ¹ãÖÝÊÐÐÇÒíµç×Ó¿Æ¼¼ÓÐÏÞ¹«Ë¾ 2014-2024
All rights reserved
